TheByteAttic/TalosES/ALU card/Photos/IMG_3750.jpeg

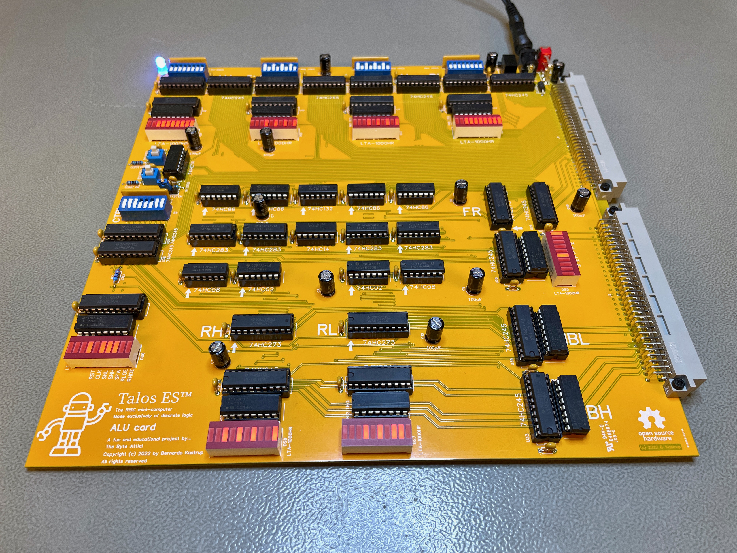
ALU card/Photos/IMG_3750.jpeg
