TheByteAttic/TalosES/AL card/Photos/IMG_1605.jpeg

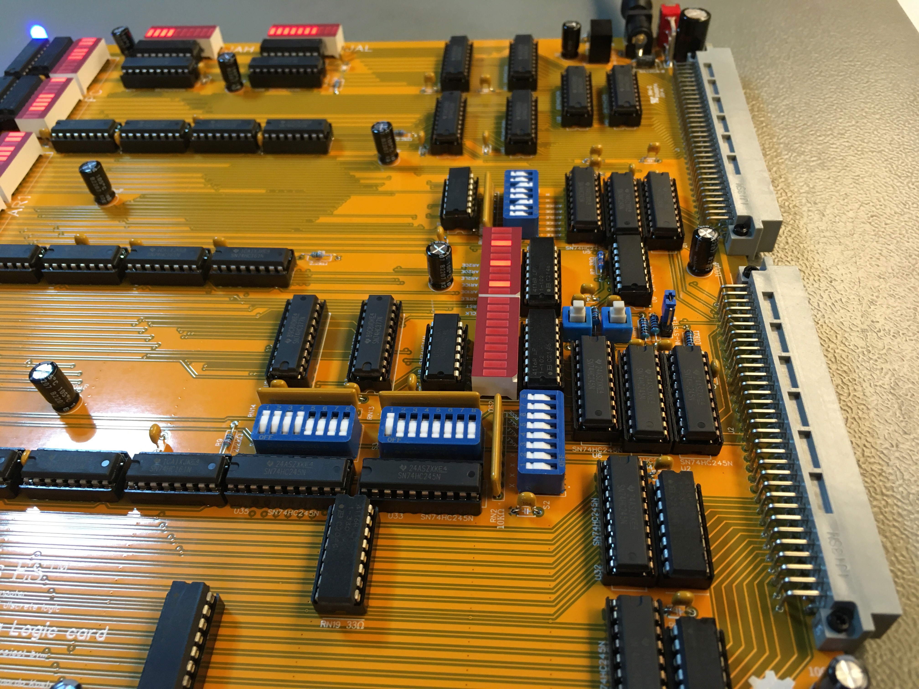
AL card/Photos/IMG_1605.jpeg
