TheByteAttic/TalosES/CTRL card/Photos/README.md

These are photos of a correctly assembled control card that could be used as reference for your assembling your own.
<p><br>
<b>ATTENTION:</b> The board illustrated in these photos differs slightly from the updated version (Gerber files) in this repository. This should be immaterial as far as using these photos as guidance during assembly is concerned, but you might note small differences.
