TheByteAttic/TalosES/CTRL card/DMs/README.md

Here you can find the binary (.bin) files for programming the four Decoding Memories (DMs) of Talos ES™'s control card. The devices I used have product number SST39SF020A.
