TheByteAttic/TalosES/Simulations/README.md

These directories contain the <a href="https://github.com/logisim-evolution/logisim-evolution">LogiSim-Evolution</a> source files of Talos ES™.
