TheByteAttic/TalosES/ISA/README.md

This directory contains the spreadsheet (in both Excel and CSV formats) documenting Talos ES™'s CPU instructions.
