TheByteAttic/TalosES/Third-party documentation/README.md

Datasheets of some of the less common parts used in Talos ES™, as well as other relevant documentation from third-parties.
