TheByteAttic/TalosES/Simulations/Motherboard/README.md

These LogiSim-Evolution files simulate only small segments of Talos ES™'s motherboard circuitry, <i>not</i> the complete motherboard.
They are mostly for illustration purposes, as they have been used <a href="https://youtu.be/EE-lTyt0x98">in a video</a> and viewers may want to study them more closely.
<p>
The LogiSim-Evolution repository <a href="https://github.com/logisim-evolution/logisim-evolution">can be found here.</a>
