TheByteAttic/TalosES/AL card/Photos/IMG_1593.jpeg

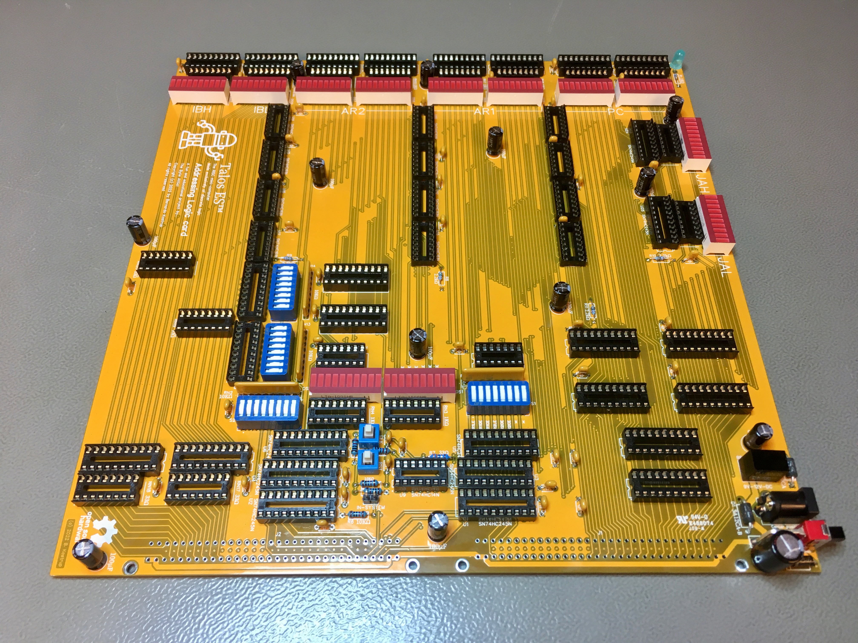
AL card/Photos/IMG_1593.jpeg
