TheByteAttic/TalosES/AL card/Photos/IMG_1594.jpeg

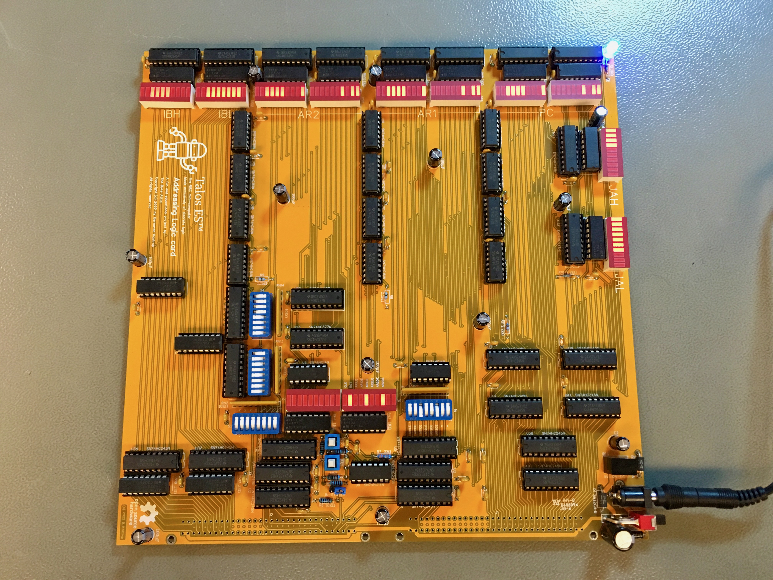
AL card/Photos/IMG_1594.jpeg
