TheByteAttic/TalosES/AL card/Photos/IMG_1595.jpeg

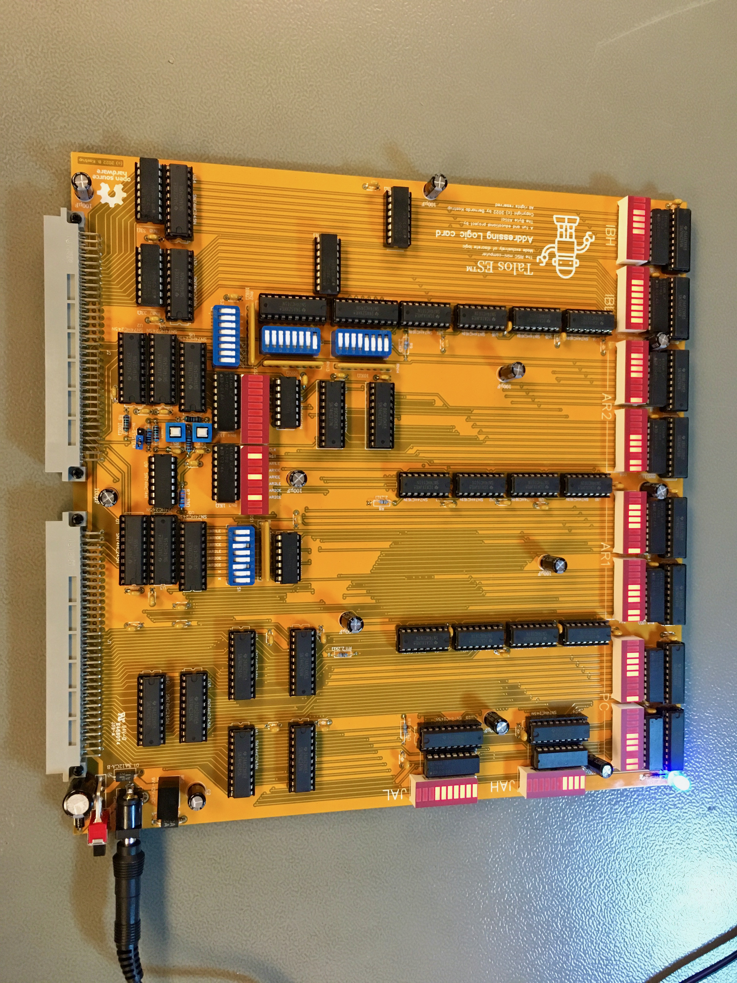
AL card/Photos/IMG_1595.jpeg
