TheByteAttic/TalosES/AL card/Photos/IMG_1597.jpeg

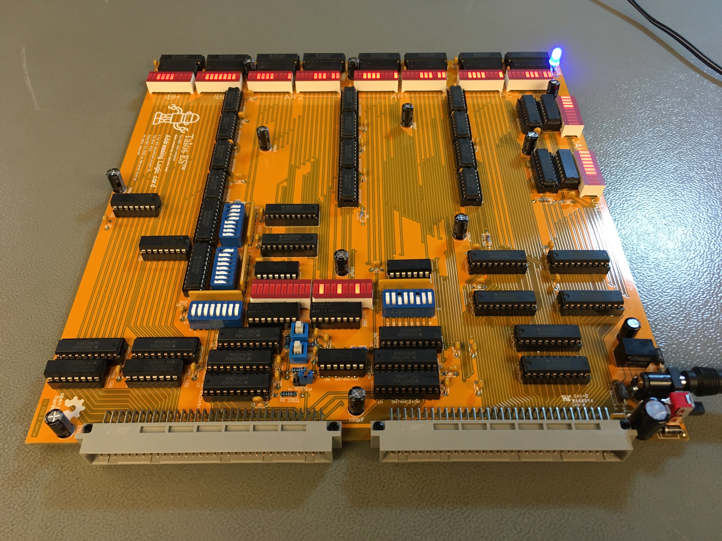
AL card/Photos/IMG_1597.jpeg
