TheByteAttic/TalosES/AL card/Photos/IMG_1598.jpeg

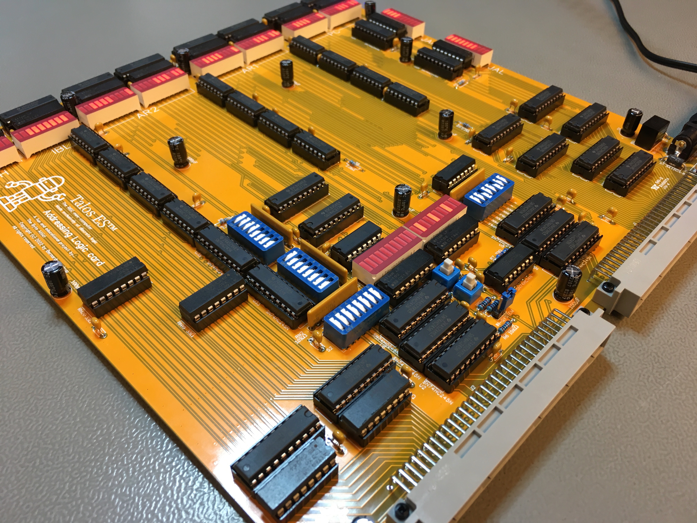
AL card/Photos/IMG_1598.jpeg
