TheByteAttic/TalosES/AL card/Photos/IMG_1599.jpeg

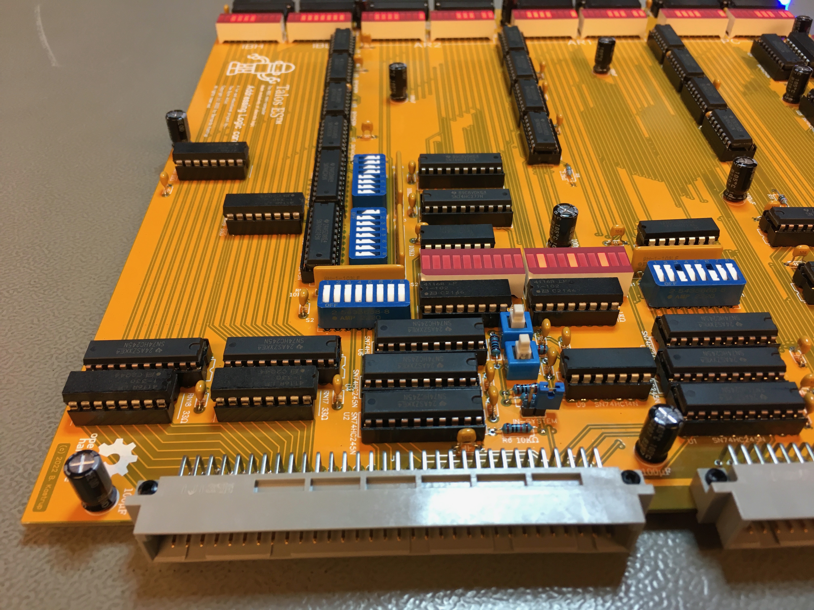
AL card/Photos/IMG_1599.jpeg
