TheByteAttic/TalosES/AL card/Photos/IMG_1600.jpeg

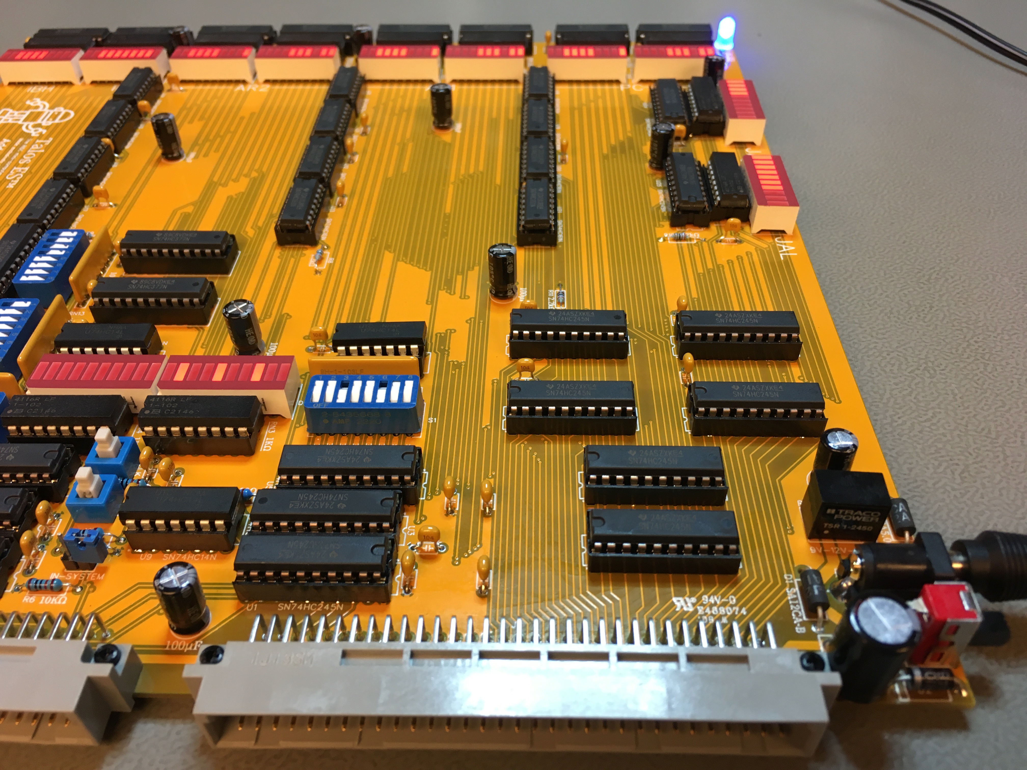
AL card/Photos/IMG_1600.jpeg
