TheByteAttic/TalosES/AL card/Photos/IMG_1601.jpeg

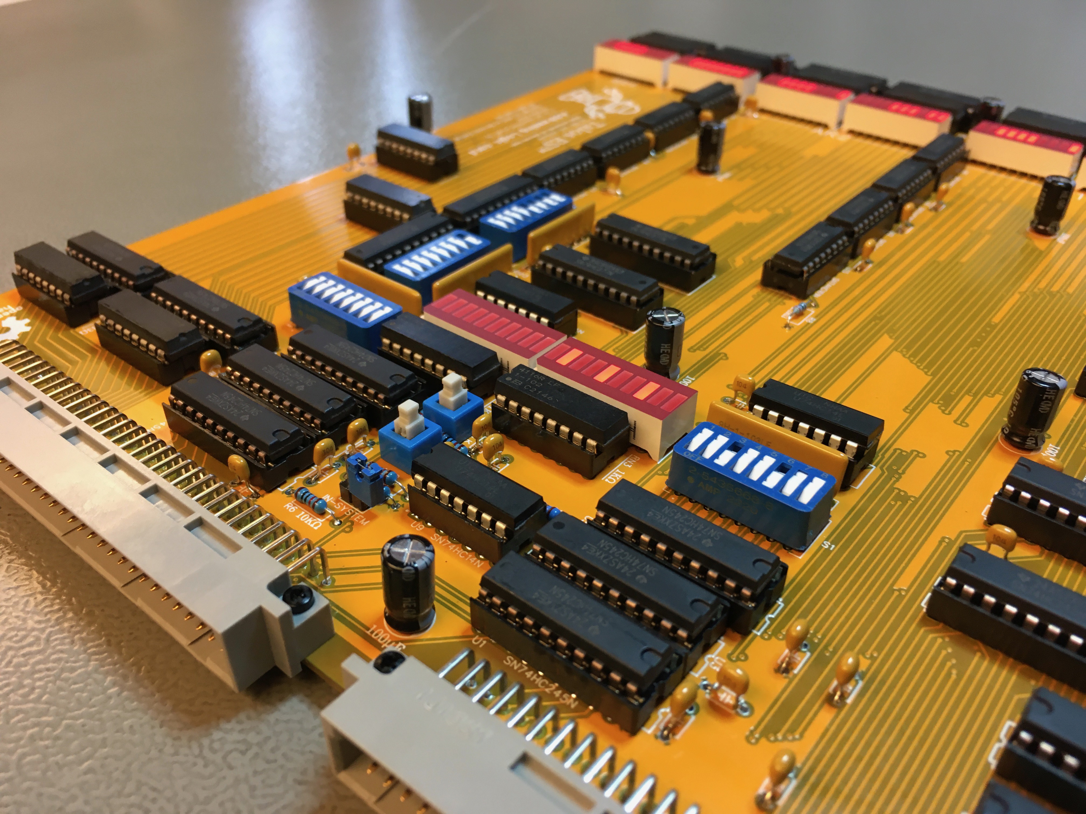
AL card/Photos/IMG_1601.jpeg
