TheByteAttic/TalosES/AL card/Photos/IMG_1602.jpeg

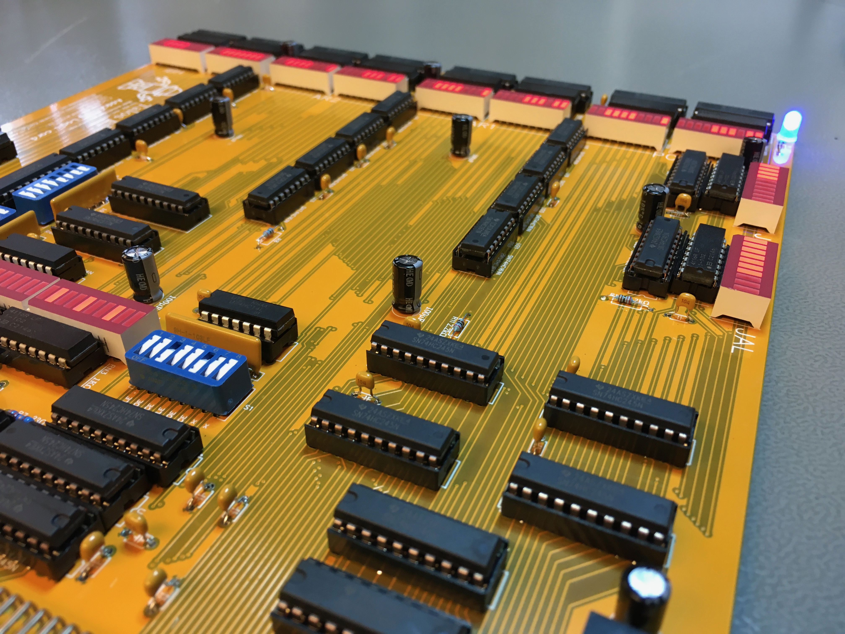
AL card/Photos/IMG_1602.jpeg
