TheByteAttic/TalosES/AL card/Photos/IMG_1603.jpeg

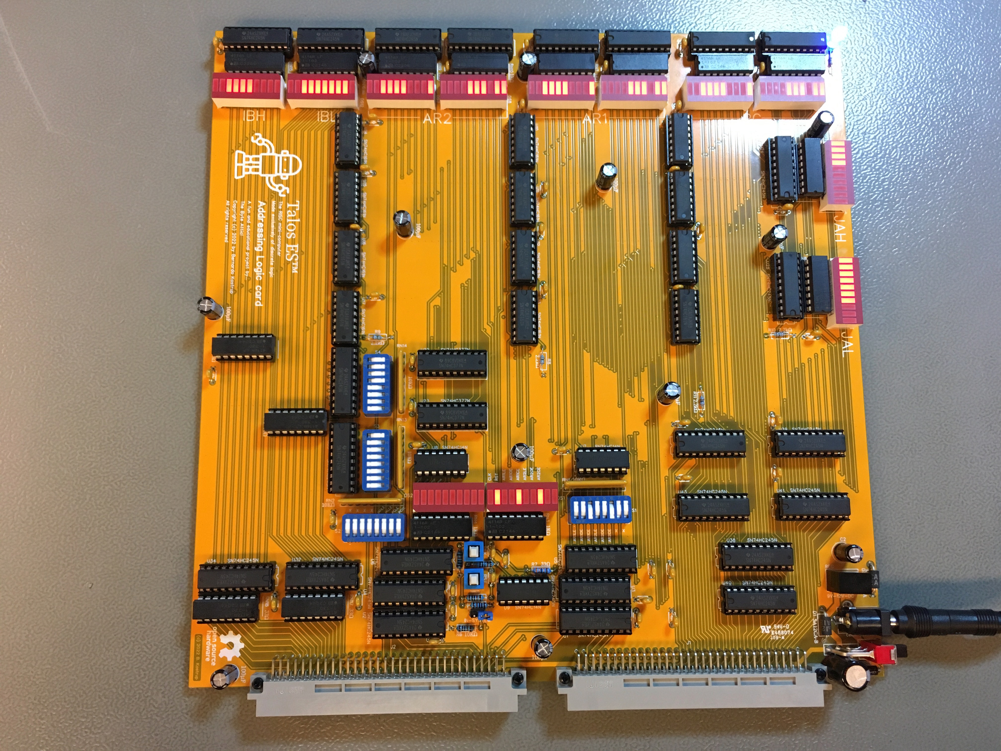
AL card/Photos/IMG_1603.jpeg
