TheByteAttic/TalosES/AL card/Photos/IMG_1604.jpeg

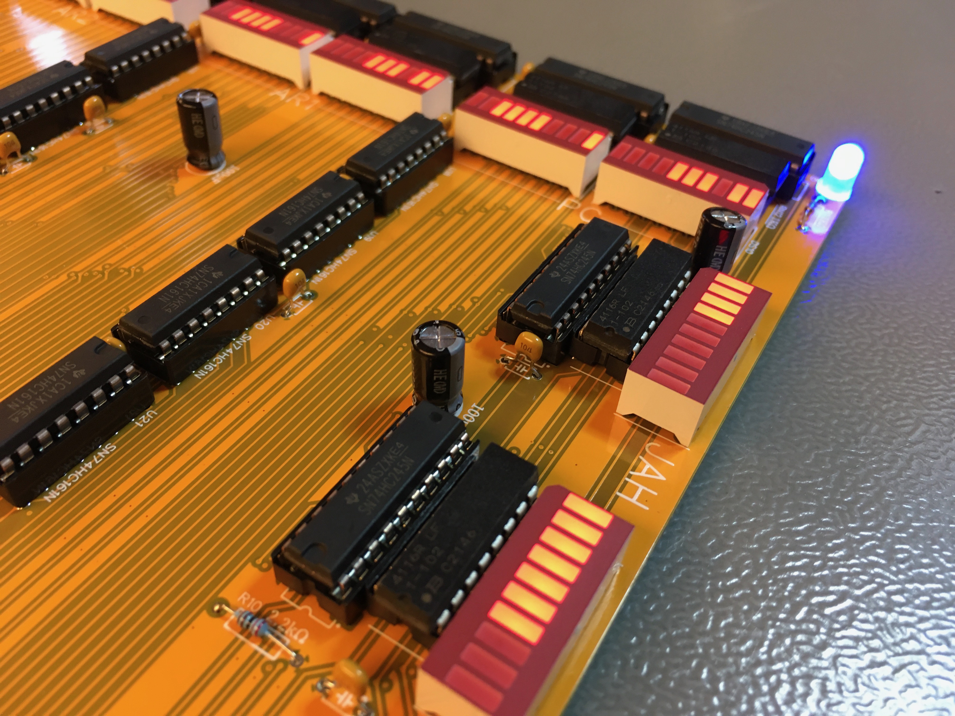
AL card/Photos/IMG_1604.jpeg
