TheByteAttic/TalosES/AL card/Photos/IMG_1606.jpeg

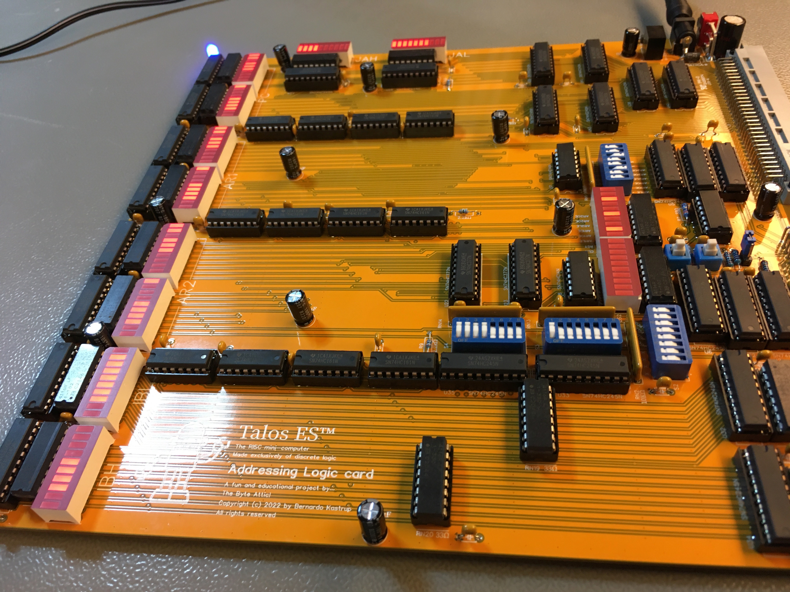
AL card/Photos/IMG_1606.jpeg
