TheByteAttic/TalosES/AL card/Photos/IMG_1607.jpeg

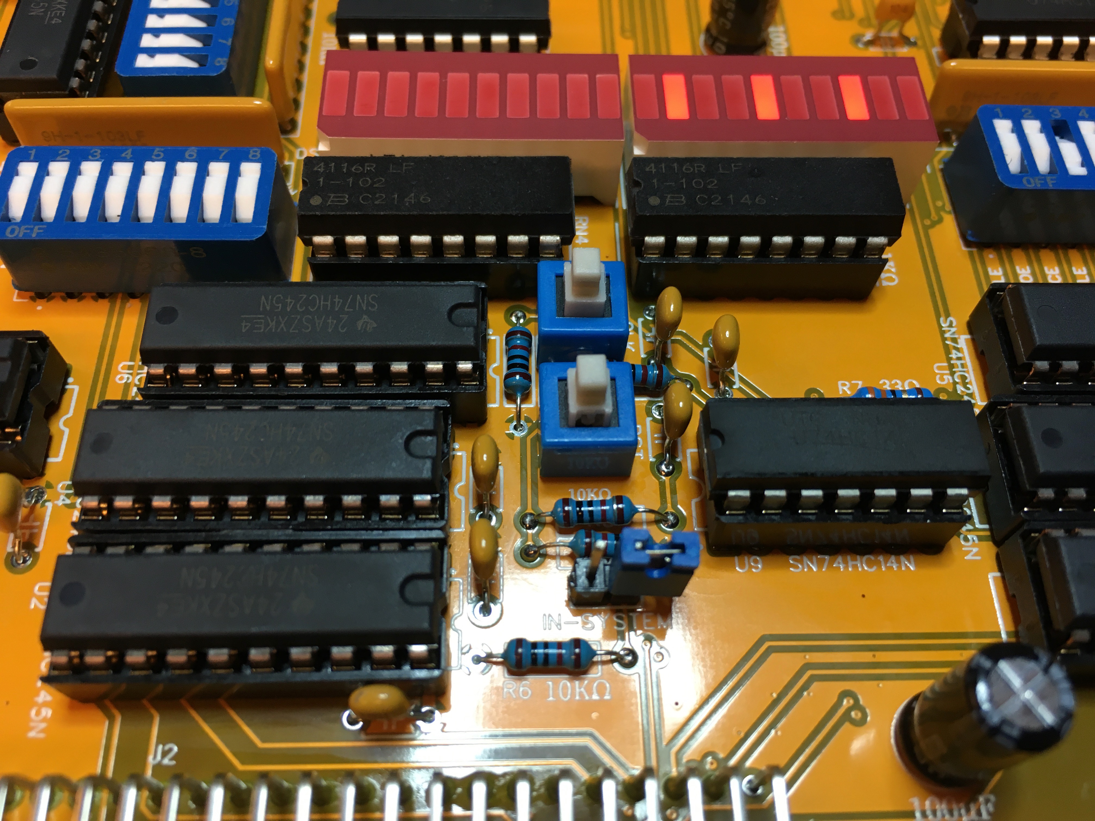
AL card/Photos/IMG_1607.jpeg
