TheByteAttic/TalosES/AL card/Photos/IMG_1608.jpeg

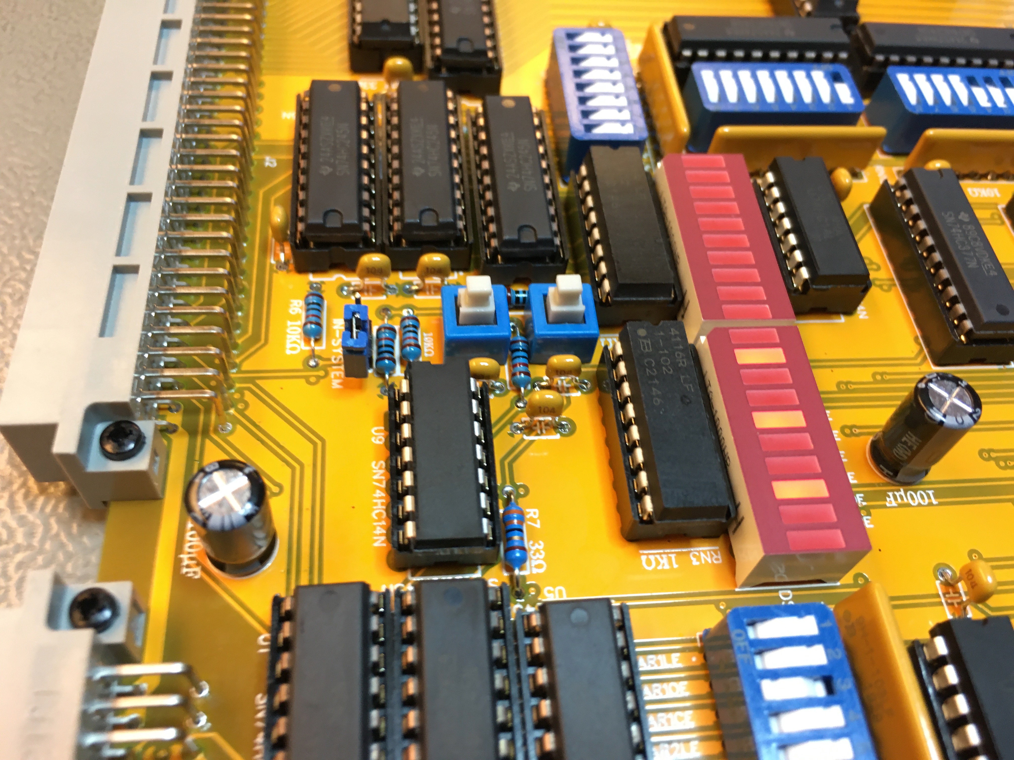
AL card/Photos/IMG_1608.jpeg
