TheByteAttic/TalosES/AL card/Photos/IMG_1609.jpeg

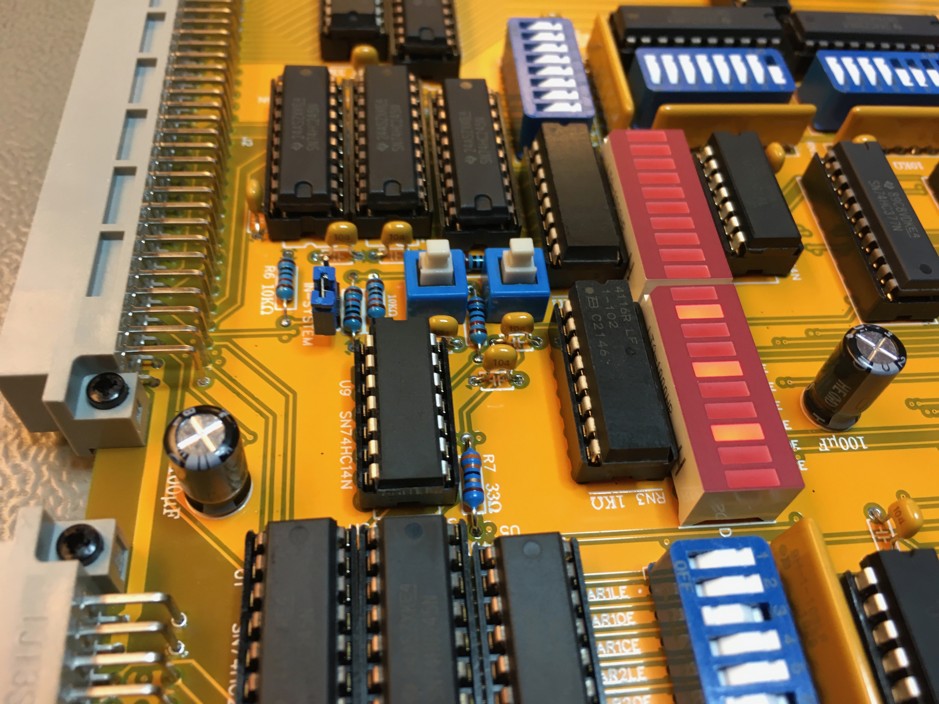
AL card/Photos/IMG_1609.jpeg
