TheByteAttic/TalosES/AL card/Photos/IMG_1610.jpeg

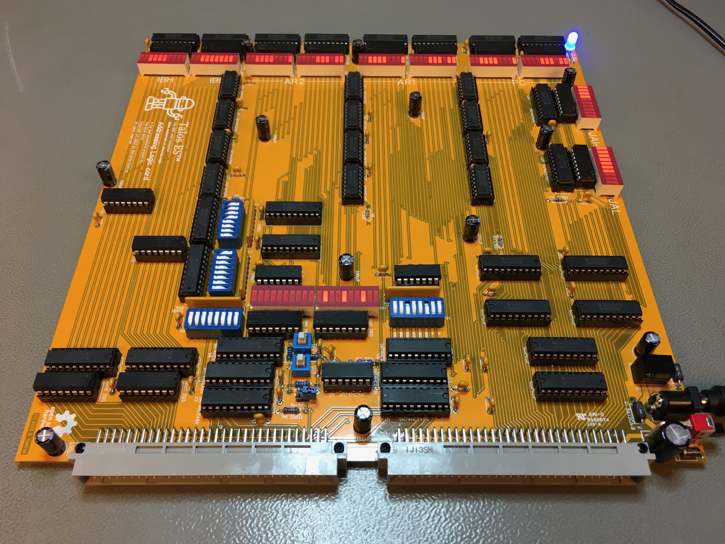
AL card/Photos/IMG_1610.jpeg
