TheByteAttic/TalosES/AL card/Photos/IMG_1611.jpeg

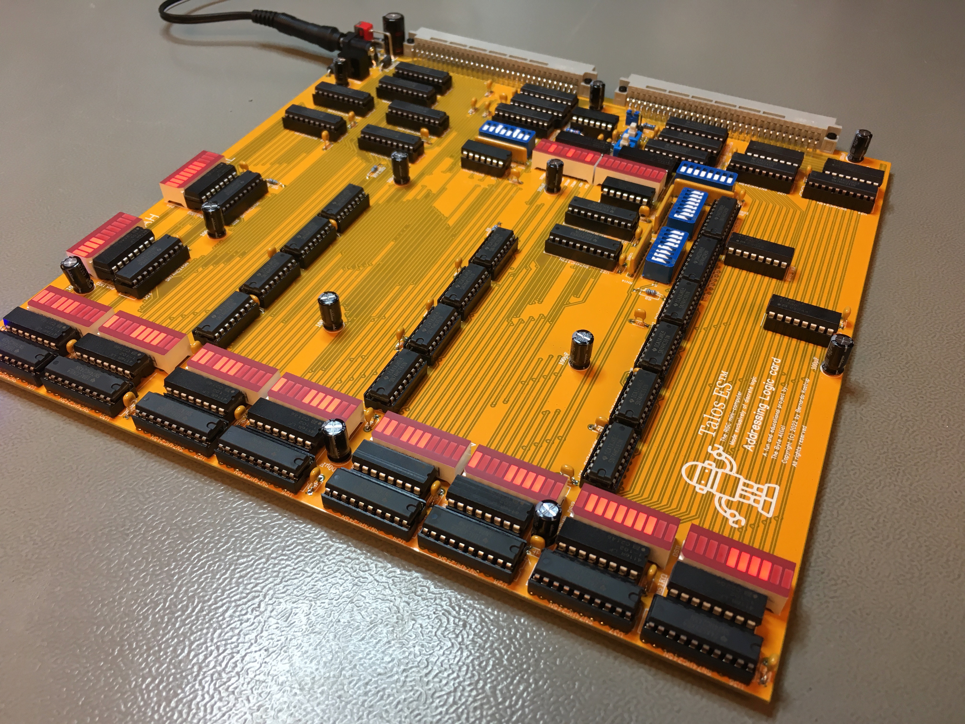
AL card/Photos/IMG_1611.jpeg
