TheByteAttic/TalosES/AL card/Photos/IMG_1612.jpeg

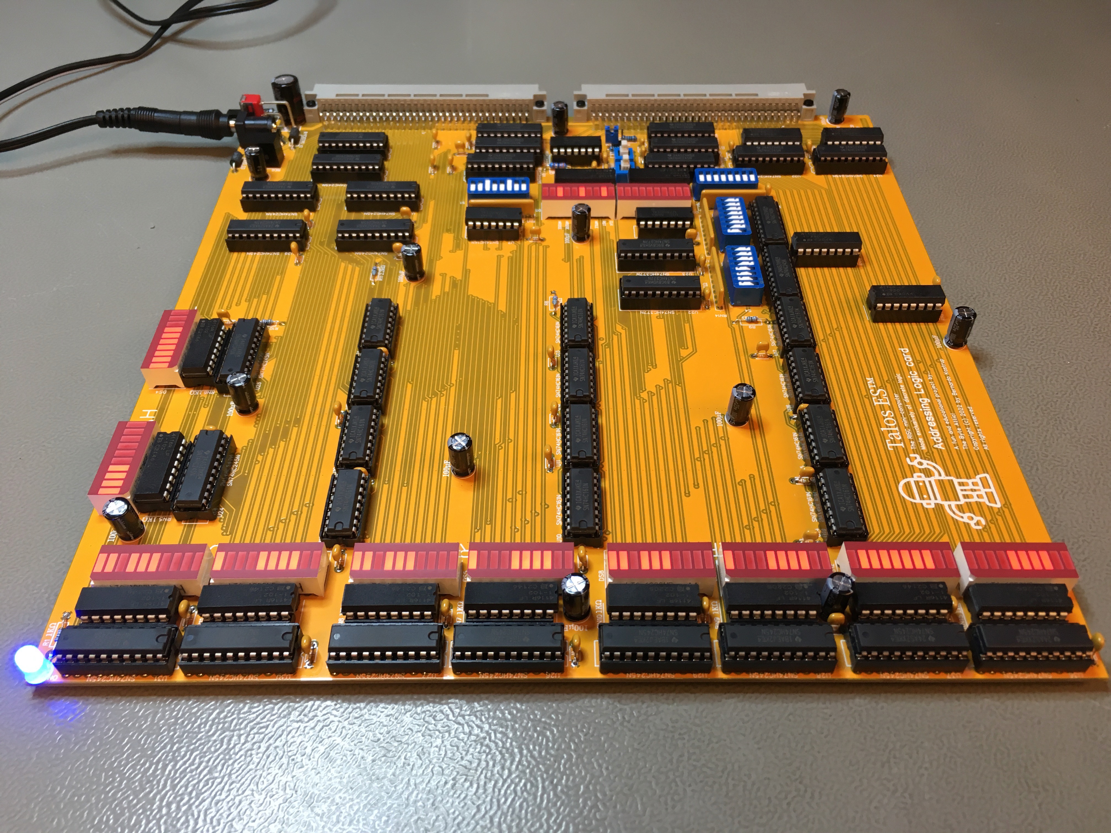
AL card/Photos/IMG_1612.jpeg
