TheByteAttic/TalosES/AL card/Photos/IMG_1613.jpeg

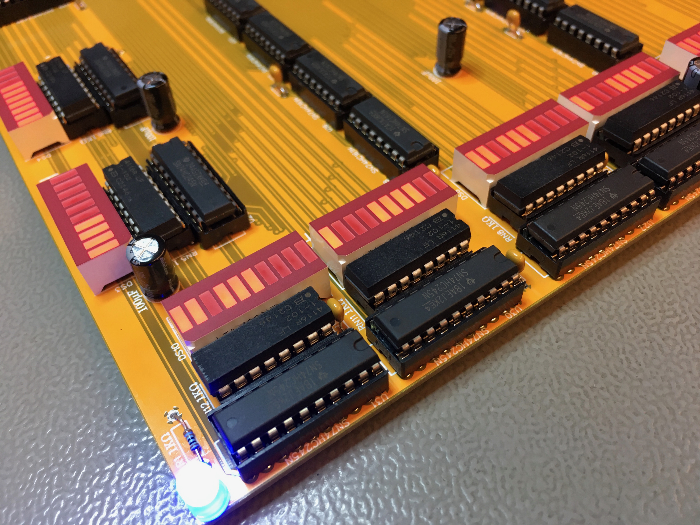
AL card/Photos/IMG_1613.jpeg
