TheByteAttic/TalosES/AL card/Photos/IMG_1614.jpeg

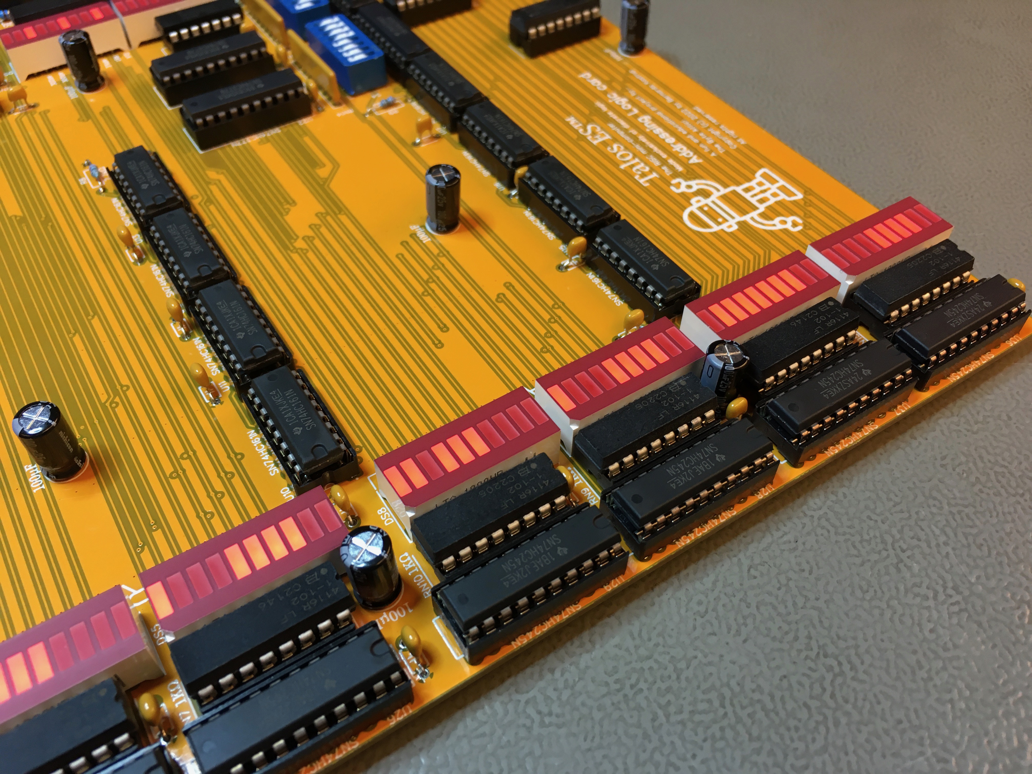
AL card/Photos/IMG_1614.jpeg
