TheByteAttic/TalosES/AL card/Photos/IMG_1615.jpeg

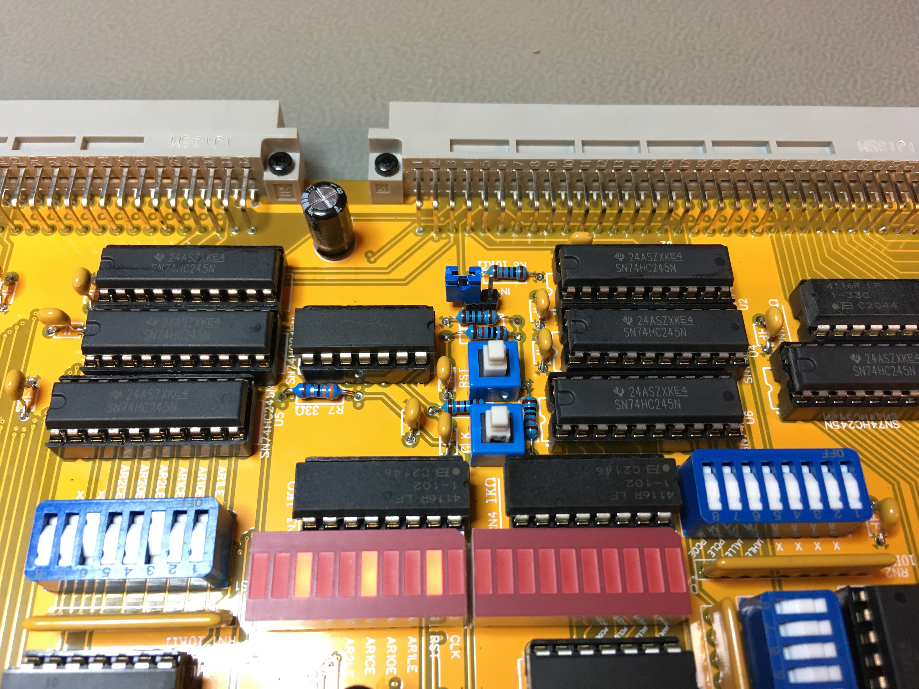
AL card/Photos/IMG_1615.jpeg
