TheByteAttic/TalosES/AL card/Photos/IMG_1616.jpeg

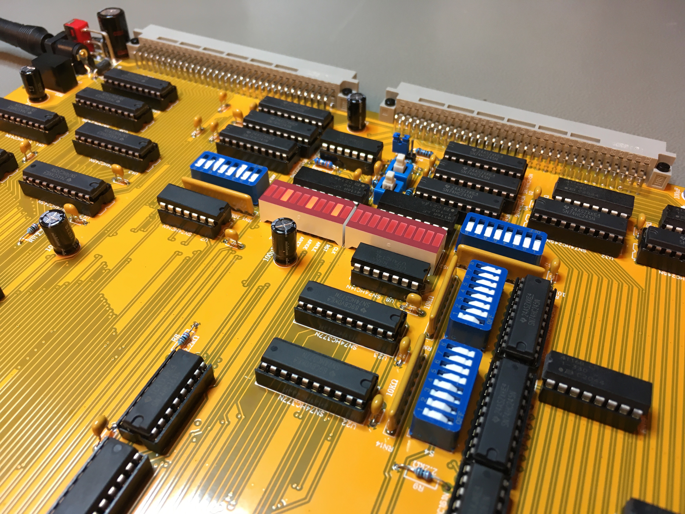
AL card/Photos/IMG_1616.jpeg
