TheByteAttic/TalosES/AL card/Photos/IMG_1617.jpeg

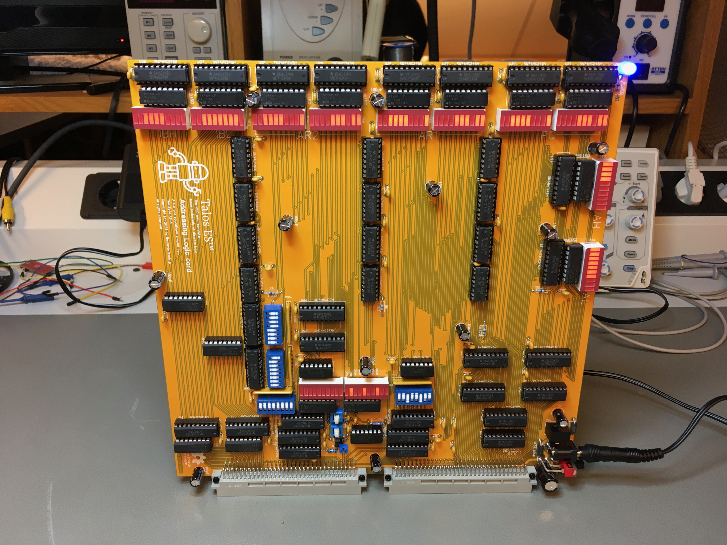
AL card/Photos/IMG_1617.jpeg
