TheByteAttic/TalosES/AL card/Photos/IMG_1618.jpeg

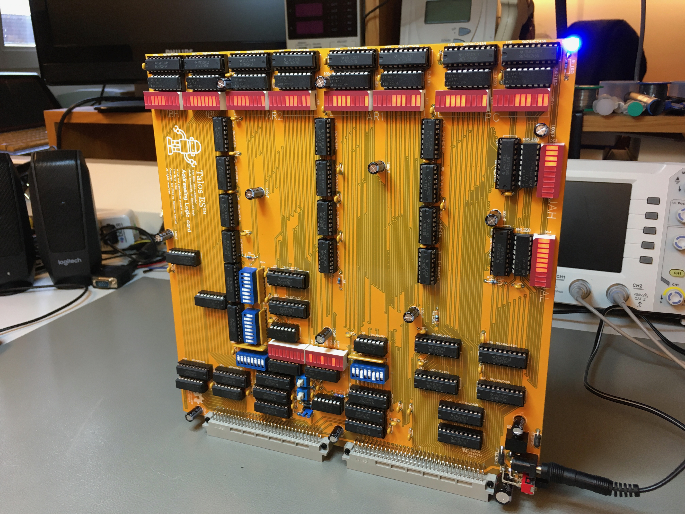
AL card/Photos/IMG_1618.jpeg
