TheByteAttic/TalosES/AL card/Photos/IMG_1619.jpeg

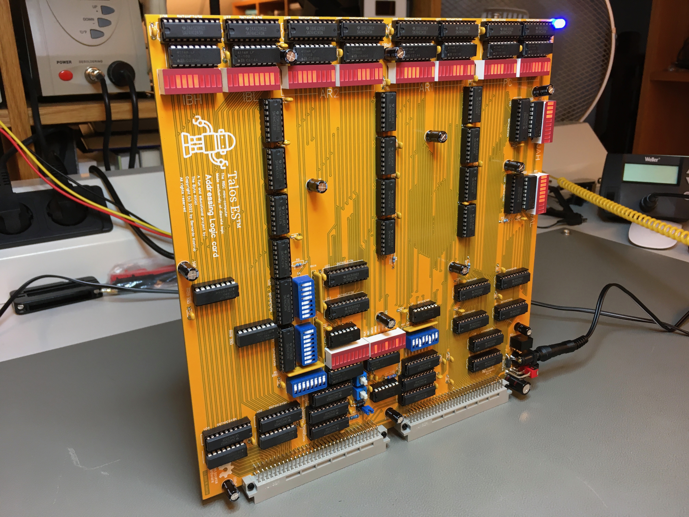
AL card/Photos/IMG_1619.jpeg
