TheByteAttic/TalosES/AL card/Photos/IMG_1620.jpeg

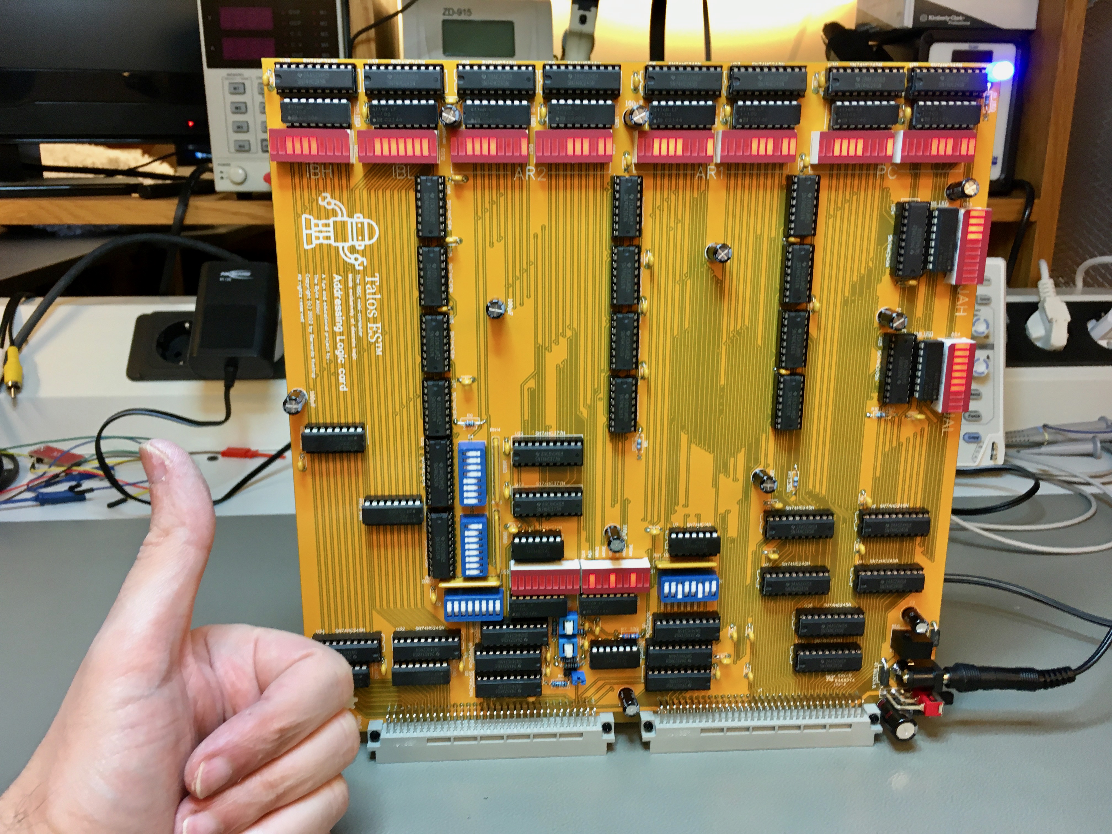
AL card/Photos/IMG_1620.jpeg
