TheByteAttic/TalosES/ALU card/Photos/IMG_3749.jpeg

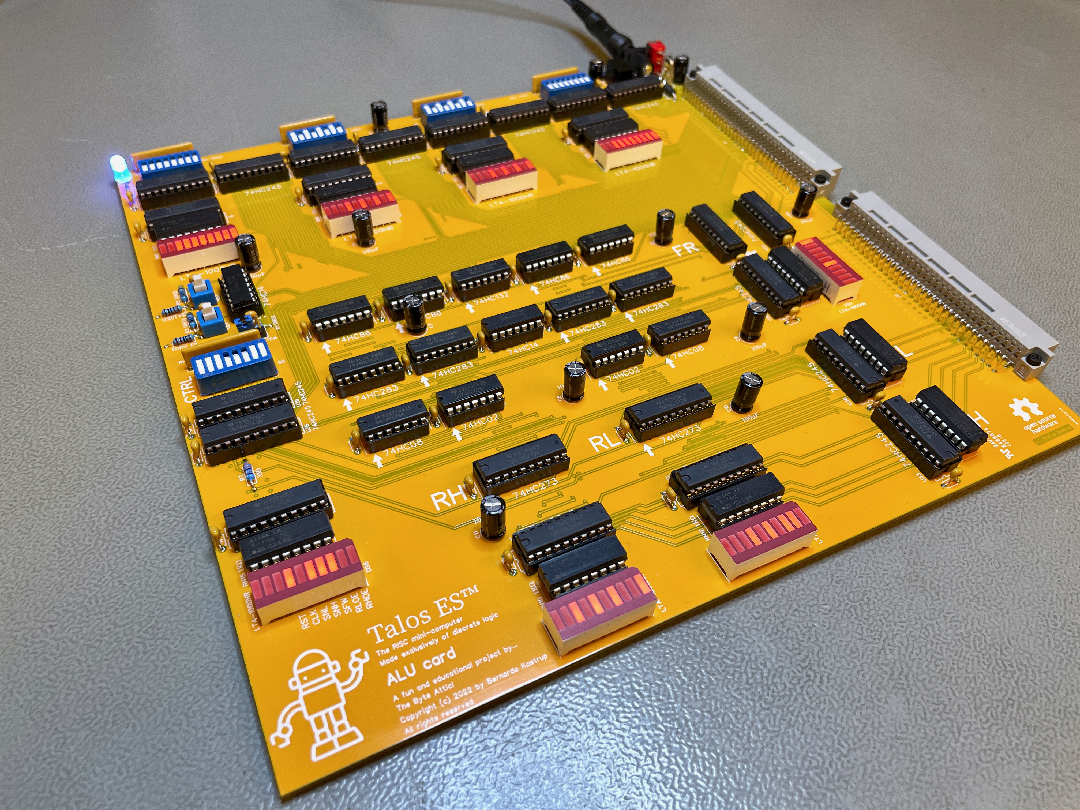
ALU card/Photos/IMG_3749.jpeg
