TheByteAttic/TalosES/ALU card/Photos/IMG_3751.jpeg

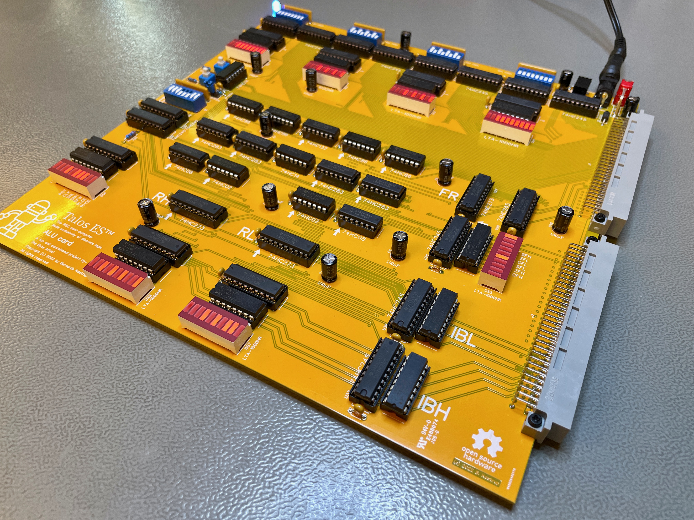
ALU card/Photos/IMG_3751.jpeg
