TheByteAttic/TalosES/ALU card/Photos/IMG_3752.jpeg

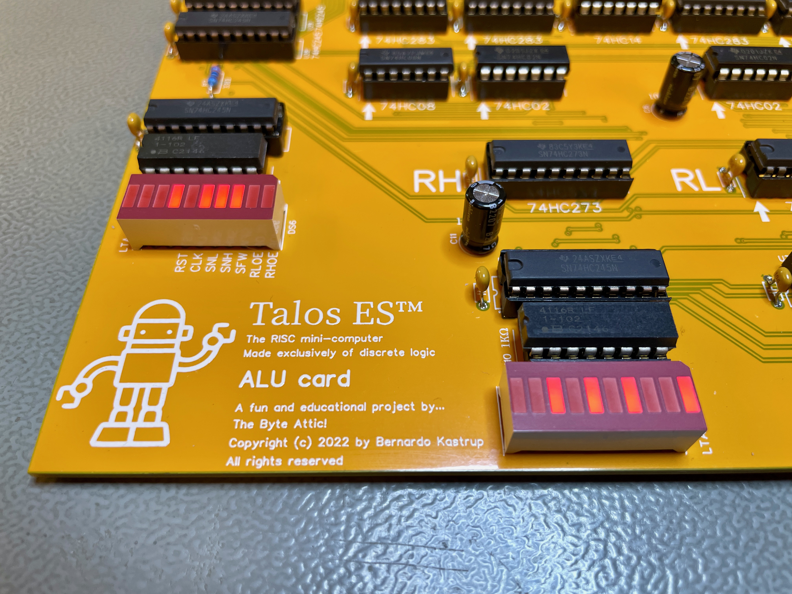
ALU card/Photos/IMG_3752.jpeg
