TheByteAttic/TalosES/ALU card/Photos/IMG_3753.jpeg

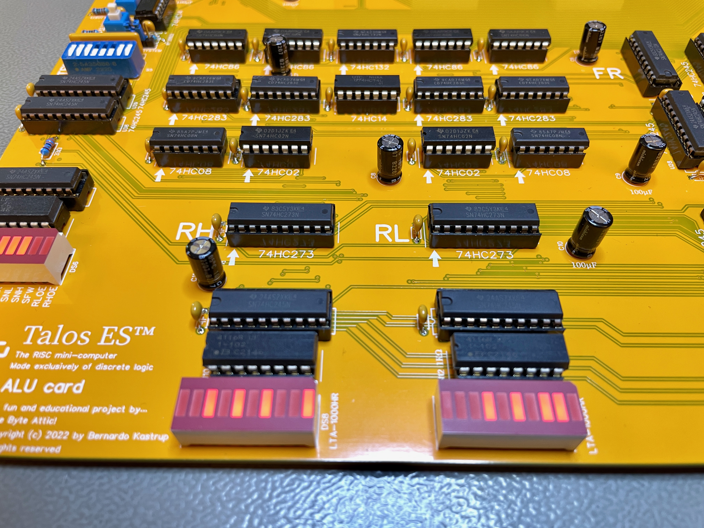
ALU card/Photos/IMG_3753.jpeg
