TheByteAttic/TalosES/ALU card/Photos/IMG_3754.jpeg

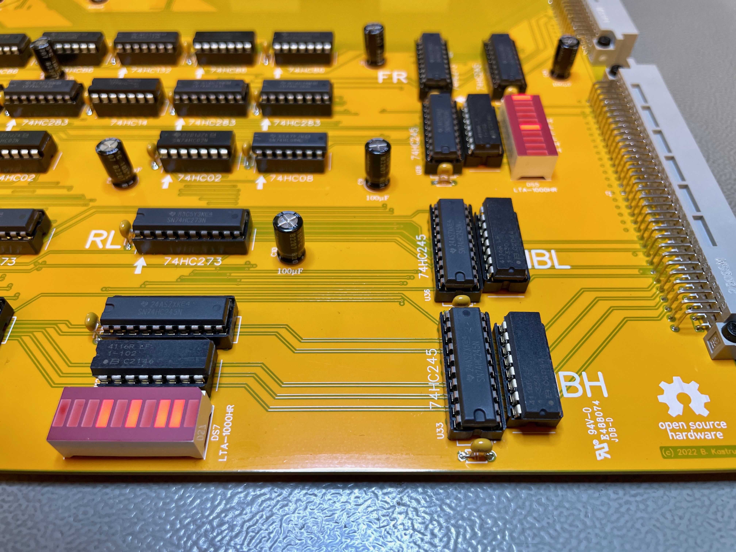
ALU card/Photos/IMG_3754.jpeg
