TheByteAttic/TalosES/ALU card/Photos/IMG_3755.jpeg

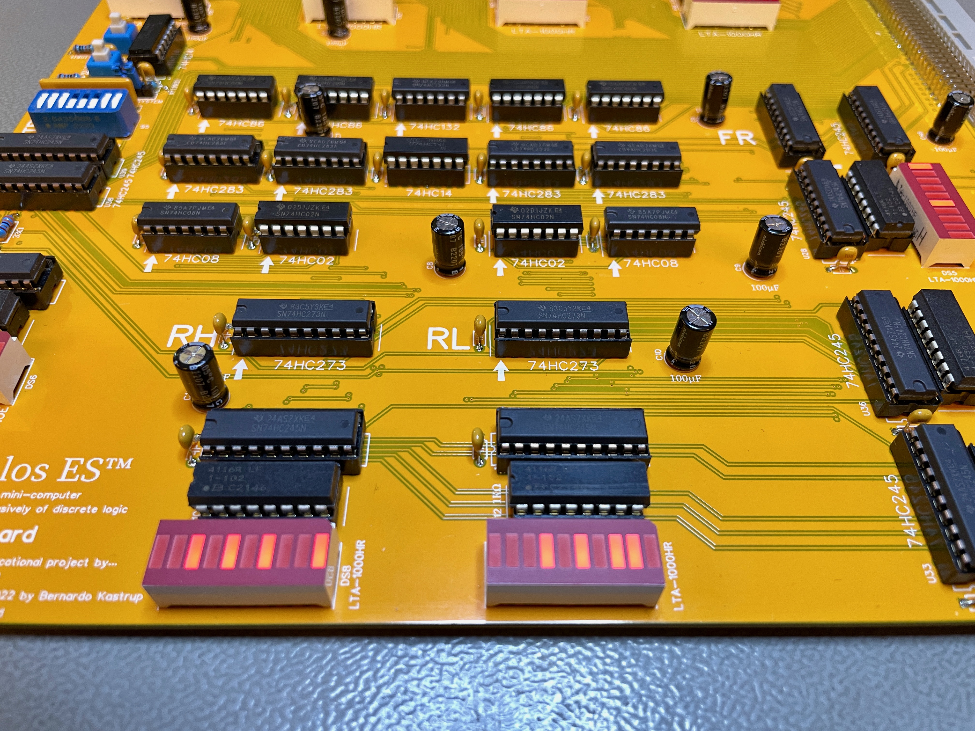
ALU card/Photos/IMG_3755.jpeg
