TheByteAttic/TalosES/ALU card/Photos/IMG_3756.jpeg

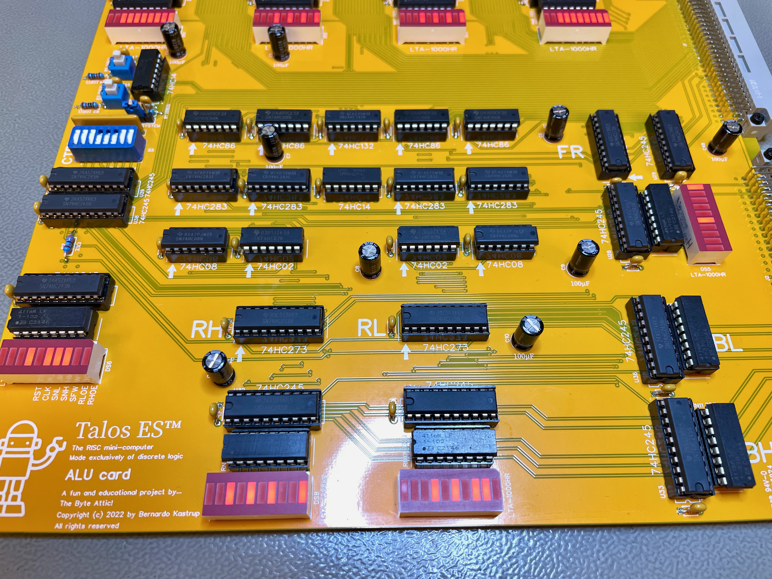
ALU card/Photos/IMG_3756.jpeg
