TheByteAttic/TalosES/ALU card/Photos/IMG_3757.jpeg

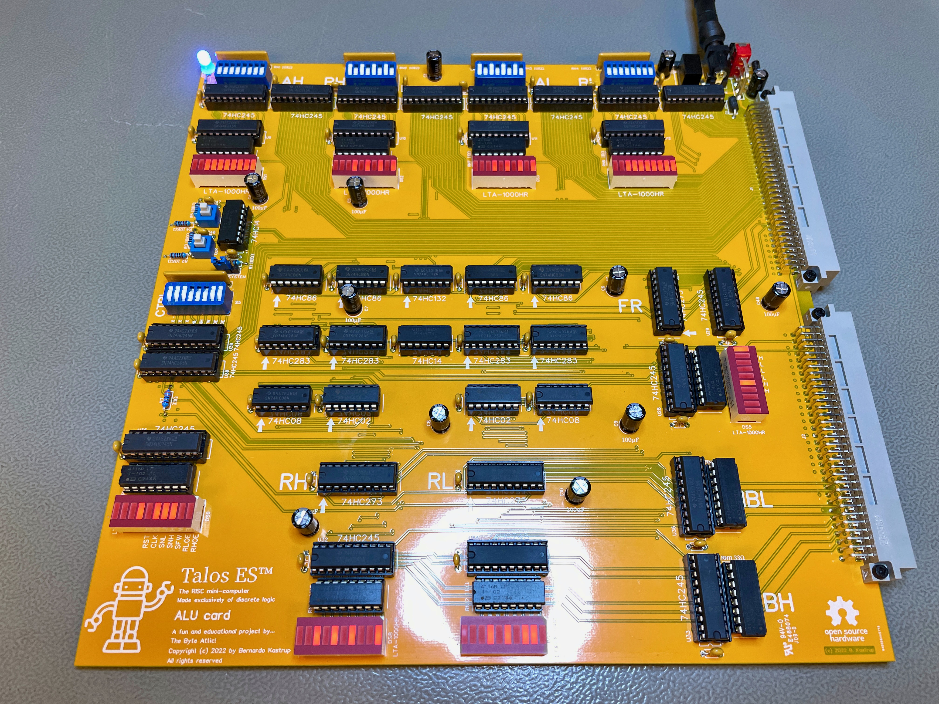
ALU card/Photos/IMG_3757.jpeg
