TheByteAttic/TalosES/ALU card/Photos/IMG_3758.jpeg

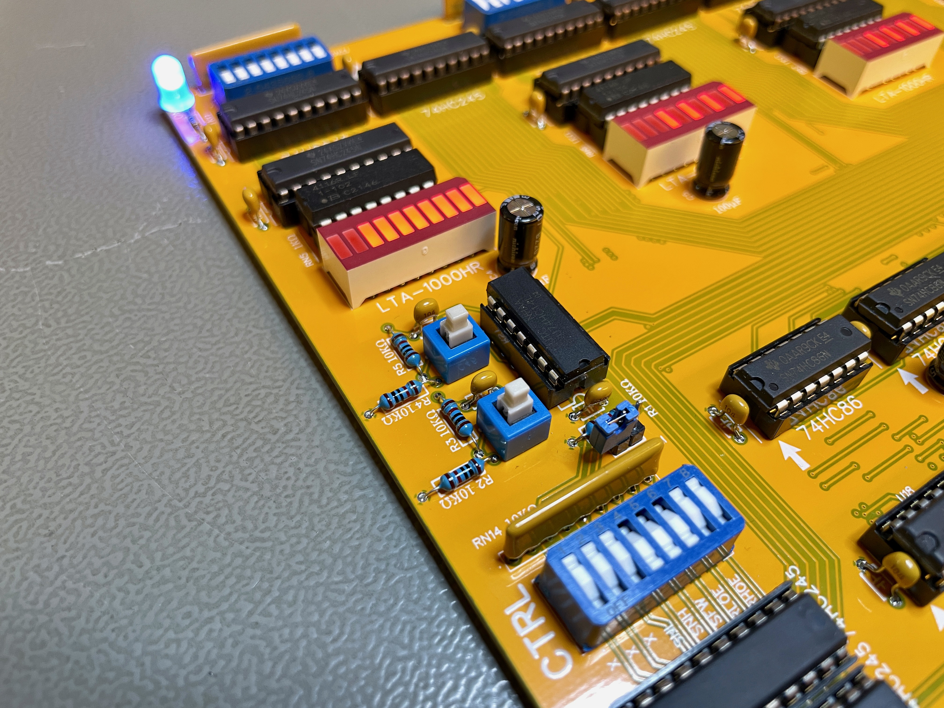
ALU card/Photos/IMG_3758.jpeg
