TheByteAttic/TalosES/ALU card/Photos/IMG_3759.jpeg

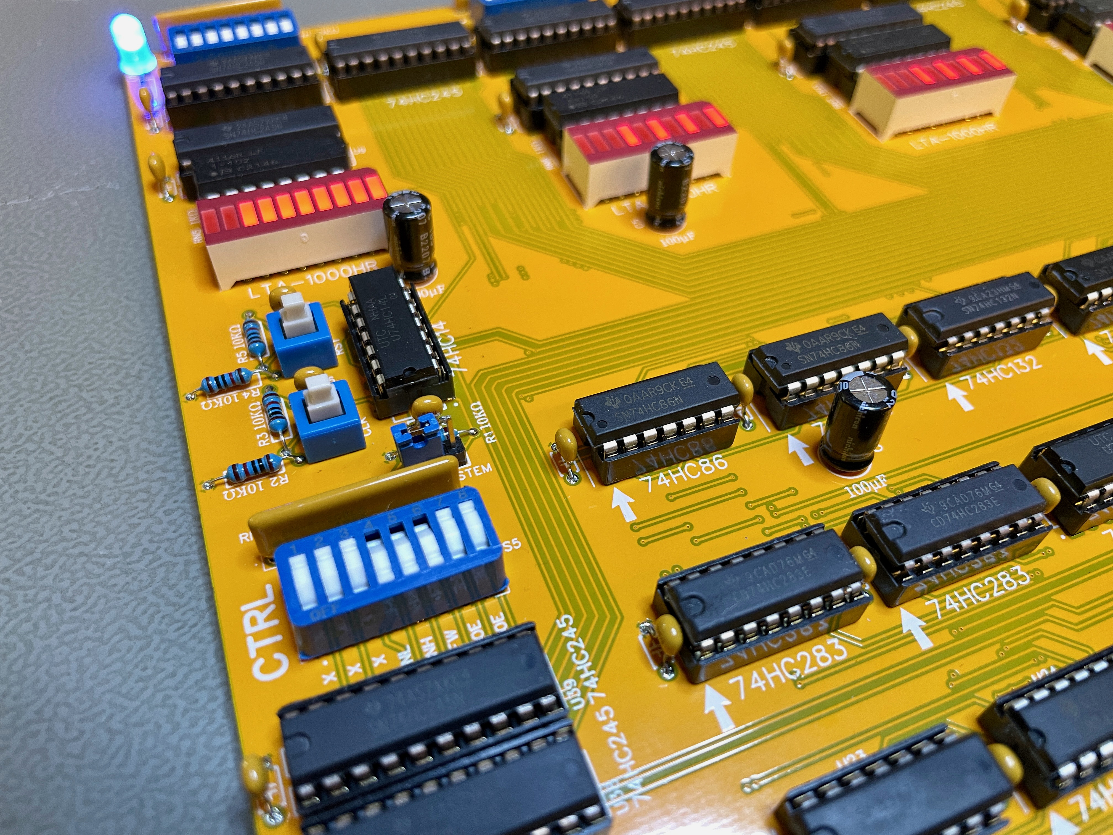
ALU card/Photos/IMG_3759.jpeg
