TheByteAttic/TalosES/ALU card/Photos/IMG_3760.jpeg

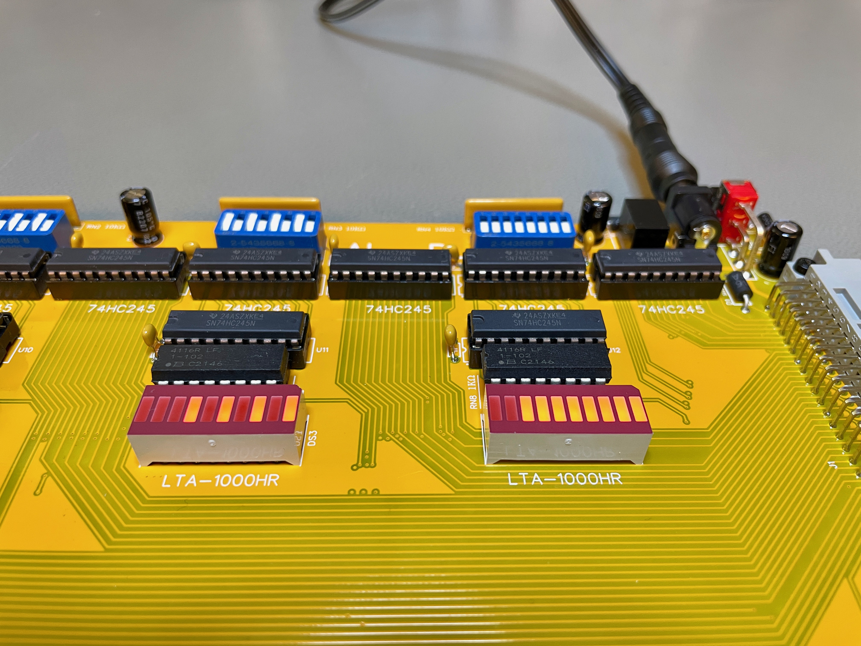
ALU card/Photos/IMG_3760.jpeg
