TheByteAttic/TalosES/ALU card/Photos/IMG_3761.jpeg

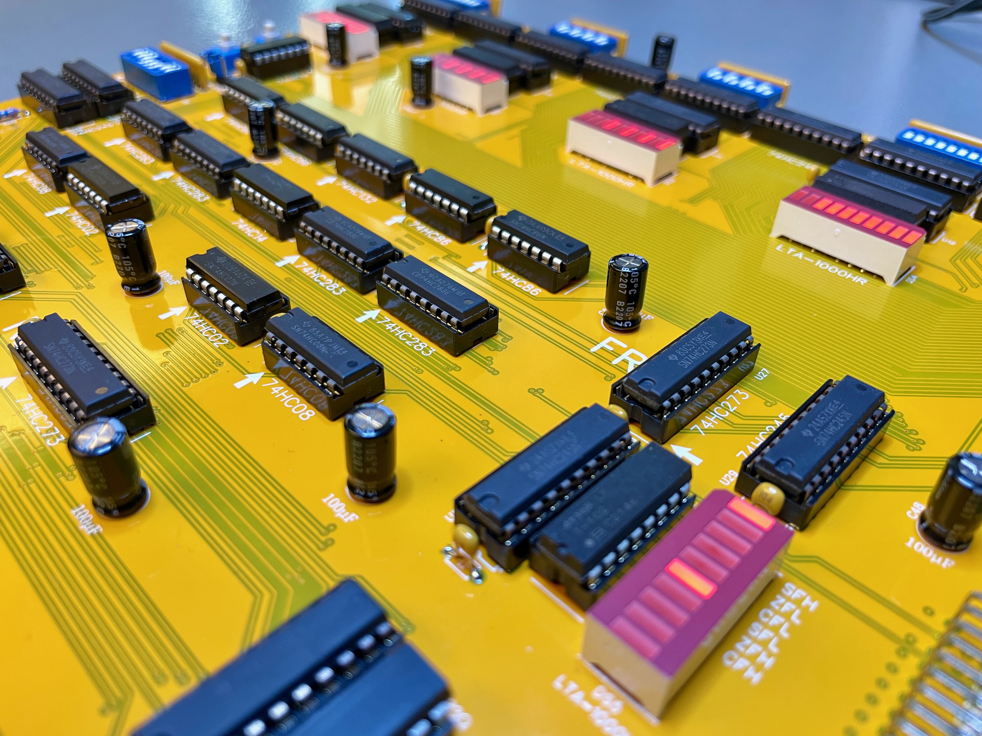
ALU card/Photos/IMG_3761.jpeg
