TheByteAttic/TalosES/ALU card/Photos/IMG_3762.jpeg

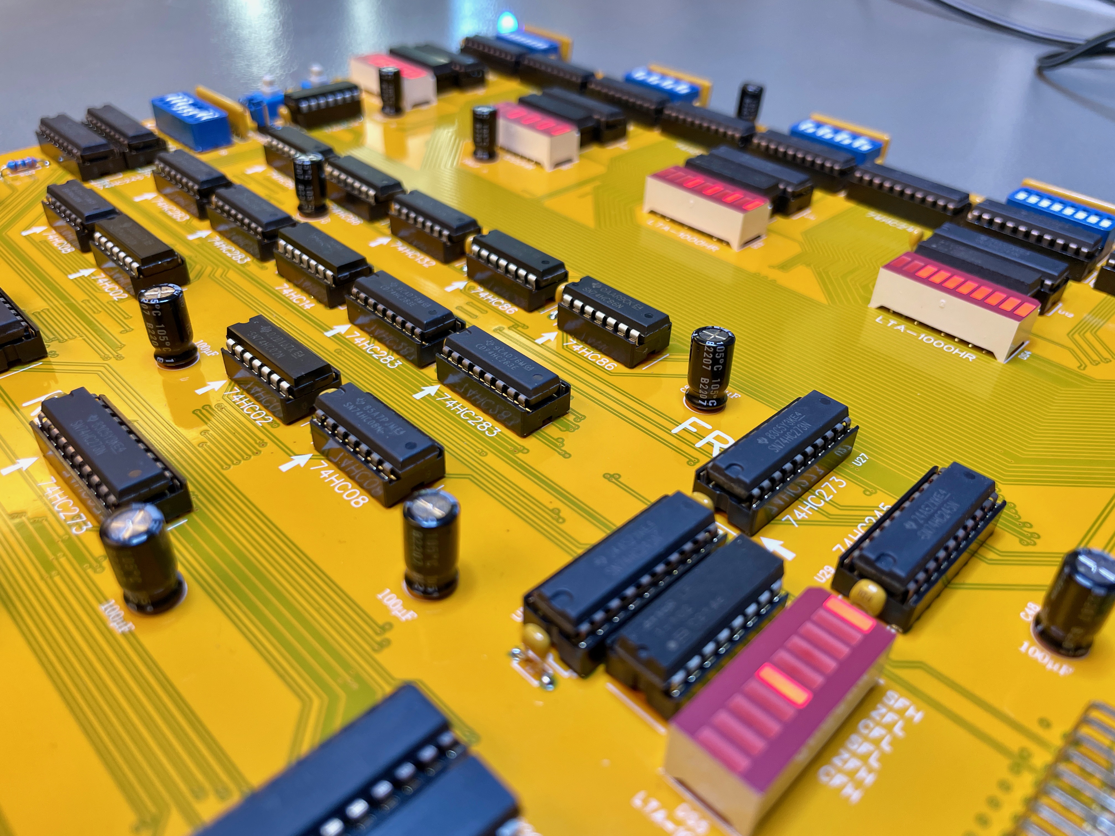
ALU card/Photos/IMG_3762.jpeg
