TheByteAttic/TalosES/ALU card/Photos/IMG_3763.jpeg

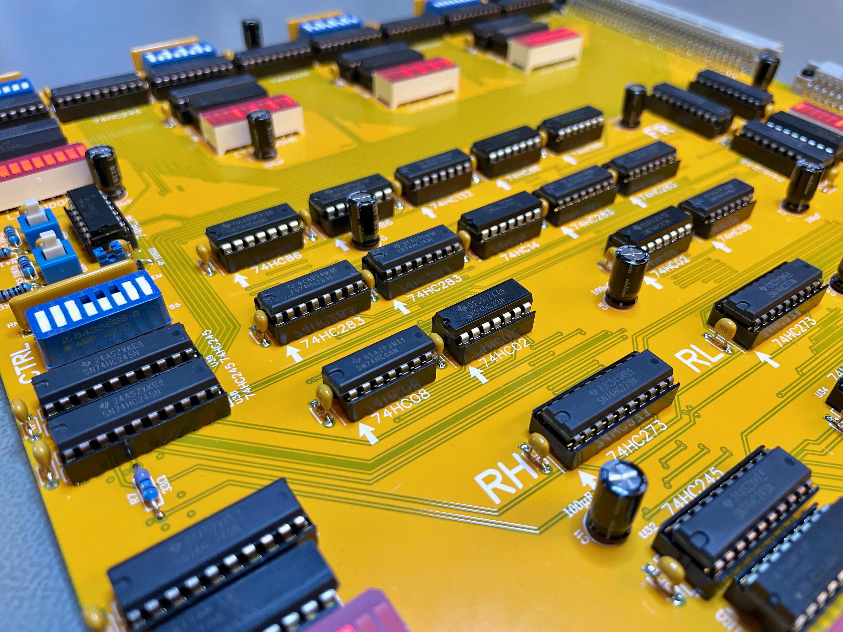
ALU card/Photos/IMG_3763.jpeg
