TheByteAttic/TalosES/ALU card/Photos/IMG_3764.jpeg

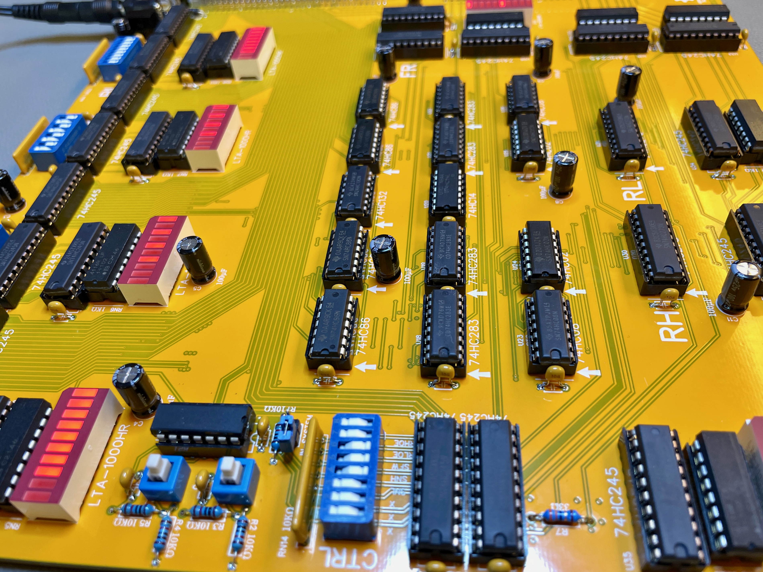
ALU card/Photos/IMG_3764.jpeg
