TheByteAttic/TalosES/ALU card/Photos/IMG_3765.jpeg

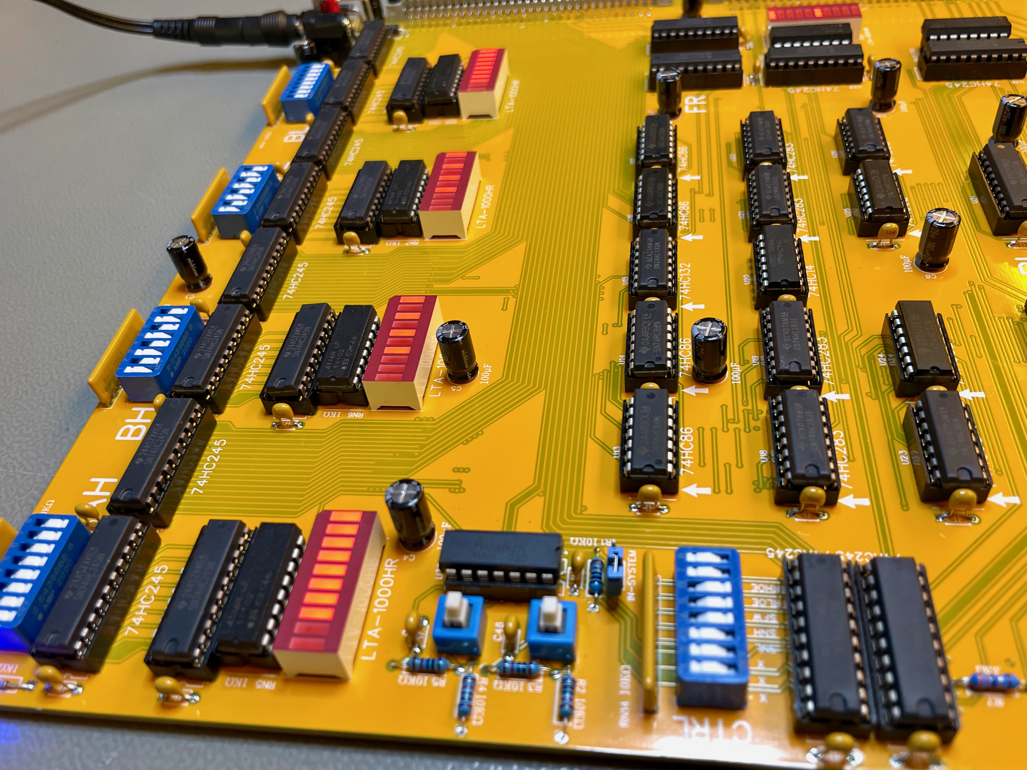
ALU card/Photos/IMG_3765.jpeg
