TheByteAttic/TalosES/ALU card/Photos/IMG_3766.jpeg

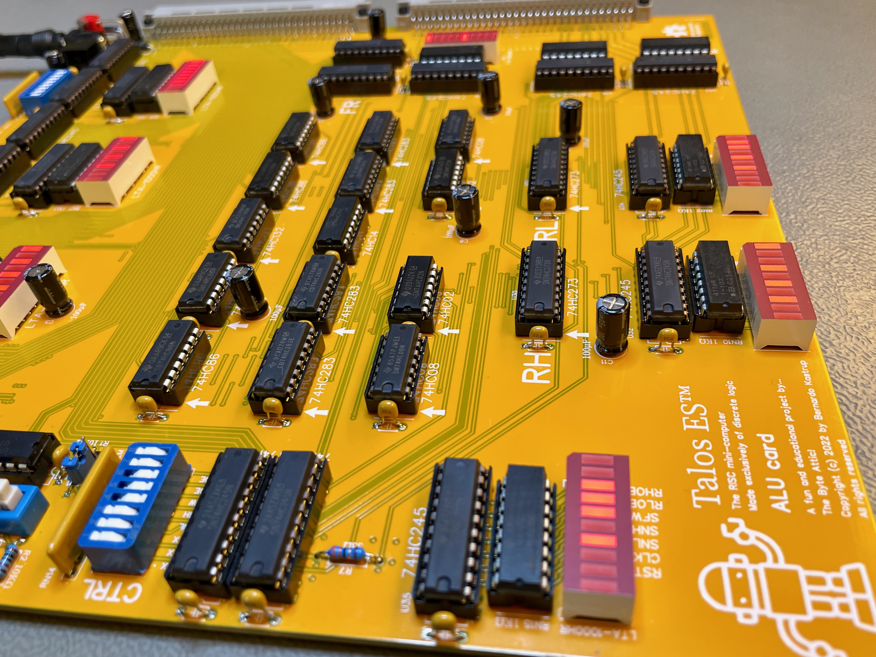
ALU card/Photos/IMG_3766.jpeg
