TheByteAttic/TalosES/CTRL card/Photos/IMG_5762.jpeg

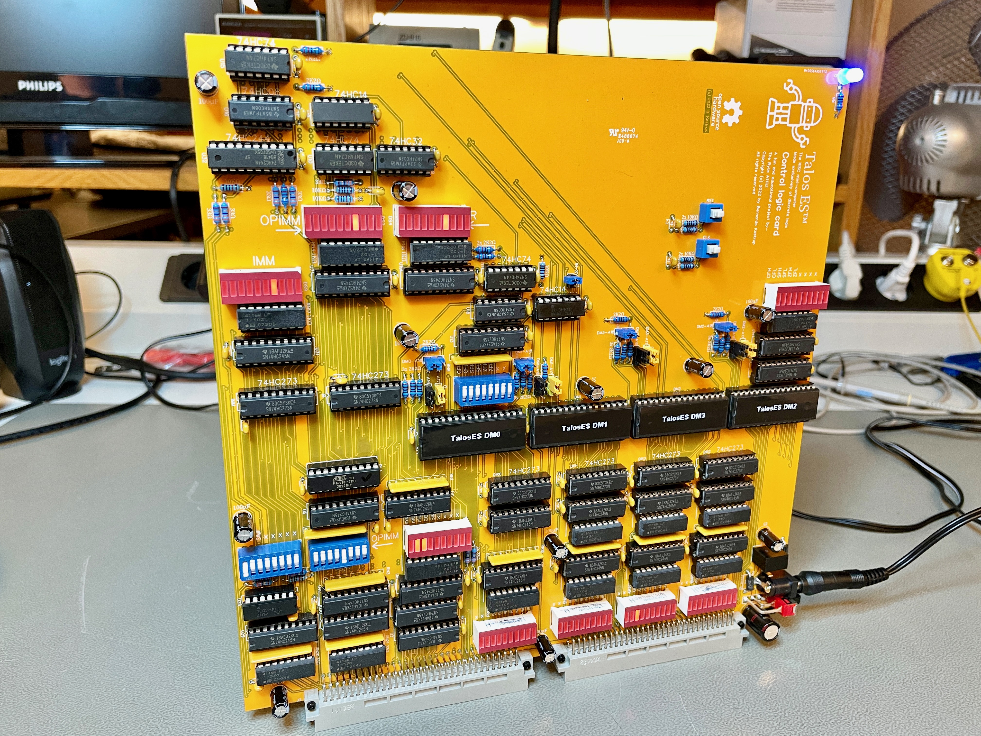
CTRL card/Photos/IMG_5762.jpeg
