TheByteAttic/TalosES/CTRL card/Photos/IMG_5769.jpeg

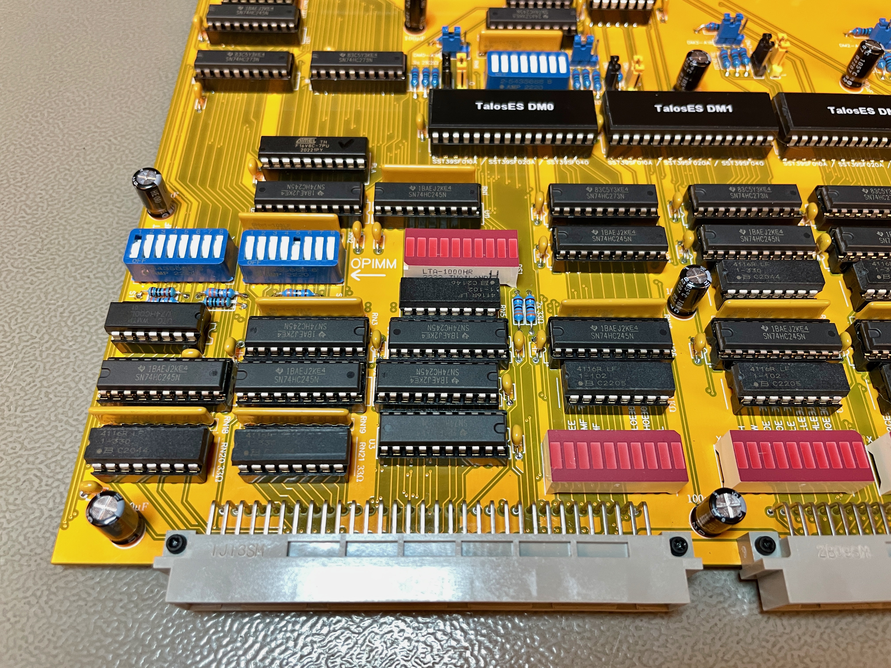
CTRL card/Photos/IMG_5769.jpeg
