TheByteAttic/TalosES/CTRL card/Photos/IMG_5770.jpeg

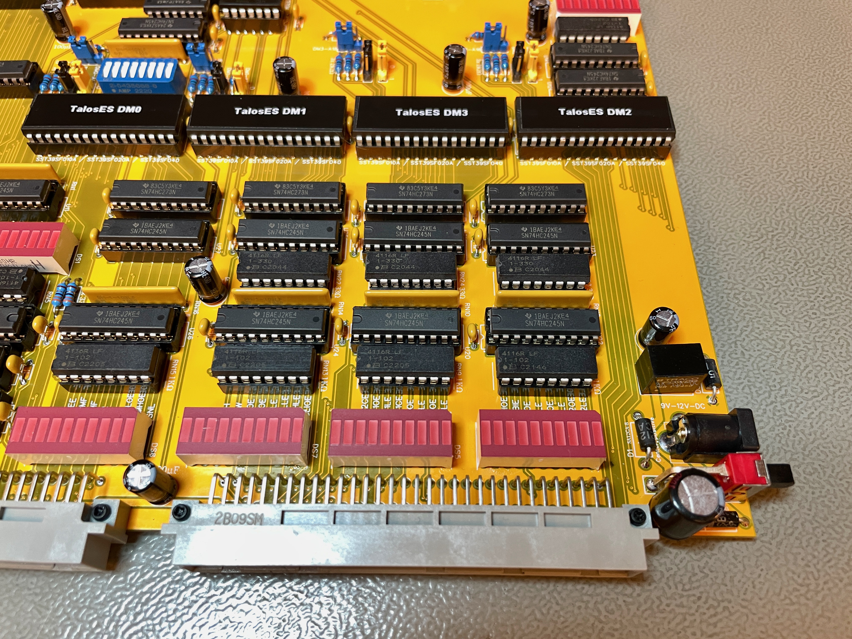
CTRL card/Photos/IMG_5770.jpeg
