TheByteAttic/TalosES/CTRL card/Photos/IMG_5771.jpeg

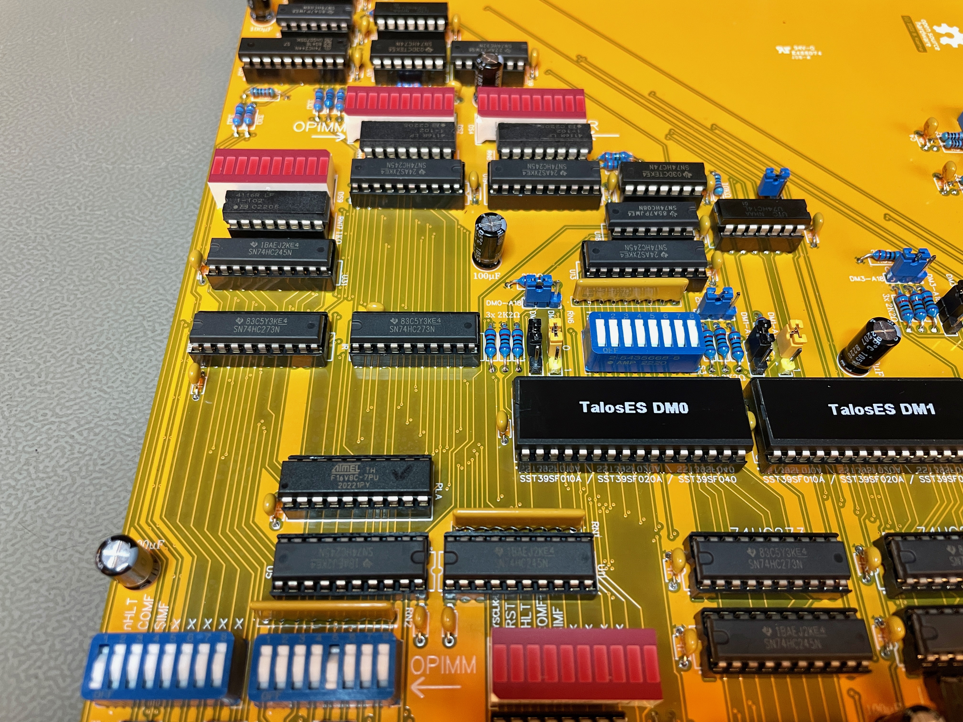
CTRL card/Photos/IMG_5771.jpeg
