TheByteAttic/TalosES/CTRL card/Photos/IMG_5772.jpeg

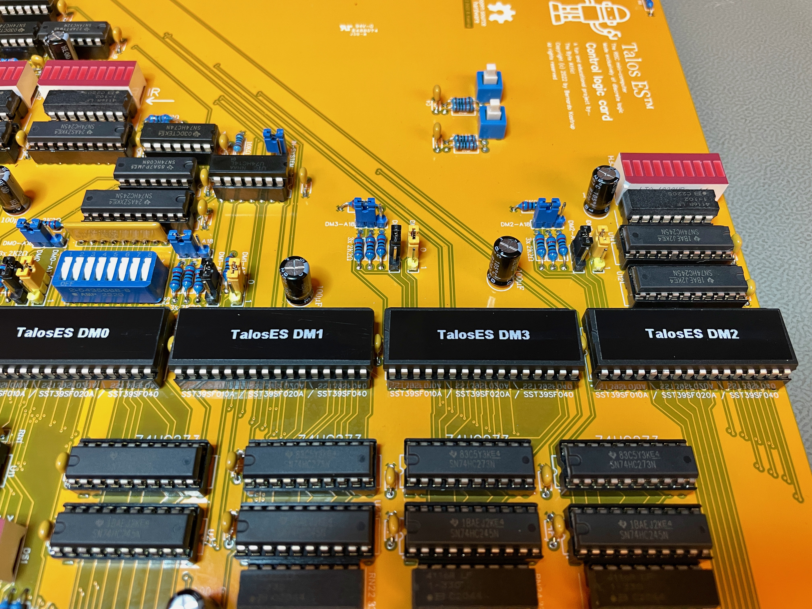
CTRL card/Photos/IMG_5772.jpeg
