TheByteAttic/TalosES/CTRL card/Photos/IMG_5773.jpeg

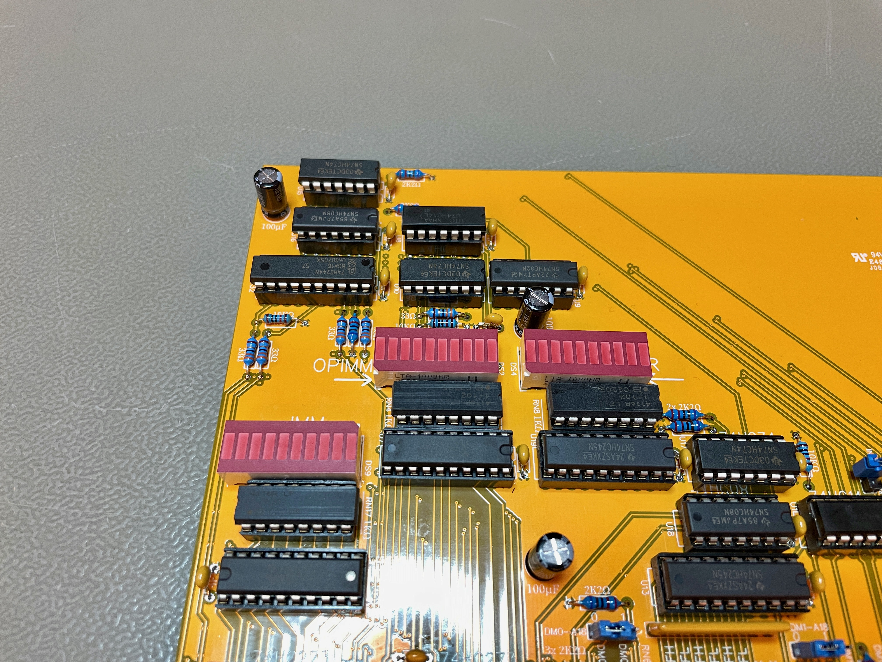
CTRL card/Photos/IMG_5773.jpeg
