TheByteAttic/TalosES/CTRL card/Photos/IMG_5775.jpeg

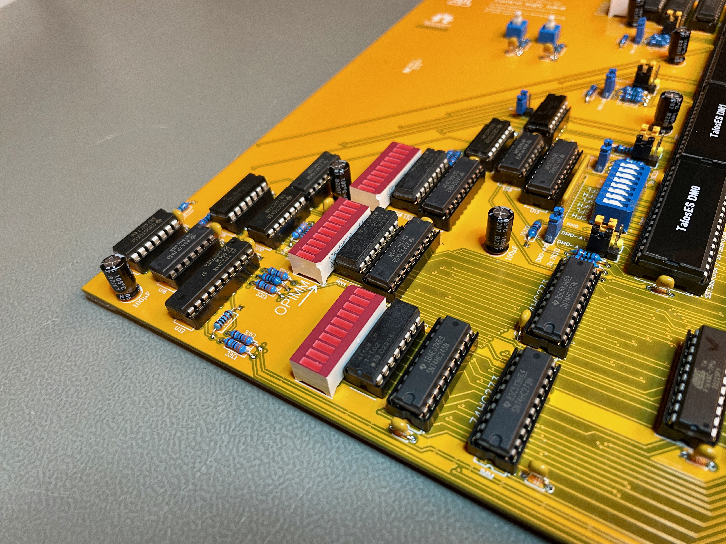
CTRL card/Photos/IMG_5775.jpeg
