TheByteAttic/TalosES/CTRL card/Photos/IMG_5777.jpeg

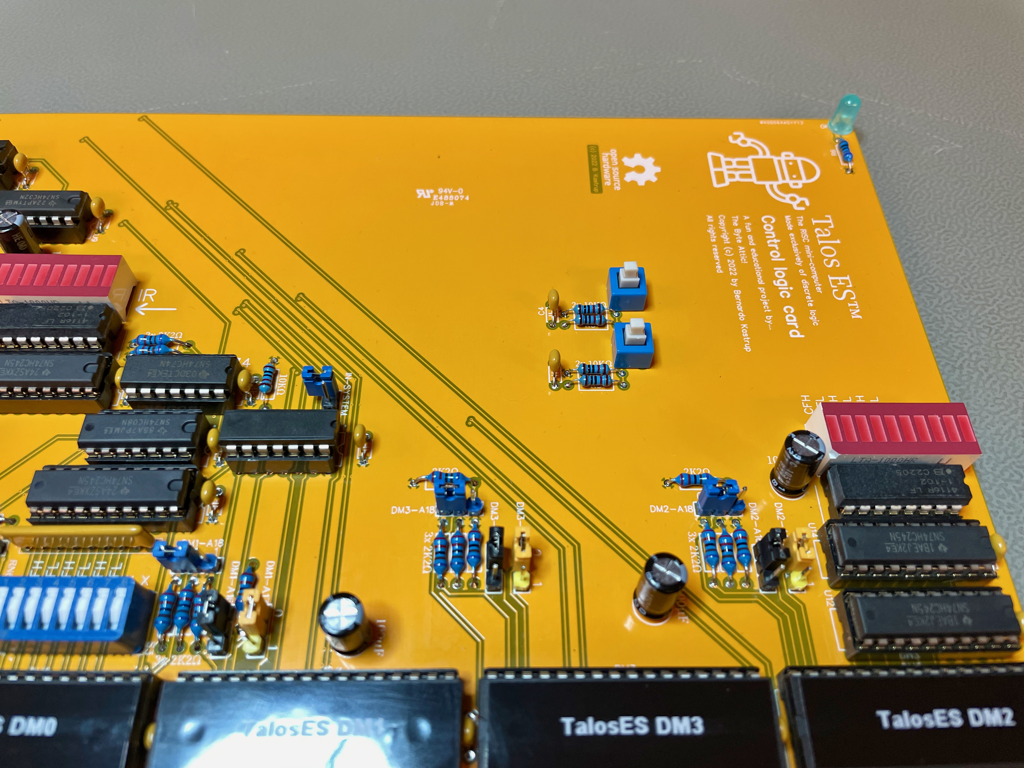
CTRL card/Photos/IMG_5777.jpeg
