TheByteAttic/TalosES/CTRL card/Photos/IMG_5778.jpeg

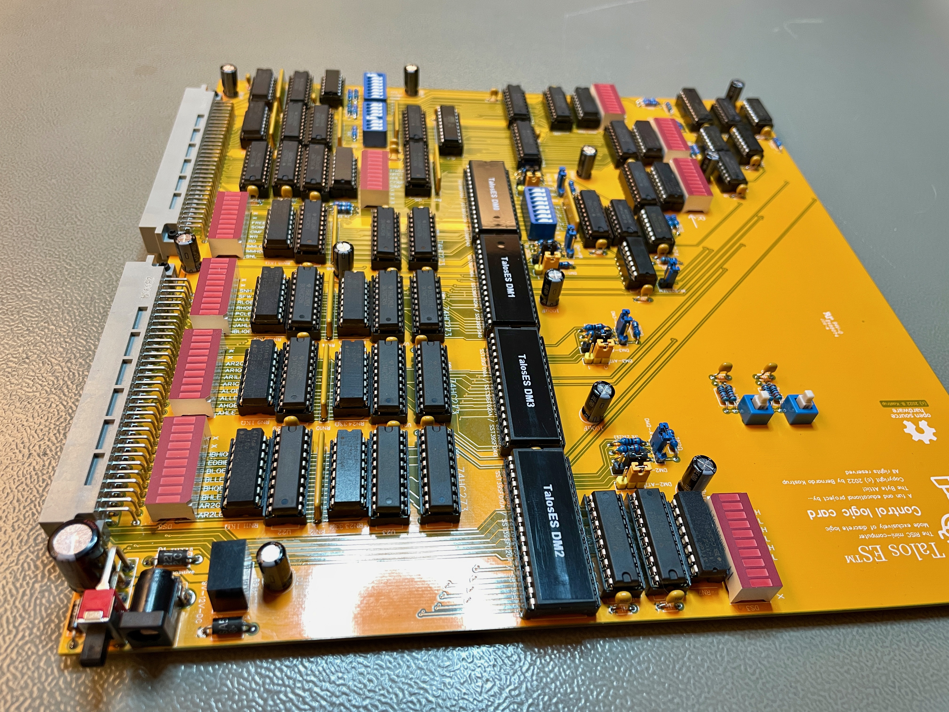
CTRL card/Photos/IMG_5778.jpeg
