TheByteAttic/TalosES/CTRL card/Photos/IMG_5779.jpeg

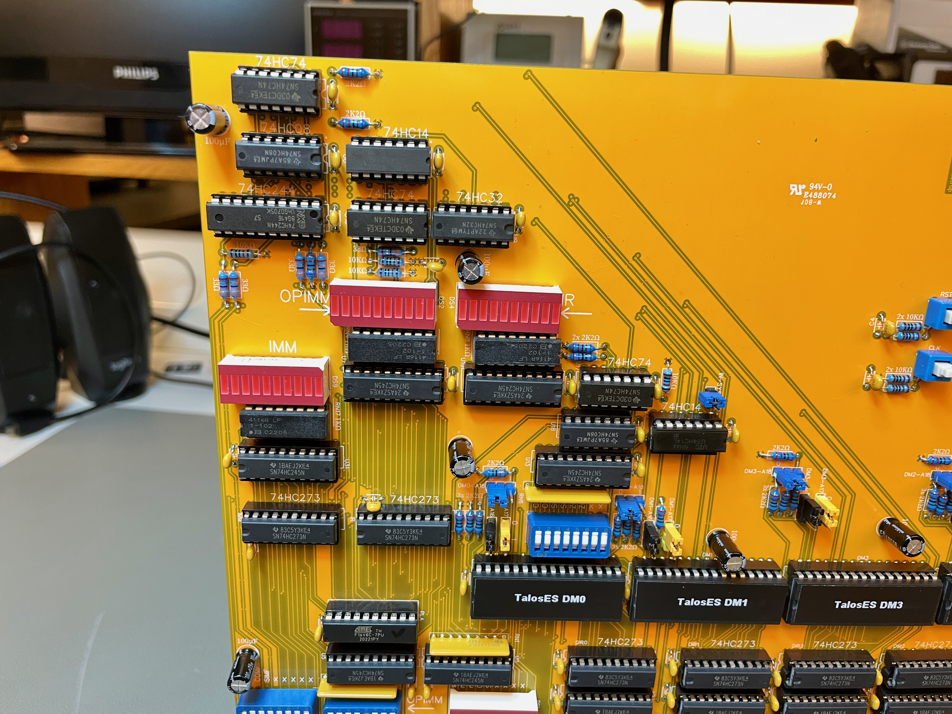
CTRL card/Photos/IMG_5779.jpeg
