TheByteAttic/TalosES/CTRL card/Photos/IMG_5782.jpeg

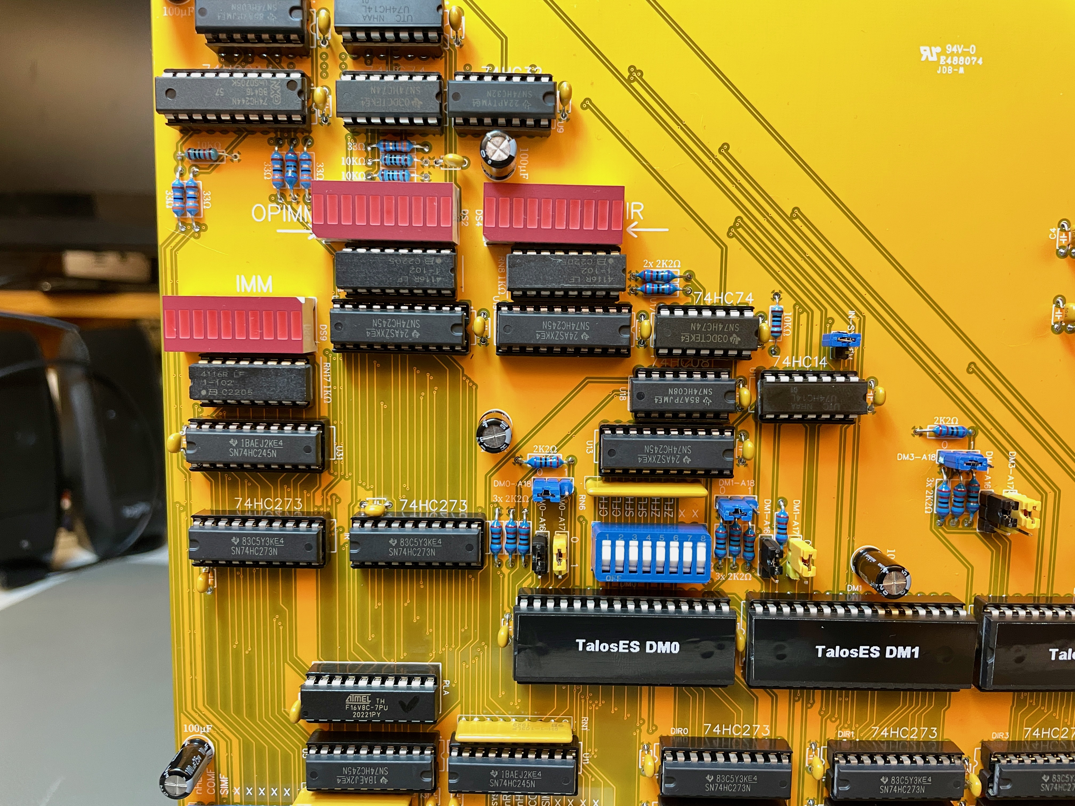
CTRL card/Photos/IMG_5782.jpeg
