TheByteAttic/TalosES/CTRL card/Photos/IMG_5783.jpeg

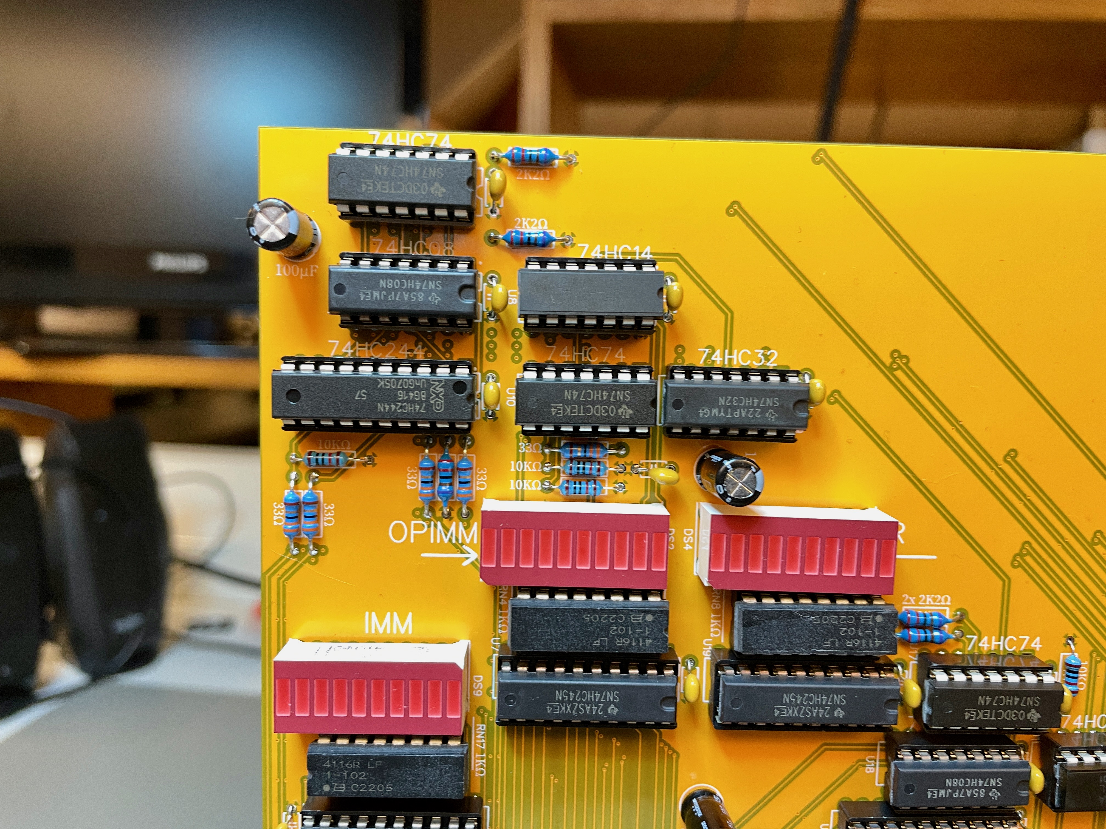
CTRL card/Photos/IMG_5783.jpeg
