TheByteAttic/TalosES/CTRL card/Photos/IMG_5784.jpeg

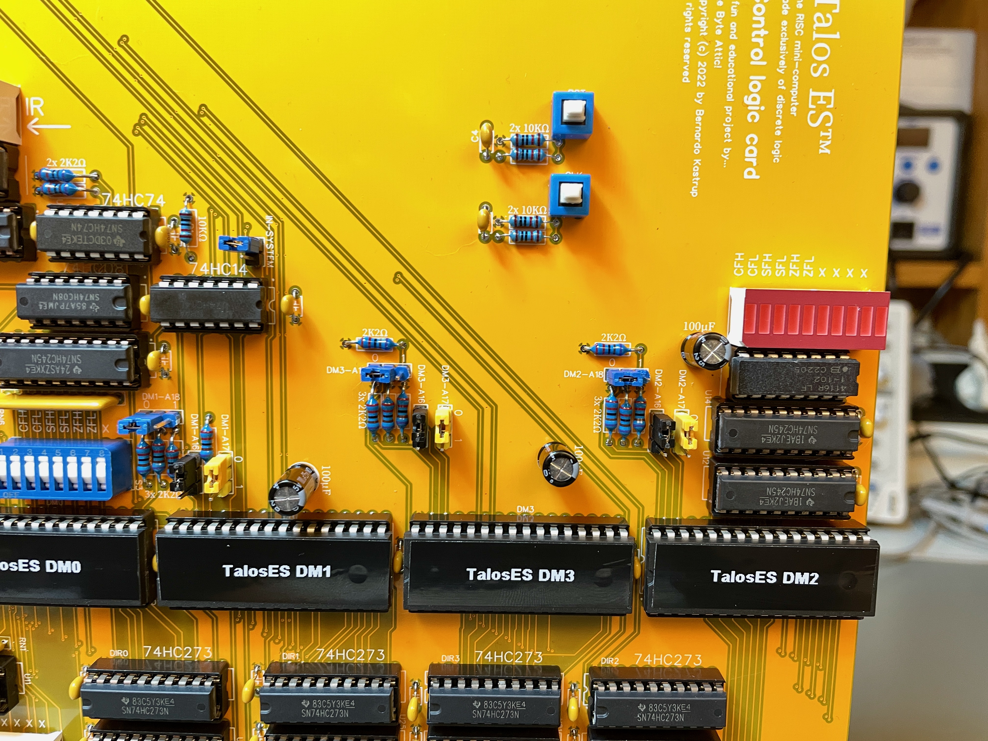
CTRL card/Photos/IMG_5784.jpeg
