TheByteAttic/TalosES/CTRL card/Photos/IMG_5785.jpeg

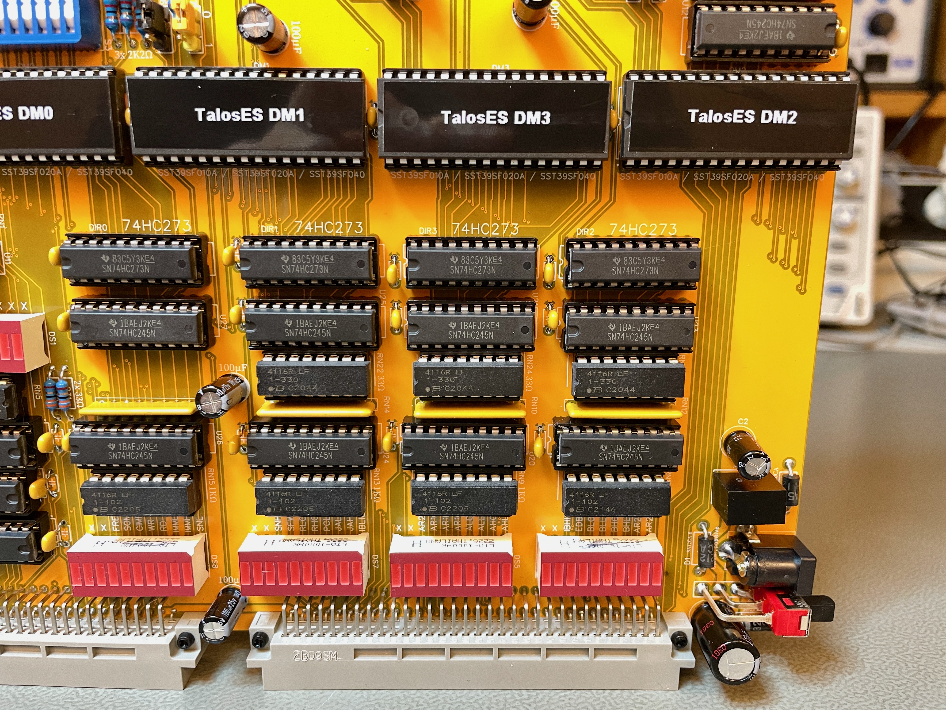
CTRL card/Photos/IMG_5785.jpeg
