TheByteAttic/TalosES/CTRL card/Photos/IMG_5786.jpeg

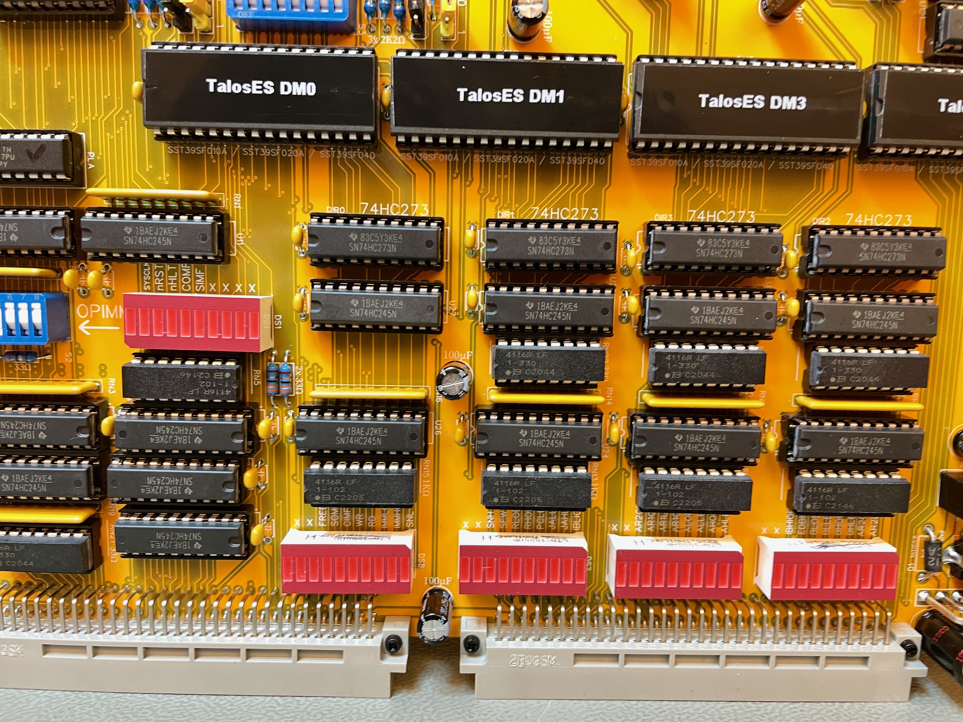
CTRL card/Photos/IMG_5786.jpeg
