TheByteAttic/TalosES/CTRL card/Photos/IMG_5787.jpeg

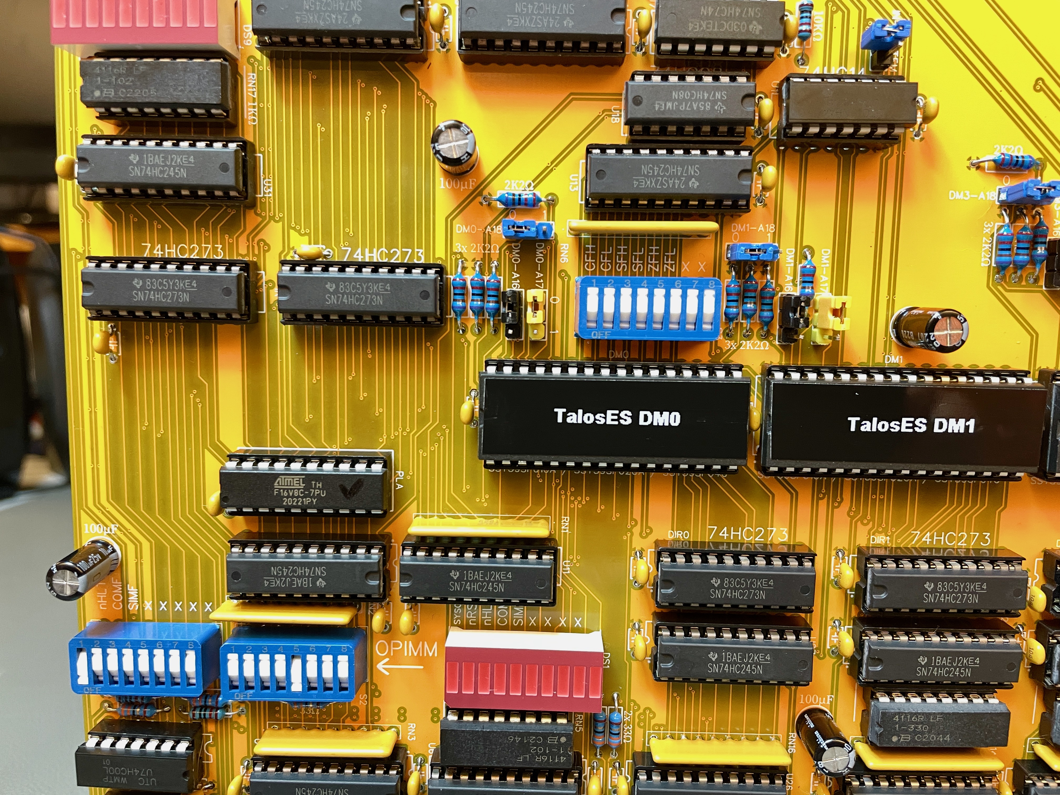
CTRL card/Photos/IMG_5787.jpeg
