TheByteAttic/TalosES/Firmware/Bootloader circuit photos/IMG_1668.jpeg

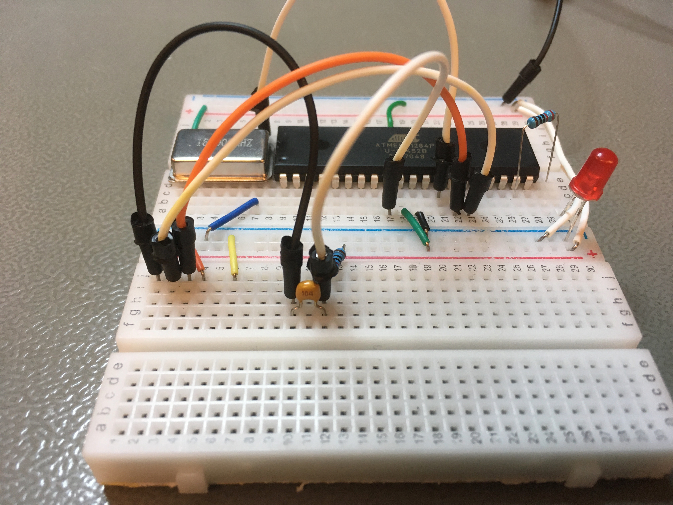
Firmware/Bootloader circuit photos/IMG_1668.jpeg
