TheByteAttic/TalosES/Firmware/Bootloader circuit photos/IMG_1669.jpeg

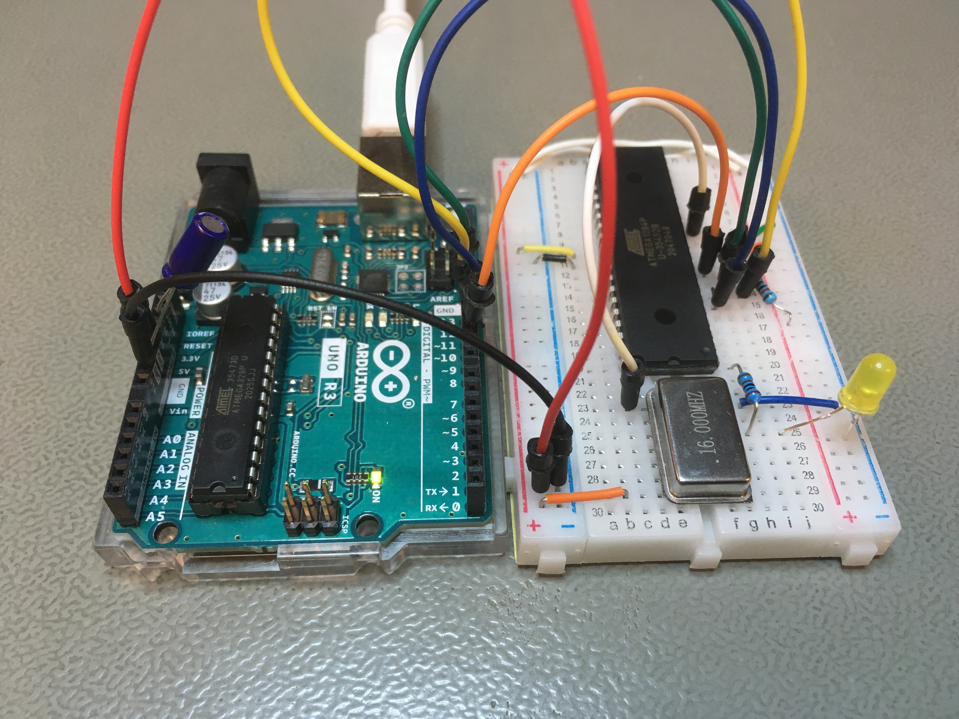
Firmware/Bootloader circuit photos/IMG_1669.jpeg
