TheByteAttic/TalosES/Firmware/Bootloader circuit photos/IMG_1670.jpeg

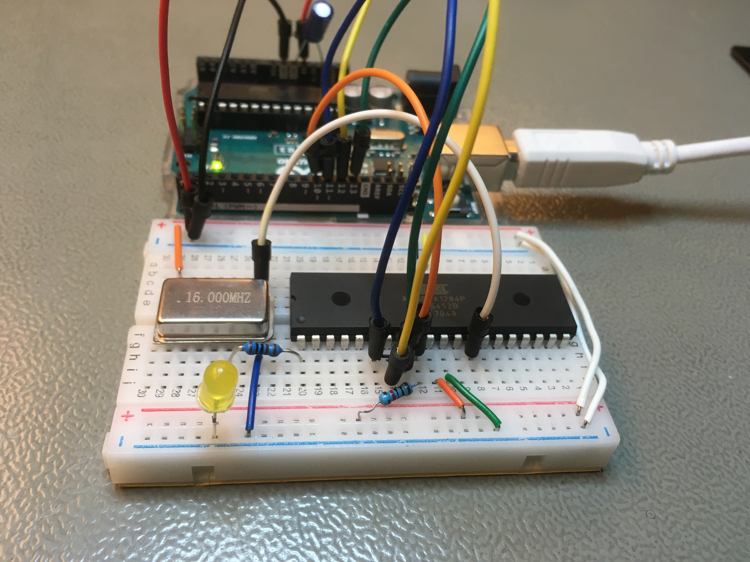
Firmware/Bootloader circuit photos/IMG_1670.jpeg
