TheByteAttic/TalosES/Firmware/Bootloader circuit photos/IMG_1671.jpeg

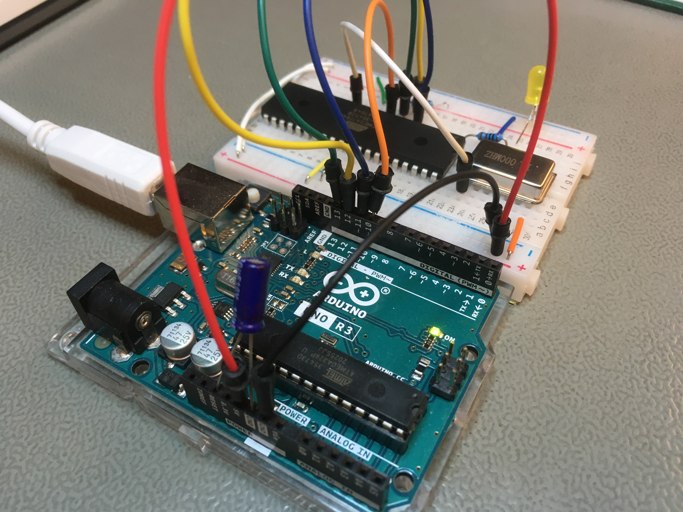
Firmware/Bootloader circuit photos/IMG_1671.jpeg
