TheByteAttic/TalosES/Firmware/Bootloader circuit photos/IMG_1672.jpeg

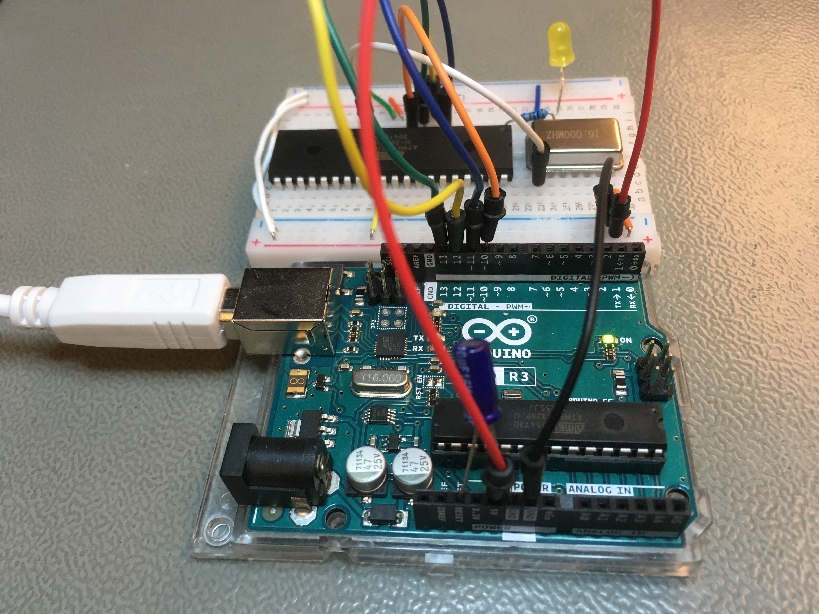
Firmware/Bootloader circuit photos/IMG_1672.jpeg
