TheByteAttic/TalosES/Firmware/Bootloader circuit photos/IMG_1674.jpeg

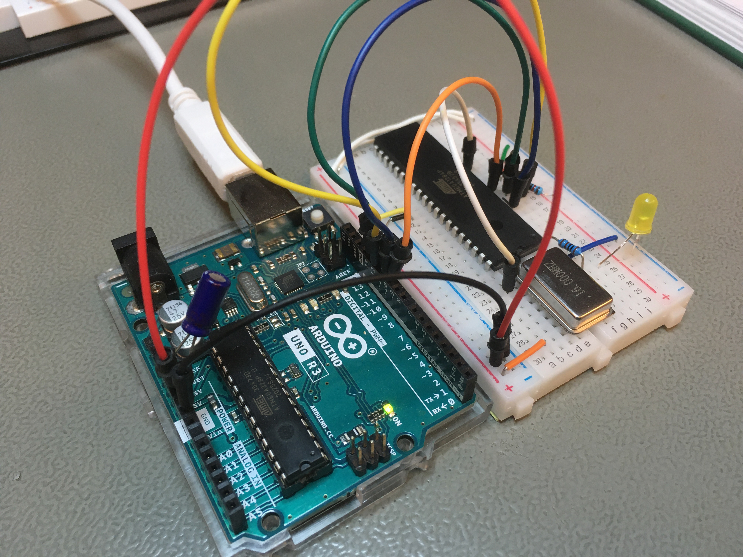
Firmware/Bootloader circuit photos/IMG_1674.jpeg
