TheByteAttic/TalosES/Firmware/Bootloader circuit photos/IMG_1675.jpeg

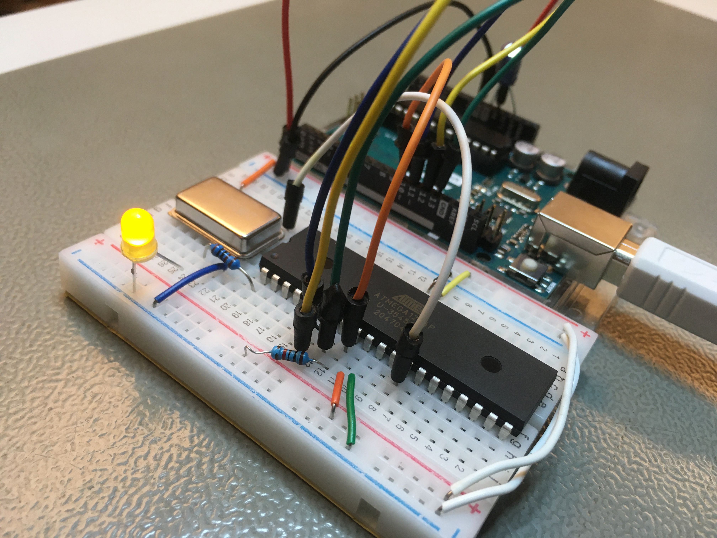
Firmware/Bootloader circuit photos/IMG_1675.jpeg
