TheByteAttic/TalosES/Firmware/Bootloader circuit photos/IMG_5845.jpeg

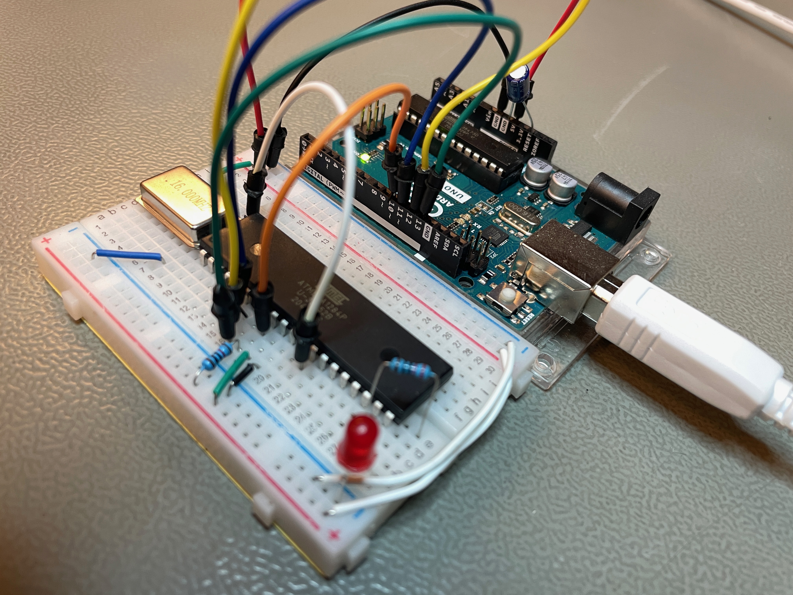
Firmware/Bootloader circuit photos/IMG_5845.jpeg
