TheByteAttic/TalosES/Firmware/Bootloader circuit photos/IMG_5846.jpeg

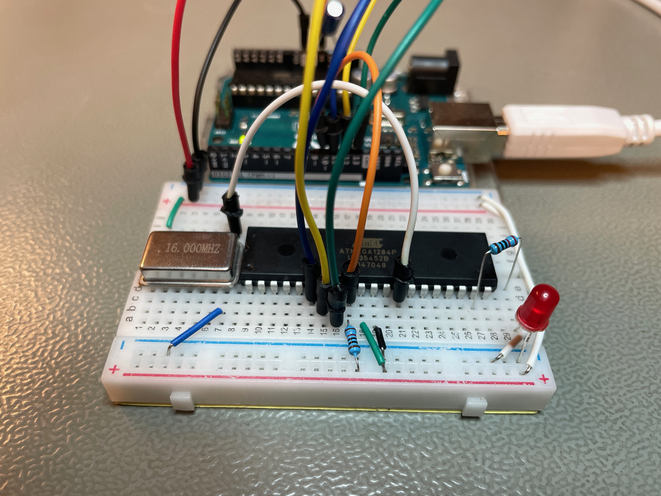
Firmware/Bootloader circuit photos/IMG_5846.jpeg
