TheByteAttic/TalosES/Firmware/Bootloader circuit photos/IMG_5847.jpeg

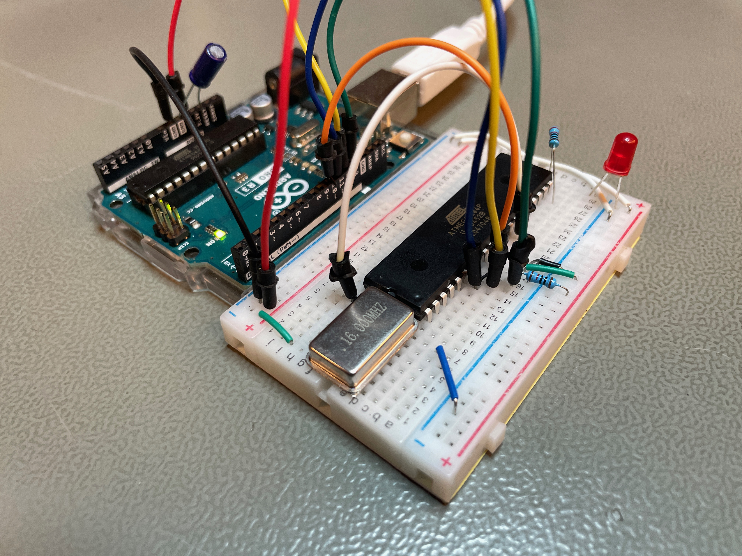
Firmware/Bootloader circuit photos/IMG_5847.jpeg
