TheByteAttic/TalosES/Firmware/Bootloader circuit photos/IMG_5848.jpeg

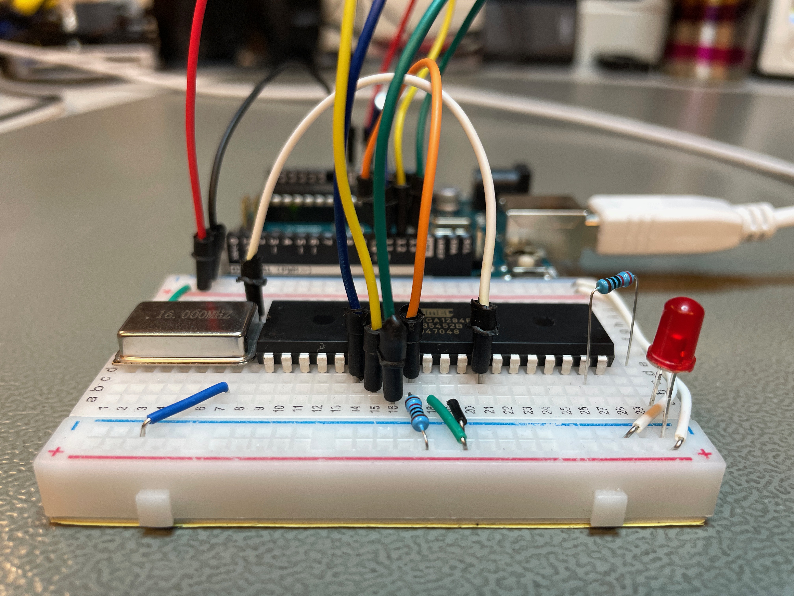
Firmware/Bootloader circuit photos/IMG_5848.jpeg
