TheByteAttic/TalosES/Firmware/Bootloader circuit photos/IMG_5849.jpeg

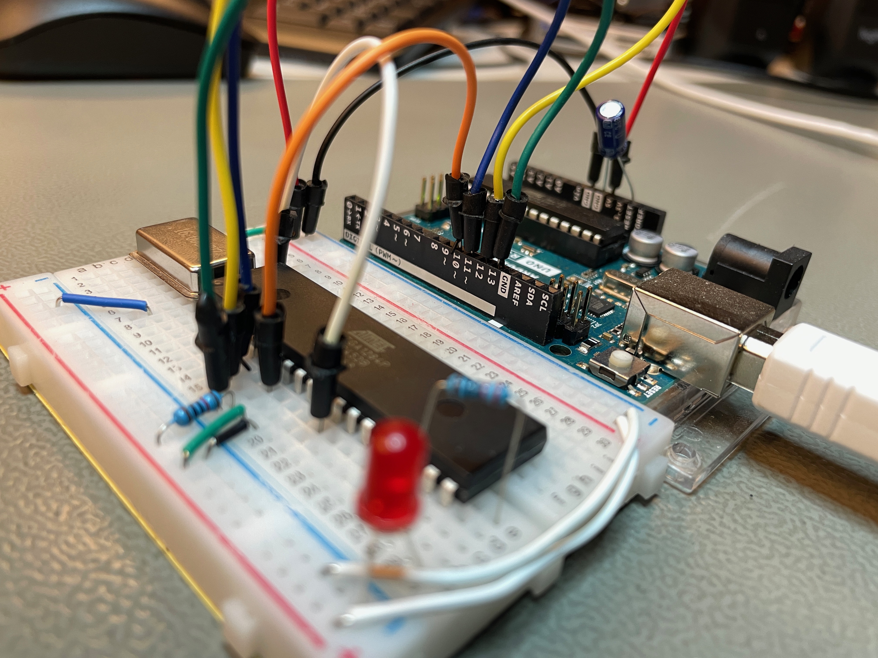
Firmware/Bootloader circuit photos/IMG_5849.jpeg
