TheByteAttic/TalosES/Firmware/Bootloader circuit photos/IMG_5850.jpeg

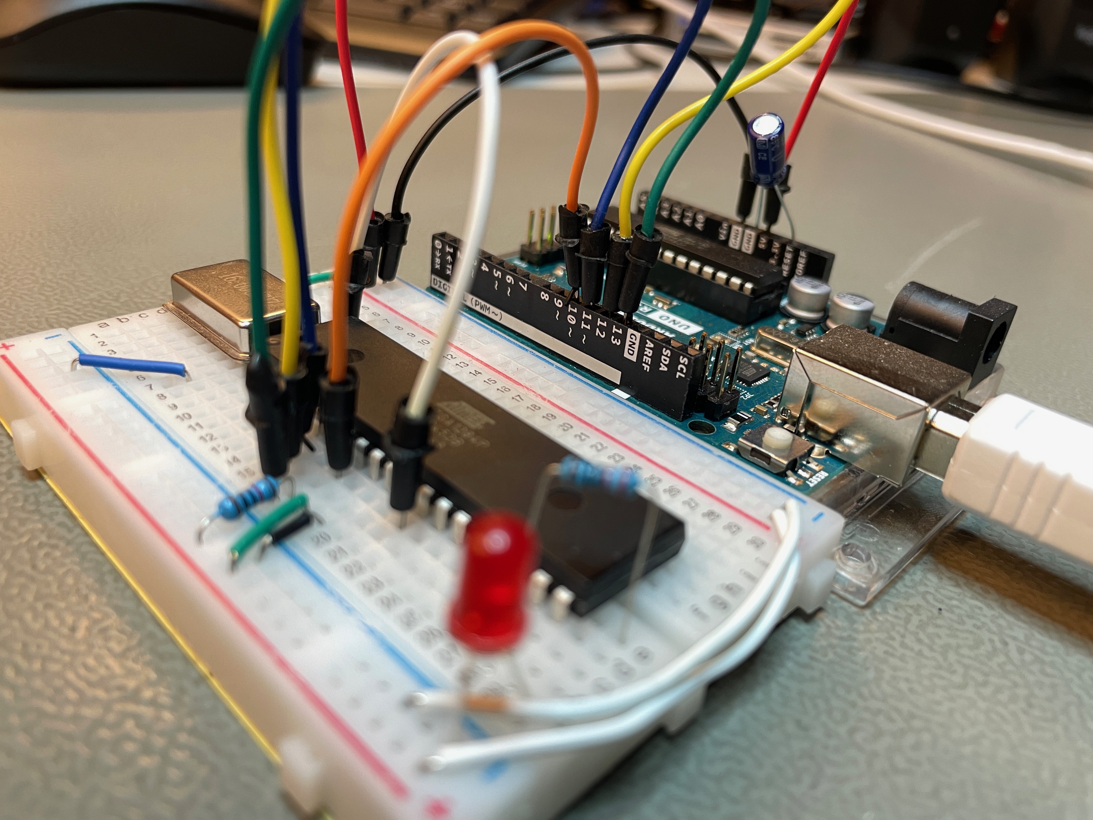
Firmware/Bootloader circuit photos/IMG_5850.jpeg
