TheByteAttic/TalosES/Firmware/Bootloader circuit photos/IMG_5851.jpeg

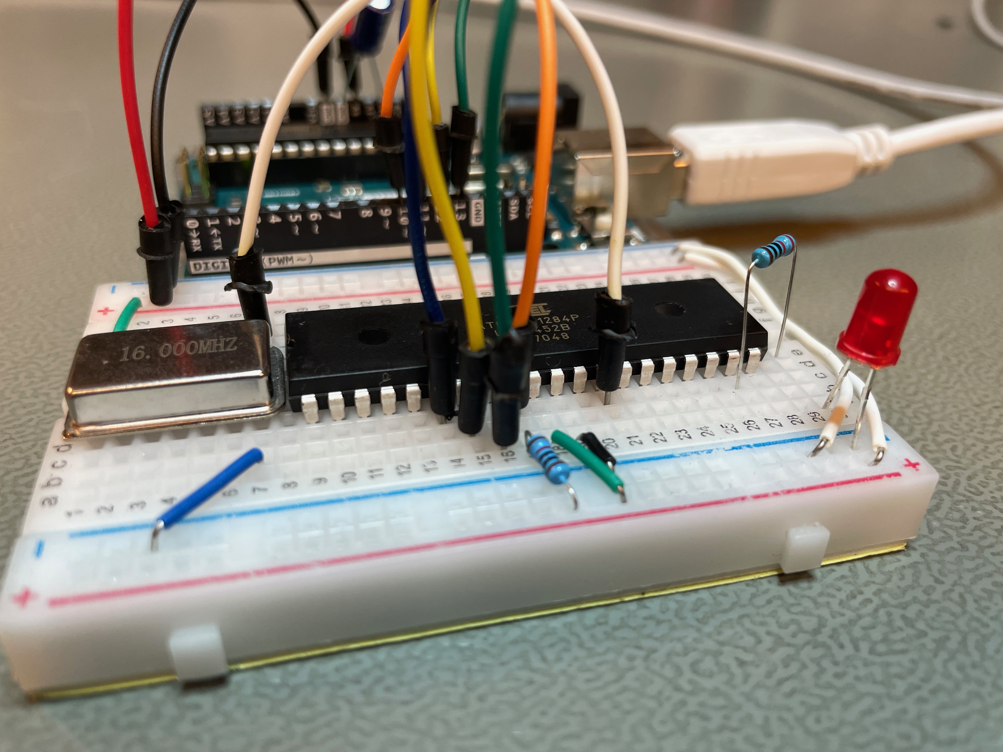
Firmware/Bootloader circuit photos/IMG_5851.jpeg
