TheByteAttic/TalosES/Photos/IMG_3659.jpeg

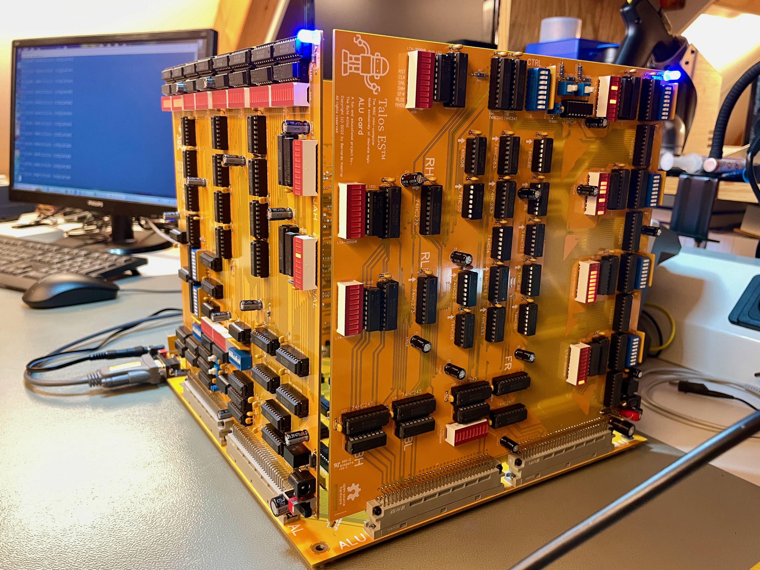
Photos/IMG_3659.jpeg
