TheByteAttic/TalosES/Photos/IMG_3661.jpeg

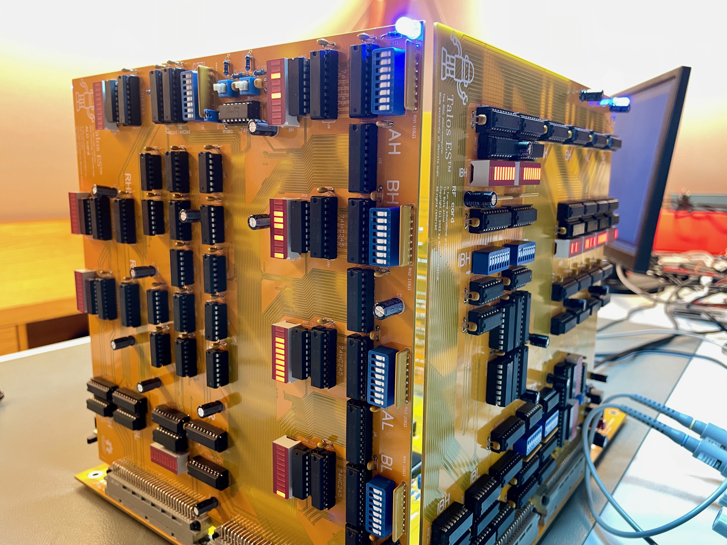
Photos/IMG_3661.jpeg
