TheByteAttic/TalosES/Photos/IMG_3665.jpeg

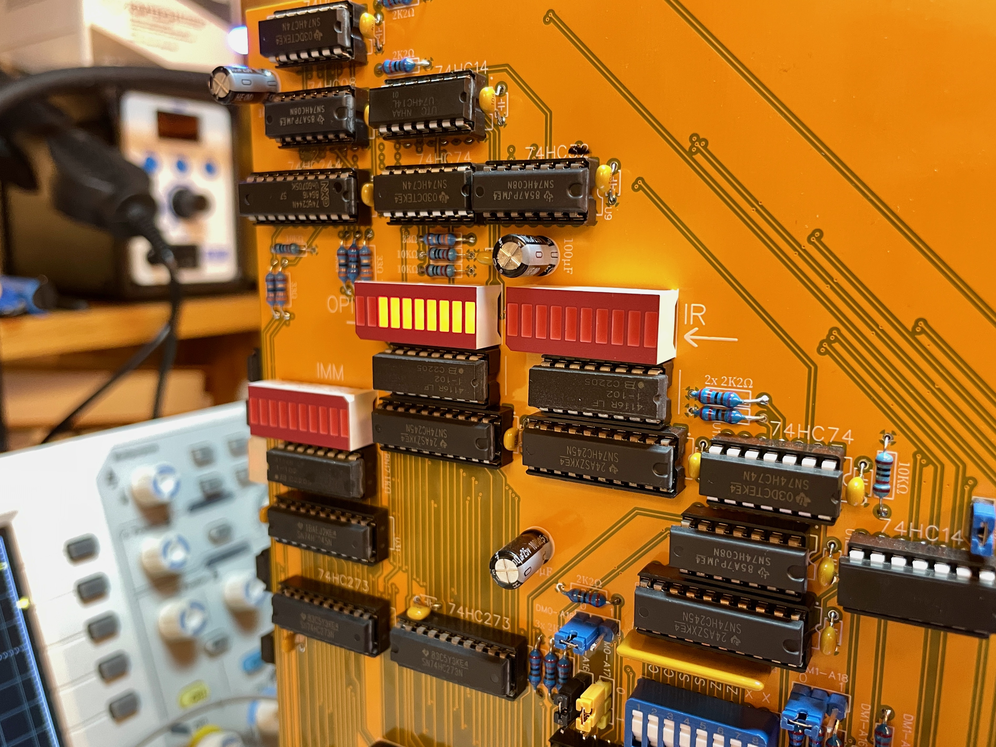
Photos/IMG_3665.jpeg
