TheByteAttic/TalosES/Photos/IMG_3666.jpeg

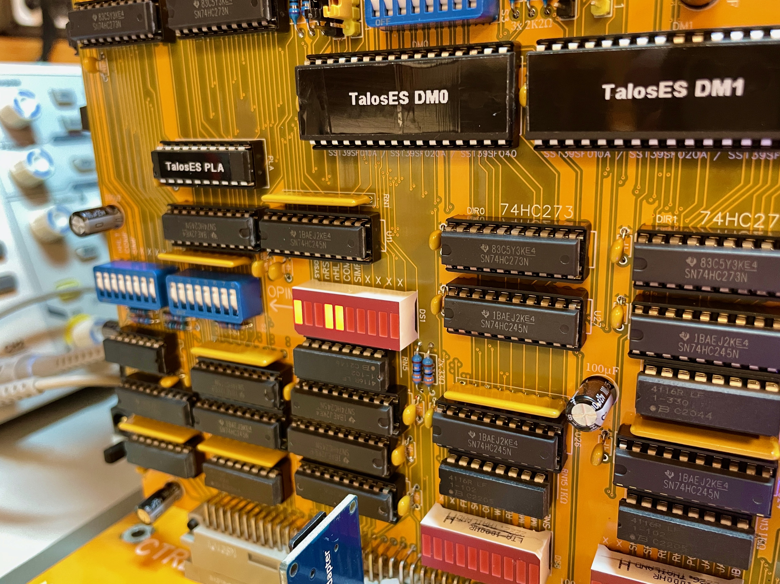
Photos/IMG_3666.jpeg
