TheByteAttic/TalosES/Photos/IMG_3667.jpeg

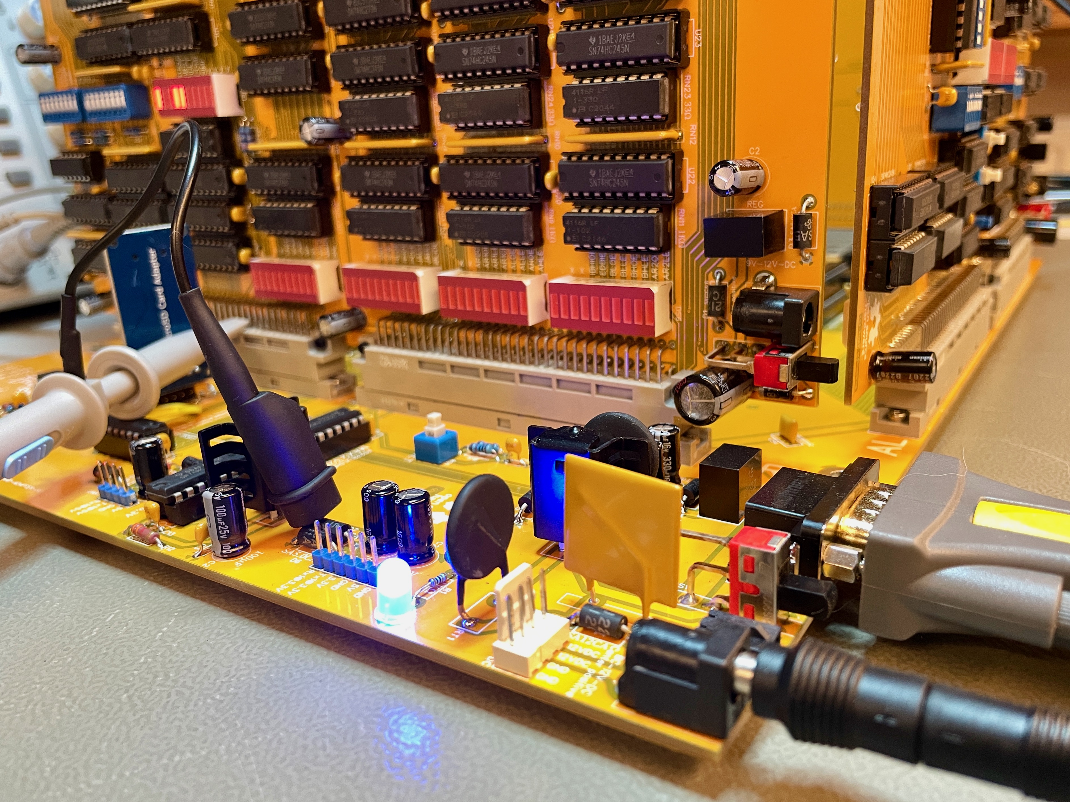
Photos/IMG_3667.jpeg
