TheByteAttic/TalosES/Photos/IMG_3668.jpeg

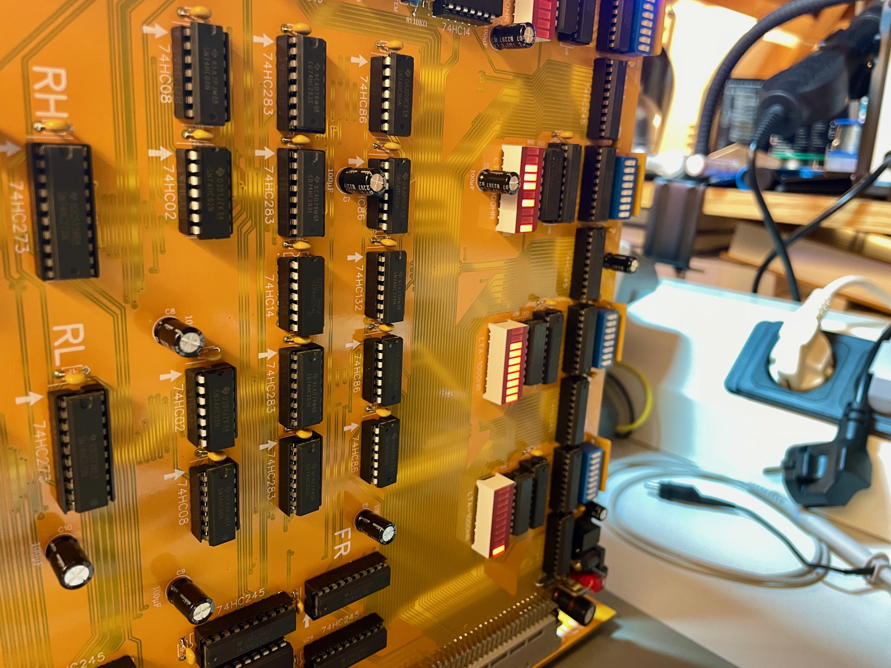
Photos/IMG_3668.jpeg
