TheByteAttic/TalosES/Photos/IMG_3669.jpeg

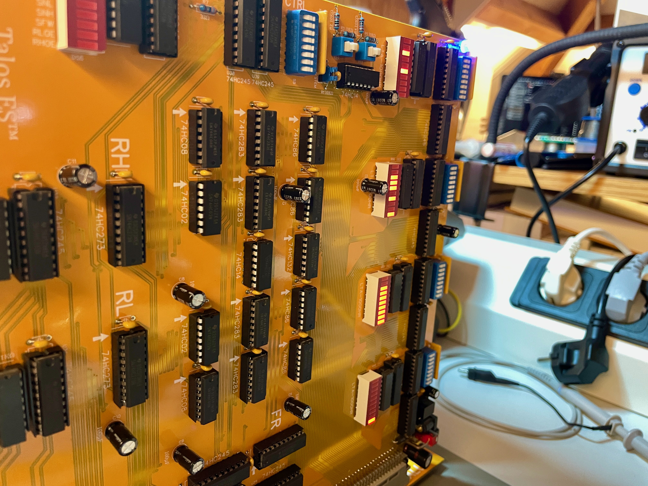
Photos/IMG_3669.jpeg
