TheByteAttic/TalosES/Photos/IMG_3670.jpeg

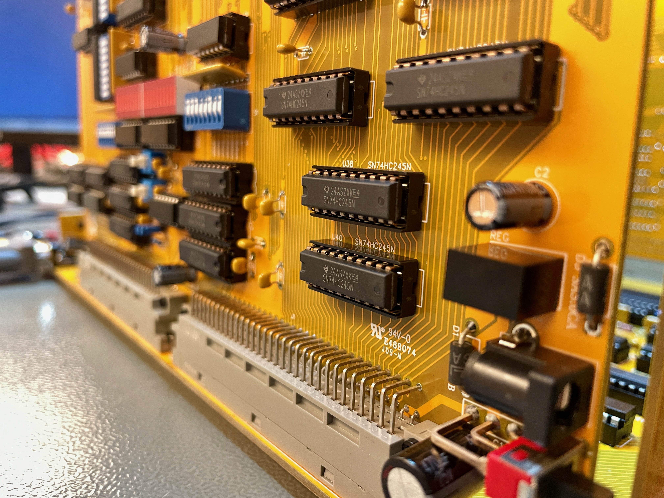
Photos/IMG_3670.jpeg
