TheByteAttic/TalosES/Photos/IMG_3671.jpeg

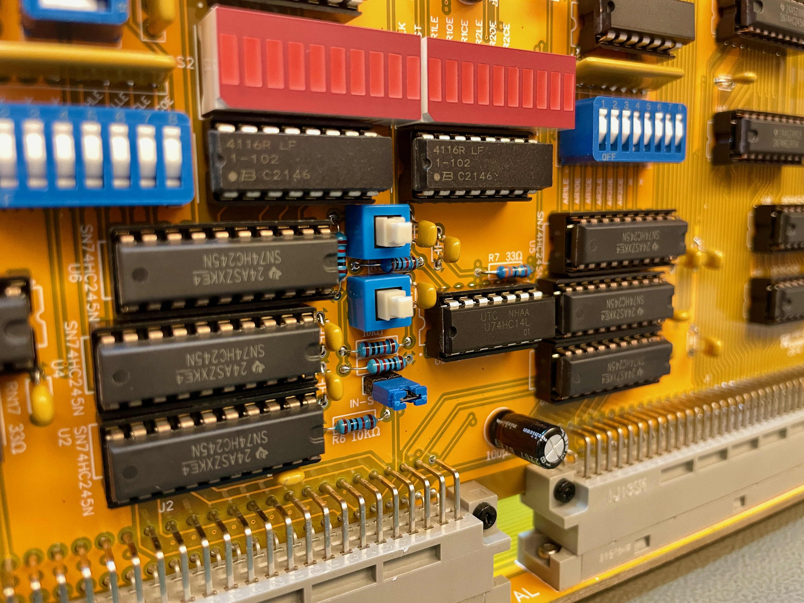
Photos/IMG_3671.jpeg
