TheByteAttic/TalosES/Photos/IMG_3672.jpeg

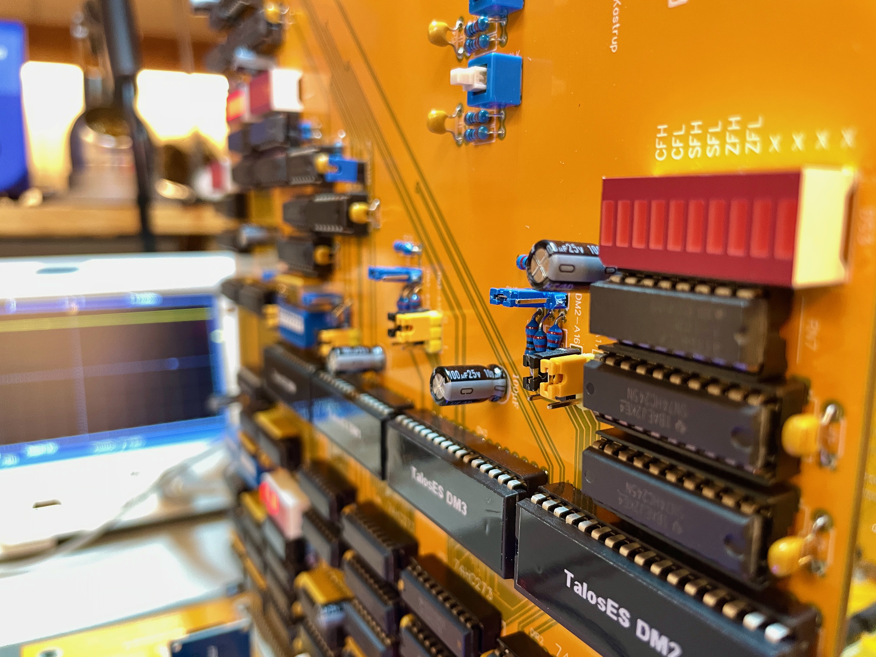
Photos/IMG_3672.jpeg
