TheByteAttic/TalosES/Photos/IMG_3673.jpeg

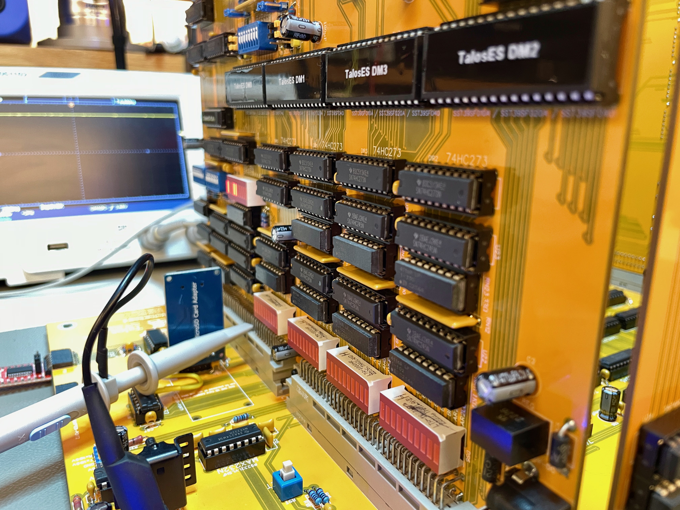
Photos/IMG_3673.jpeg
