TheByteAttic/TalosES/Photos/IMG_3674.jpeg

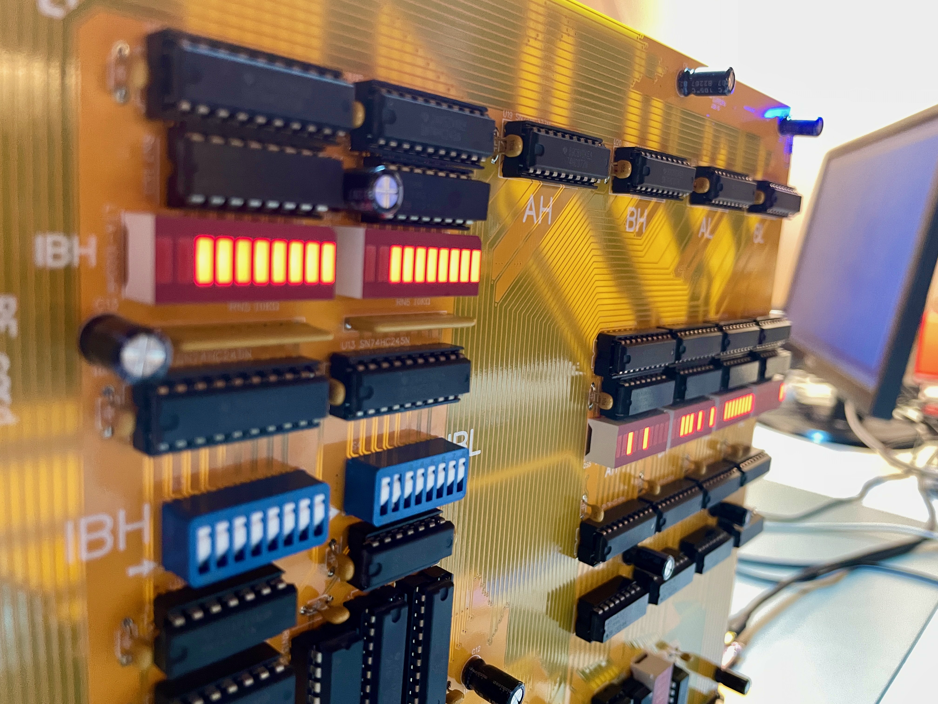
Photos/IMG_3674.jpeg
