TheByteAttic/TalosES/RF card/Photos/IMG_4039.jpeg

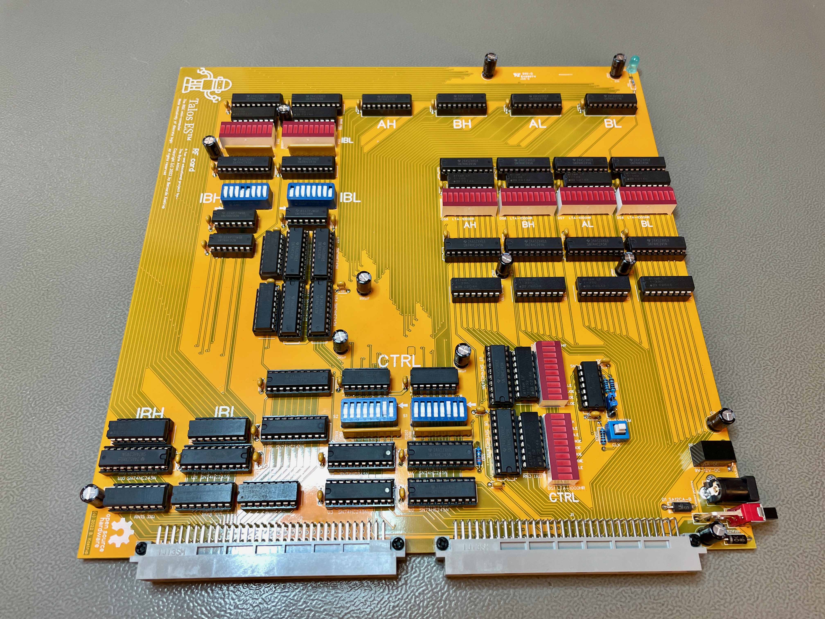
RF card/Photos/IMG_4039.jpeg
