TheByteAttic/TalosES/RF card/Photos/IMG_4040.jpeg

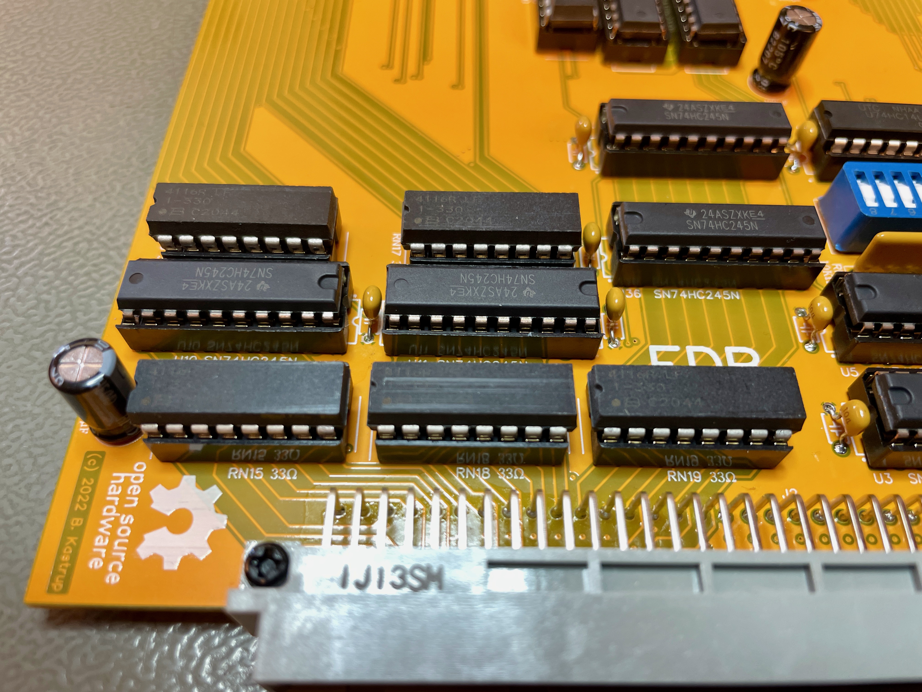
RF card/Photos/IMG_4040.jpeg
