TheByteAttic/TalosES/RF card/Photos/IMG_4041.jpeg

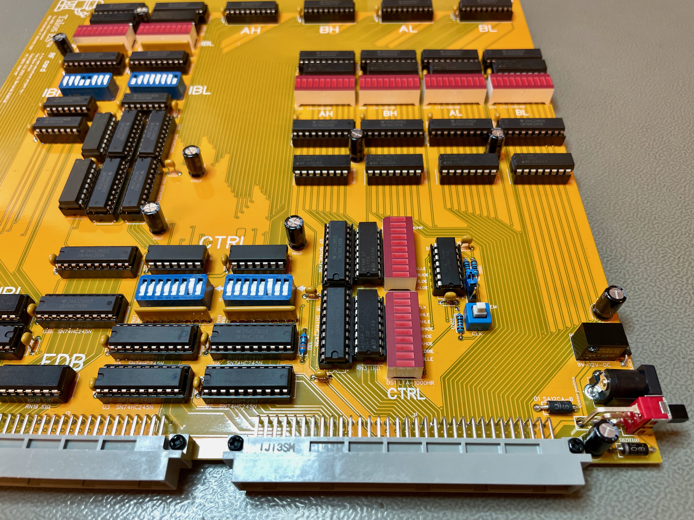
RF card/Photos/IMG_4041.jpeg
