TheByteAttic/TalosES/RF card/Photos/IMG_4042.jpeg

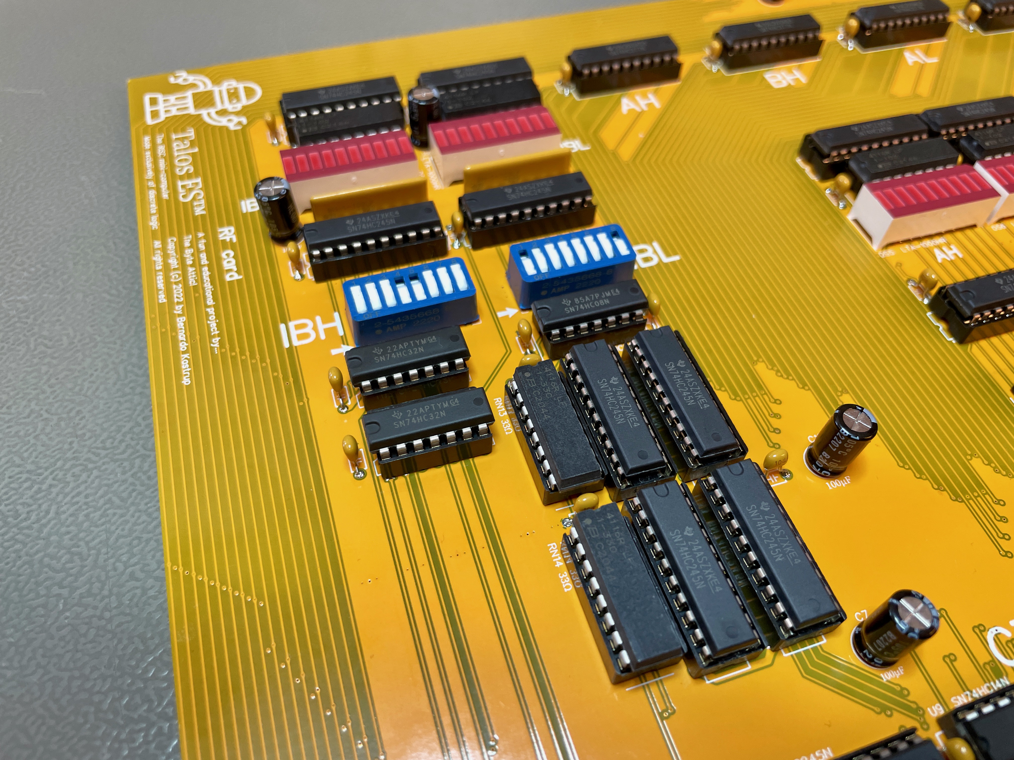
RF card/Photos/IMG_4042.jpeg
