TheByteAttic/TalosES/RF card/Photos/IMG_4043.jpeg

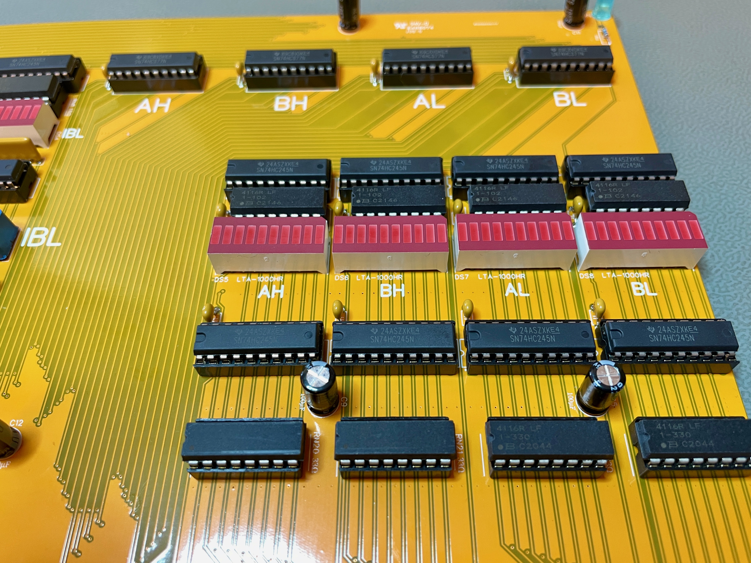
RF card/Photos/IMG_4043.jpeg
