TheByteAttic/TalosES/RF card/Photos/IMG_4044.jpeg

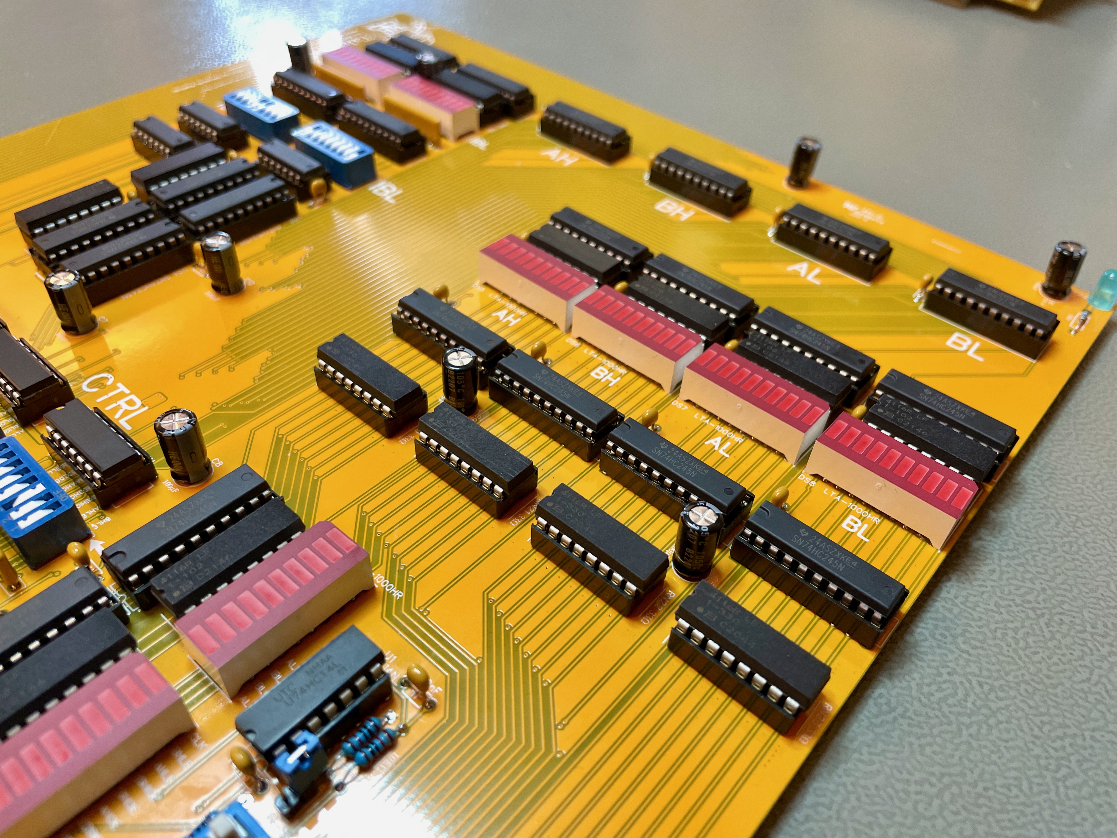
RF card/Photos/IMG_4044.jpeg
