TheByteAttic/TalosES/RF card/Photos/IMG_4045.jpeg

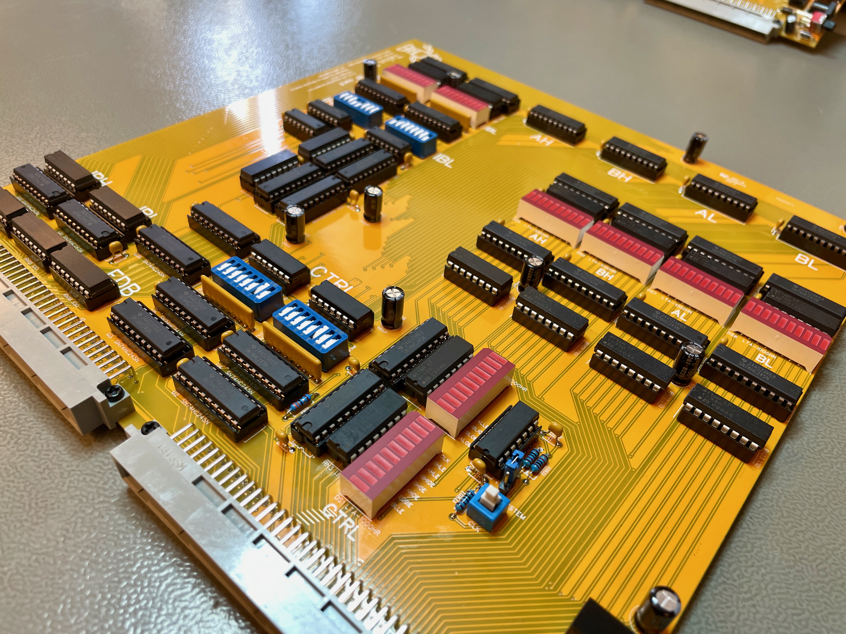
RF card/Photos/IMG_4045.jpeg
