TheByteAttic/TalosES/RF card/Photos/IMG_4046.jpeg

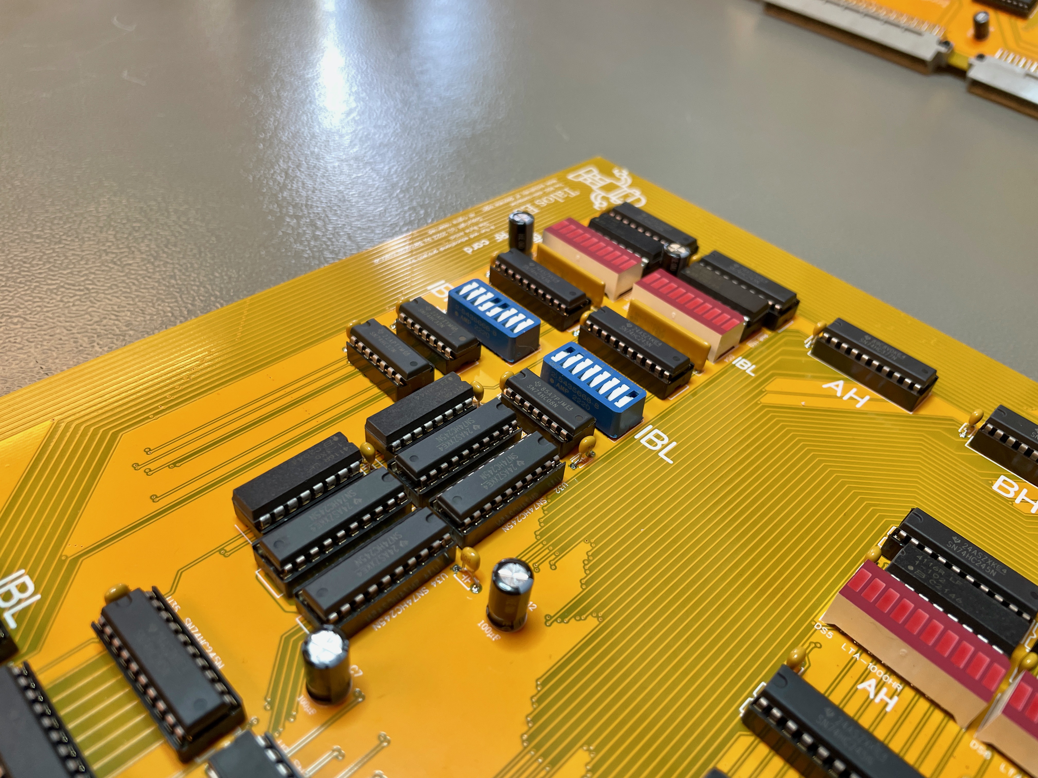
RF card/Photos/IMG_4046.jpeg
