TheByteAttic/TalosES/RF card/Photos/IMG_4047.jpeg

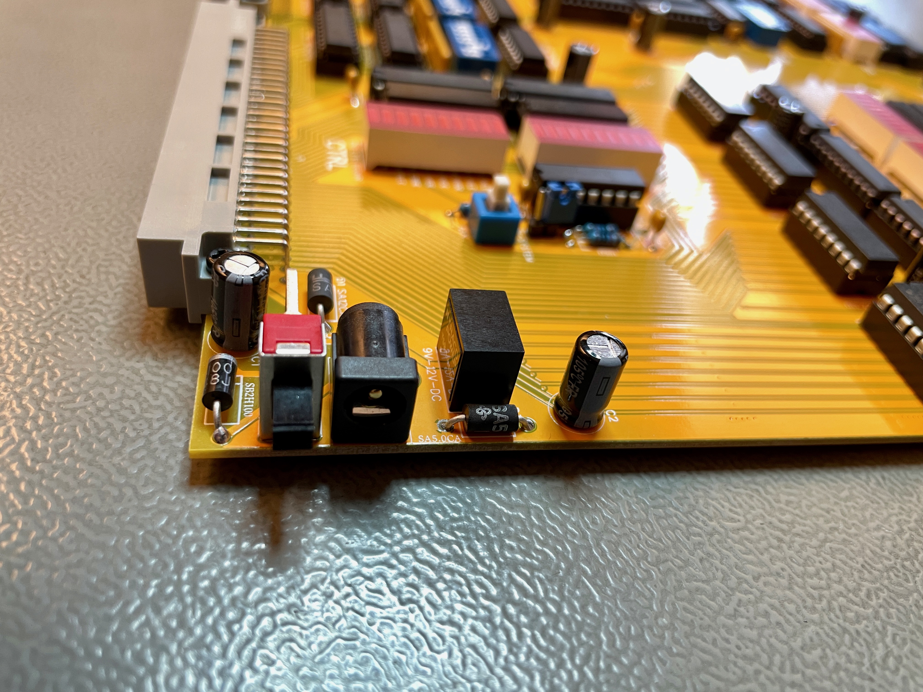
RF card/Photos/IMG_4047.jpeg
