TheByteAttic/TalosES/RF card/Photos/IMG_4048.jpeg

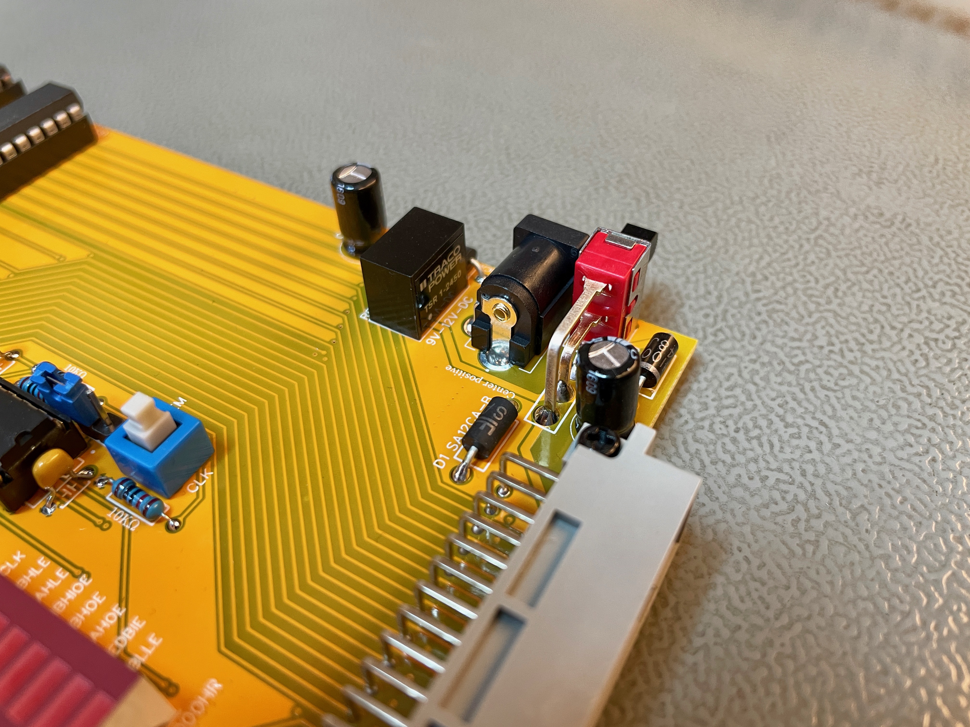
RF card/Photos/IMG_4048.jpeg
