TheByteAttic/TalosES/RF card/Photos/IMG_4049.jpeg

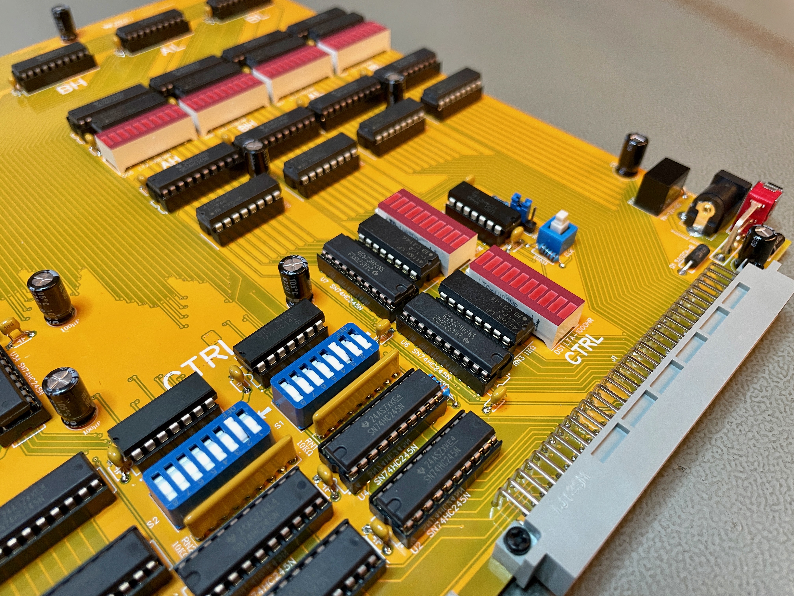
RF card/Photos/IMG_4049.jpeg
