TheByteAttic/TalosES/RF card/Photos/IMG_4050.jpeg

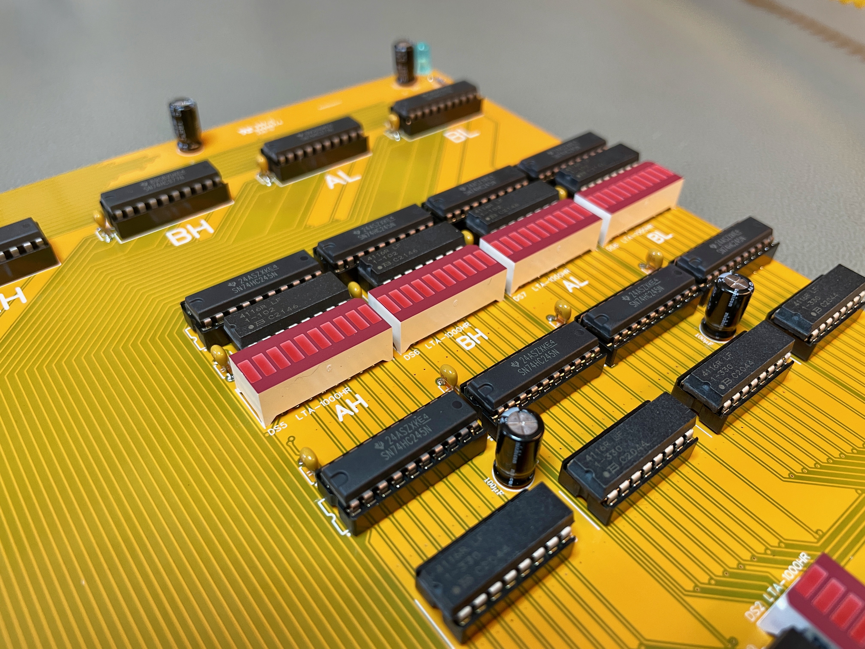
RF card/Photos/IMG_4050.jpeg
