TheByteAttic/TalosES/RF card/Photos/IMG_4051.jpeg

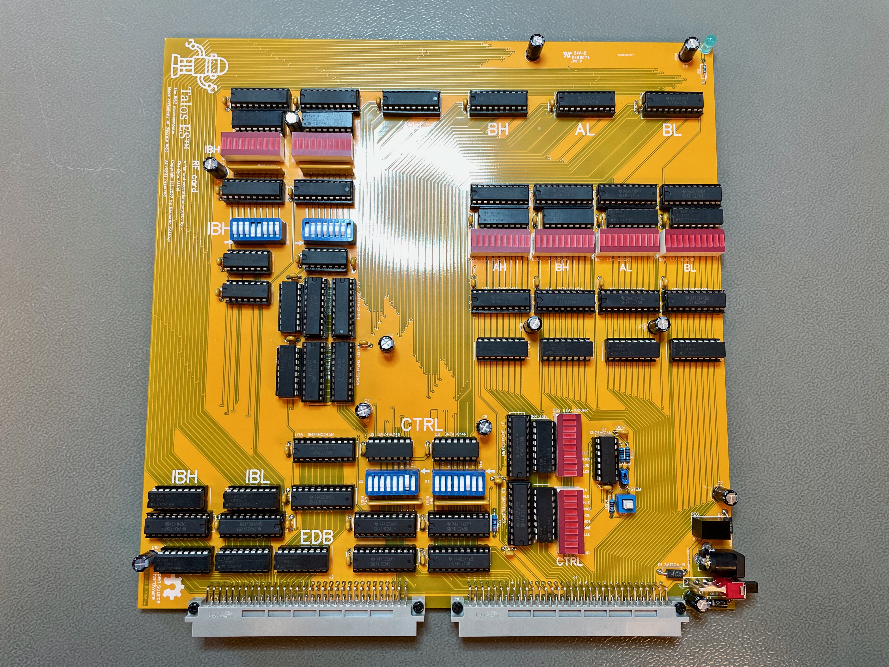
RF card/Photos/IMG_4051.jpeg
