TheByteAttic/TalosES/RF card/Photos/IMG_4052.jpeg

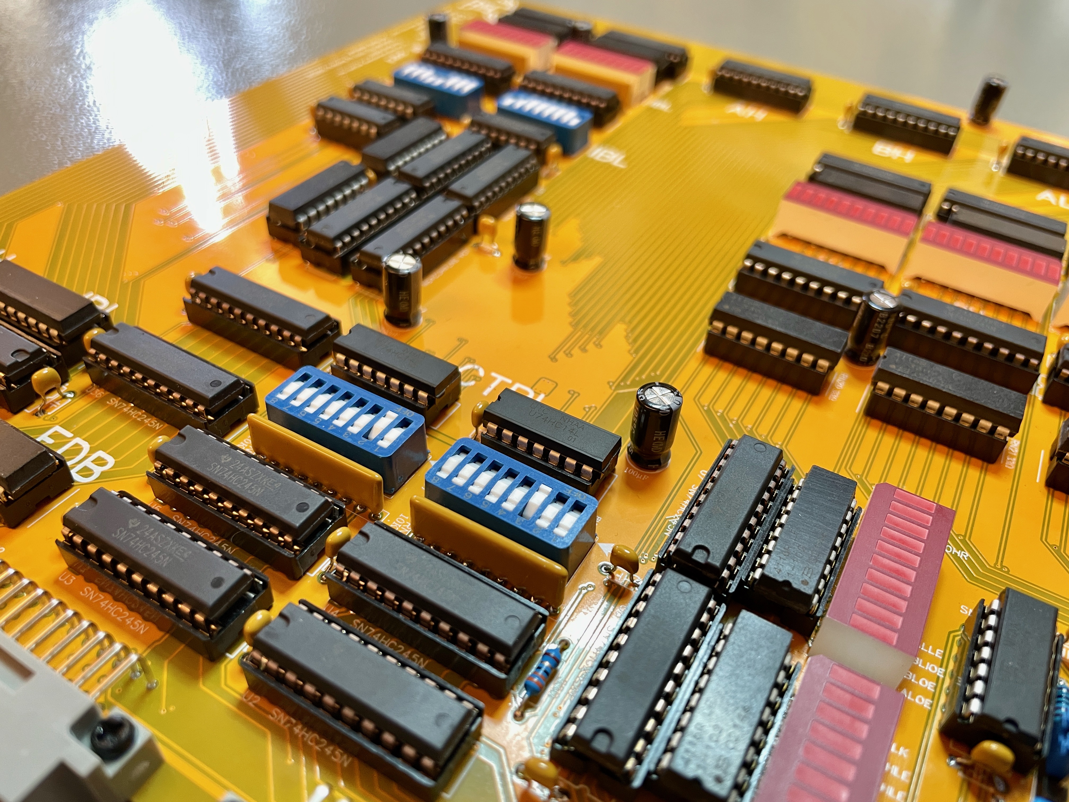
RF card/Photos/IMG_4052.jpeg
