TheByteAttic/TalosES/RF card/Photos/IMG_4053.jpeg

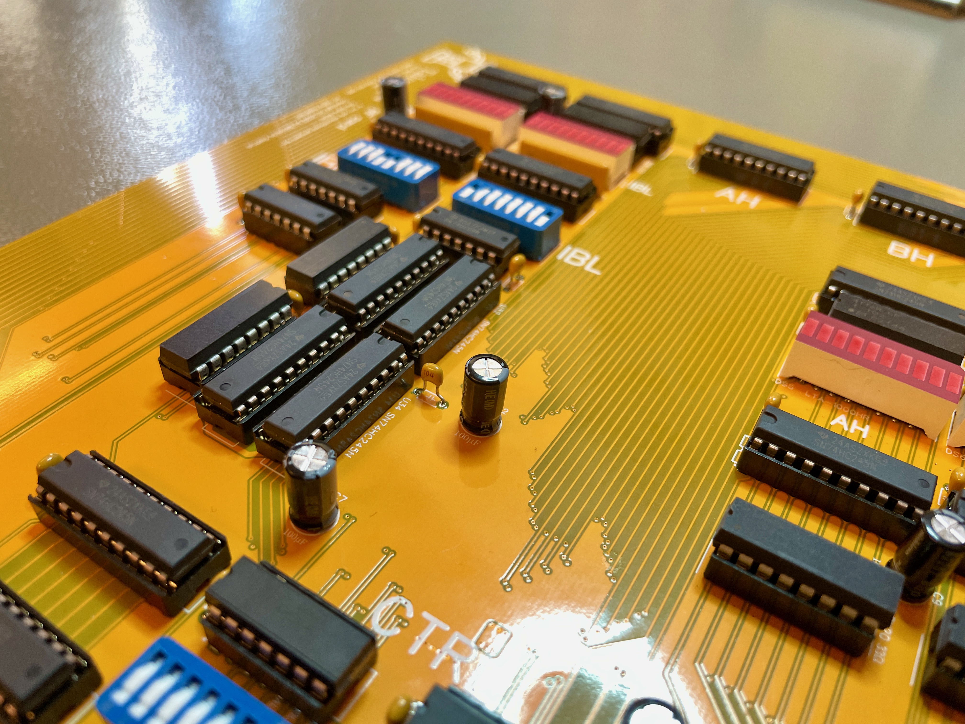
RF card/Photos/IMG_4053.jpeg
