TheByteAttic/TalosES/RF card/BOM Talos ES™ RF.csv

ID | Name | Designator | Footprint | Quantity | Manufacturer Part | Manufacturer | Supplier | Supplier Part | Price
1 | SN74HC32N | U16,U17 | DIP-14_L19.0-W7.0-P2.54-LS7.6-BL | 2 | SN74HC32N | TI | LCSC | C2894 | 0.415
2 | SN74HC08N | U18 | DIP794W53P254L1930H508Q14N | 1
3 | 10KΩ | R4,R2,R3 | RES-TH_BD2.3-L6.5-P10.50-D0.5 | 3 | MF1/4W-10K±1%-ST52 | Huaxing Mechanical-Elec. | LCSC | C2903232 | 0.01
4 | 4116R-1-330LF | RN20,RN21,RN22,RN23,RN13,RN14,RN15,RN16,RN17,RN18,RN19 | DIP787W49P254L2197H469Q16N | 11
5 | SA12CA-B | D1 | DO-15_BD3.1-L6.7-P10.70-D0.8-BI | 1 | SA12CA-B | Littelfuse(美国力特) | LCSC | C1666306 | 0.162
6 | SA5.0CA-E3/54 | D3 | DO-15_BD3.4-L6.4-P10.35-D0.8-BI | 1 | SA5.0CA-E3/54 | VISHAY(威世) | LCSC | C1973200 | 0.226
7 | Wurth-Elektronik-694106301002 | 9V-12V-DC | KLDX0202APLT | 1
8 | UVY1C331MED1TD | C1 |  | 1 | UVY1C331MED1TD | Nichicon | Mouser | 647-UVY1C331MED1TD
9 | EEUFR0J471B | C2 | CAPPRD250W55D630H1270 | 1 | EEU-FR0J471B | Panasonic | Mouser | 667-EEU-FR0J471B
10 | 100nF | C3,C14,C15,C16,C17,C18,C19,C20,C21,C22,C23,C24,C25,C26,C27,C28,C29,C30,C31,C32,C33,C34,C35,C36,C37,C38,C39,C40,C41,C42,C43,C44,C45,C46,C47,C48,C49 | CAP-TH_L3.6-W2.3-P5.00-D0.5 | 37 | K104M15X7RF5TH5 | Vishay Intertech | LCSC | C499573 | 0.131
11 | 100µF | C4,C5,C6,C7,C8,C9,C10,C11,C12,C13 | CAP-TH_BD6.3-P2.50-D1.0-FD | 10 | UHE1E101MED1TD | Nichicon | LCSC | C116227 | 0.078
12 | BTSA-N-P-0 | CLK | SW-TH_BTSA-X-P-0 | 1 | BTSA-N-P-0 | ROCPU(台普) | LCSC | C2693689 | 0.174
13 | SB2H100-E3/54 | D2 | DO-15_BD3.1-L6.7-P10.70-D0.9-RD | 1 | 1N5818G | ON Semicon | LCSC | C232462 | 0.285
14 | LTA-1000HR | DS1,DS2,DS3,DS4,DS5,DS6,DS7,DS8 | DIPS762W50P254L2527H825Q20N | 8
15 | 22-28-4020 | IN-SYSTEM | HDR-TH_2P-P2.54-V-M-1 | 1 | 22-28-4020 | MOLEX | LCSC | C234182 | 0.078
16 | PCN10-64ACP-2.54DS_72_ | J1,J2 | PCN1064ACP254DS72 | 2
17 | 500SSP1S2M7QEA | PWSW | SW-TH_500SSP1S2M7QEA | 1 | 500SSP1S2M7QEA | E-Switch | LCSC | C273380 | 4.702
18 | 1KΩ | R1 | RES-TH_BD2.3-L6.3-P10.30-D0.6 | 1 | YR1B1K0CC | TE Connectivity(美国泰科) | LCSC | C1364308 | 0.364
19 | 33Ω | R7 | RES-TH_BD2.3-L6.5-P10.50-D0.5 | 1 |  |  | LCSC
20 | TSR_1-2450 | REG | TSR-1-24120 | 1
21 | 4609H-101-103LF | RN1,RN2,RN5,RN6 | 4609H101103LF | 4
22 | 4116R-1-102LF | RN3,RN4,RN7,RN8,RN9,RN10,RN11,RN12 | DIP787W49P254L2197H469Q16N | 8
23 | 2-5435668-8 | S1,S2,S3,S4 | 254356688 | 4
24 | SN74HC14N | U1,U8,U9 | DIP-14_L19.2-W6.6-P2.54-LS10.9-BL | 3 | SN74HC14N | TI | LCSC | C2907 | 1.341
25 | SN74HC245N | U2,U3,U4,U5,U6,U7,U10,U11,U12,U13,U14,U15,U23,U24,U25,U26,U27,U28,U29,U30,U31,U32,U33,U34,U35,U36 | DIP-20_L26.8-W6.4-P2.54-LS7.6-BL | 26 | SN74HC245N | TI | LCSC | C2899 | 0.5
26 | SN74HC377N | U19,U20,U21,U22 | DIP-20_L25.5-W10.0-P2.54-LS7.6-BL | 4 | SN74HC377N | TI | LCSC | C5335 | 0.498
27 | Wurth-Elektronik-151051BS04000 | ON | LED-TH_BD3.0-P2.54-FD | 1 | TJ-L3FYWGHRMFCSFLC2R-A5 | TOGIALED | LCSC | C331041 | 0.035
