TheByteAttic/TalosES/Motherboard/BoM TalosES™ Motherboard.csv

ID | Name | Designator | Footprint | Quantity | Manufacturer Part | Manufacturer | Supplier | Supplier Part | Price
1 | SA15CA-E3/54 | D4,D5 | DO-204AC_BD3.4-L6.4-RD | 2 | SA15CA-E3/54 | VISHAY(威世) | LCSC | C1973210 | 0.393
2 | 100µF | C2,C48,C49,C50,C51,C52 | CAP-TH_BD6.3-P2.50-D1.0-FD | 6 | UHE1E101MED1TD | Nichicon | LCSC | C116227 | 0.084
3 | 33Ω | R2,R3,R4,R6,R7,R19,R20,R25,R27,R28,R29,R30 | RES-TH_BD2.3-L6.5-P10.50-D0.5 | 12 |  |  | LCSC
4 | 10KΩ | R8,R13,R14,R21,R22,R23,R26 | RES-TH_BD2.3-L6.5-P10.50-D0.5 | 7 | MF1/4W-10K±1%-ST52 | Huaxing Mechanical-Elec. | LCSC | C2903232 | 0.011
5 | 100nF | C57,C47,C3,C5,C6,C7,C8,C9,C10,C11,C13,C18,C23,C24,C25,C26,C27,C28,C29,C30,C31,C32,C33,C34,C35,C36,C37,C38,C39,C40,C41,C42,C43,C44,C45,C46 | CAP-TH_L3.6-W2.3-P5.00-D0.5 | 36 | K104M15X7RF5TH5 | Vishay Intertech | LCSC | C499573 | 0.056
6 | SN74HC32N | U18 | DIP-14_L19.0-W7.0-P2.54-LS7.6-BL | 1 | SN74HC32N | TI(德州仪器) | LCSC | C2894 | 0.492
7 | 6E17C009SAJ220 | RS232 | DB933PAM09G30TN | 1
8 | 1uF | C53,C54,C55,C56,C12,C14,C15,C16,C19 | CAP-TH_L7.6-W3.8-P5.08-D1.0 | 9 | SR305C105KARTR1 | Kyocera AVX | LCSC | C444742 | 0.559
9 | B57238S0709M000 | RT1,RT2 | B57238S0 | 2
10 | 1KΩ | R1 | RES-TH_BD2.3-L6.3-P10.30-D0.6 | 1 | YR1B1K0CC | TE Connectivity(美国泰科) | LCSC | C1364308 | 0.354
11 | 3.3kΩ | R5,R9,R10,R11,R12,R15,R17,R24 | RES-TH_BD2.3-L6.5-P10.50-D0.5 | 8 | MF1/4W-3.3KΩ±1% T | CCO(千志电子) | LCSC | C119335 | 0.009
12 | 4609H-101-103LF | RN3,RN4,RN5,RN6,RN9,RN10,RN1,RN2 | 4609H101103LF | 8
13 | 4116R-1-330LF | RN7,RN8 | DIP787W49P254L2197H469Q16N | 2
14 | PCN10-64ACS-2.54DSA_72_ | AL1,AL2,ALU1,ALU2,CTRL1,CTRL2,RF1,RF2 | PCN1064ACS254DSA72 | 8
15 | Wurth-Elektronik-694106301002 | BC-12V-DC | KLDX0202APLT | 1
16 | UVY1C331MED1TD | C1 | CAPPRD250W55D630H1270 | 1 | UVY1C331MED1TD | Nichicon | Mouser | 647-UVY1C331MED1TD
17 | EEUFR0J471B | C4,C20,C21,C22 | CAPPRD250W55D630H1270 | 4 | EEU-FR0J471B | Panasonic | Mouser | 667-EEU-FR0J471B
18 | SA12CA-B | D1 | DO-15_BD3.1-L6.7-P10.70-D0.8-BI | 1 | SA12CA-B | Littelfuse(美国力特) | LCSC | C1666306 | 0.157
19 | MBR10H100-E3_45 | D2 | TO508P470X1010X1989-2P | 1
20 | SA5.0CA-E3/54 | D3,D6,D7,D8,D9 | DO-15_BD3.4-L6.4-P10.35-D0.8-BI | 5 | SA5.0CA-E3/54 | VISHAY(威世) | LCSC | C1973200 | 0.415
21 | 71256SA25TPG | DM1,DM2,IM1,IM2 | PDIP-28_L35.0-W7.3-P2.54-LS7.8-BL | 4 | 71256SA25TPG | RENESAS(瑞萨)/IDT | LCSC | C1349137 | 3.088
22 | MF-R600-2 | F1 | MFR6002 | 1
23 | SN74HC161N | FRQDIV | PDIP-16_L19.3-W6.4-P2.54-LS7.9-BL | 1 | SN74HC161N | TI(德州仪器) | LCSC | C273647 | 0.447
24 | SSW-106-02-F-S-RA | FTDI,SD-CARD-ADAPTER-PORT2 | SSW-106-XX-YYY-S-RA | 2
25 | ATMEGA1284P-PU | IOCTRL | PDIP-40_L52.3-W13.8-P2.54-LS15.2-BL | 1 | ATMEGA1284P-PU | MICROCHIP(美国微芯) | LCSC | C116839 | 11.752
26 | SN74HC377N | LDMAH,LDMAL,LDMD,LIMAH,LIMAL,LIMD | DIP-20_L25.5-W10.0-P2.54-LS7.6-BL | 6 | SN74HC377N | TI | LCSC | C5335 | 0.649
27 | LM1086T-3.3 | LDO | TO-220-3_L10.0-W4.5-P2.54-L | 1 | LM1086T-3.3 | HGSEMI(华冠) | LCSC | C444381 | 0.282
28 | 215760-1002 | MOLEX-12V-DC | 215760-YY02 | 1
29 | MXO45HS-3C-18M4320 | OSC | MXO45HS3C18M4320 | 1
30 | Wurth-Elektronik-151051BS04000 | PWR | LED-TH_BD3.0-P2.54-FD | 1 | TJ-L3FYWGHRMFCSFLC2R-A5 | TOGIALED | LCSC | C331041 | 0.032
31 | 500SSP1S2M7QEA | PWSW | SW-TH_500SSP1S2M7QEA | 1 | 500SSP1S2M7QEA | E-Switch | LCSC | C273380 | 1.57
32 | TSR_1-2450 | REG | TSR-1-24120 | 1
33 | MAX232N | RS232LVLSHF | PDIP-16_L19.7-W6.6-P2.54-LS7.8-BL | 1 | MAX232N | Texas Instruments | LCSC | C353147 | 1.912
34 | 2-5435668-8 | S1 | 254356688 | 1
35 | MOLEX 90147-1106 | SD-CARD-ADAPTER-PORT1 | HDR-F-2.54_1X6 | 1
36 | Header-Male-2.54_1x6 | SPI | HDR-TH_6P-P2.54-V-M-1 | 1 | 2.54-1x6P直针 | BOOMELE(博穆精密) | LCSC | C37208 | 0.028
37 | X6511WV-03H-C30D60 | TRMSLC | HDR-TH_3P-P2.54-V-M | 1 | X6511WV-03H-C30D60 | XKB Connectivity(中国星坤) | LCSC | C706875 | 0.054
38 | PZ254-1-06-Z-8.5 | TTGO | HDR-TH_06P-P2.54-V-M | 1 | PZ254-1-06-Z-8.5 | HCTL(华灿天禄) | LCSC | C2894929 | 0.064
39 | SN74HC125N | TTGOLVLSHF | PDIP-14_L19.3-W6.4-P2.54-LS7.6-BL | 1 | SN74HC125N | TI(德州仪器) | LCSC | C2890 | 0.42
40 | SN74HC74N | U1 | PDIP-14_L19.3-W6.4-P2.54-LS7.6-BL | 1 | SN74HC74N | TI(德州仪器) | LCSC | C2895 | 0.823
41 | SN74HCT125N | U3 | PDIP-14_L19.3-W6.4-P2.54-LS7.6-BL | 1 | SN74HCT125N | Texas Instruments | LCSC | C154102 | 0.457
42 | SN74HC14N | U2,U14,U17 | DIP-14_L19.2-W6.6-P2.54-LS10.9-BL | 3 | SN74HC14N | TI | LCSC | C2907 | 0.784
43 | SN74HC138N | U4 | DIP-16_L19.7-W6.6-P2.54-LS10.9-BL | 1 | SN74HC138N | TI(德州仪器) | LCSC | C2913 | 1.009
44 | SN74HC245N | U5,U6,U7,U8,U9,U10,U11,U12,U15,U16 | DIP-20_L26.8-W6.4-P2.54-LS7.6-BL | 10 | SN74HC245N | TI | LCSC | C2899 | 0.582
45 | SN74HC08N | U13 | DIP794W53P254L1930H508Q14N | 1
46 | PZ254V-11-04P_C2691448 | UART1 | HDR-TH_4P-P2.54-V-M | 1 | PZ254V-11-04P | XFCN(兴飞) | LCSC | C2691448 | 0.023
47 | 61900411121 | WRWTB-12V-DC | SHDR4W64P0X254_1X4_1020X580X11 | 1
