TheByteAttic/TalosES/(threads)

Thread 1 (2023-09-10):

Incorrect LCSC product number (C713947)

ronaldmaas, 2023-09-10:
For the 10K resistor which features in several boards the incorrect product number, C713947, is added to the BOM files. It should be C714634. Although that resistor has a different tolerance. I guess the tolerance is not massively important. However the value of the resistor is. Just want to stop people ordering blindly of the BOM.

TheByteAttic, 2023-09-10:
Some boards in TalosES do use discrete resistors. Which BoM are you referring to, specifically? The BoM is generated automatically by the CAD tool, directly from the schematic.

ronaldmaas, 2023-09-10:
All the BOM files, the 4 of the different cards and the motherboard. The manufacturer part is MF1/4W-1Ω±1%T52, which refers to a 1Ohm resistor. Maybe something not quite linked correctly?

TheByteAttic, 2023-09-11:
Thanks. I will investigate this as soon as I get home on Sunday (on the road right now, slow Internet).

TheByteAttic, 2024-03-12:
Apologies for the delay, Ronald, this fell through the cracks. It's all corrected now, for all five boards; all five BoM files are updated to use LCSC part number C2903232.

Closed 2024-03-12.
