TheByteAttic/TalosES/Motherboard/Schematics TalosES™ Motherboard.pdf

A | A

## SA12CA-B

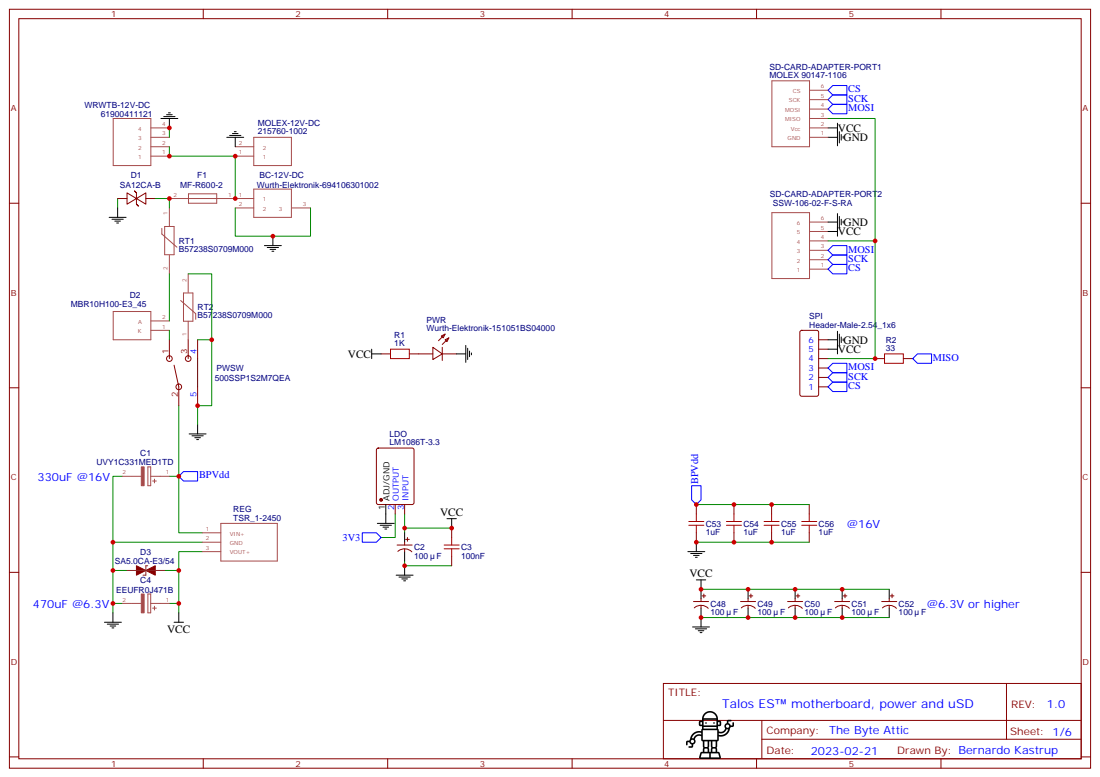
[picture p111: page 1]

Company: The Byte Attic

Drawn By: Bernardo Kastrup

A | A

## ATMEGA1284P-PU

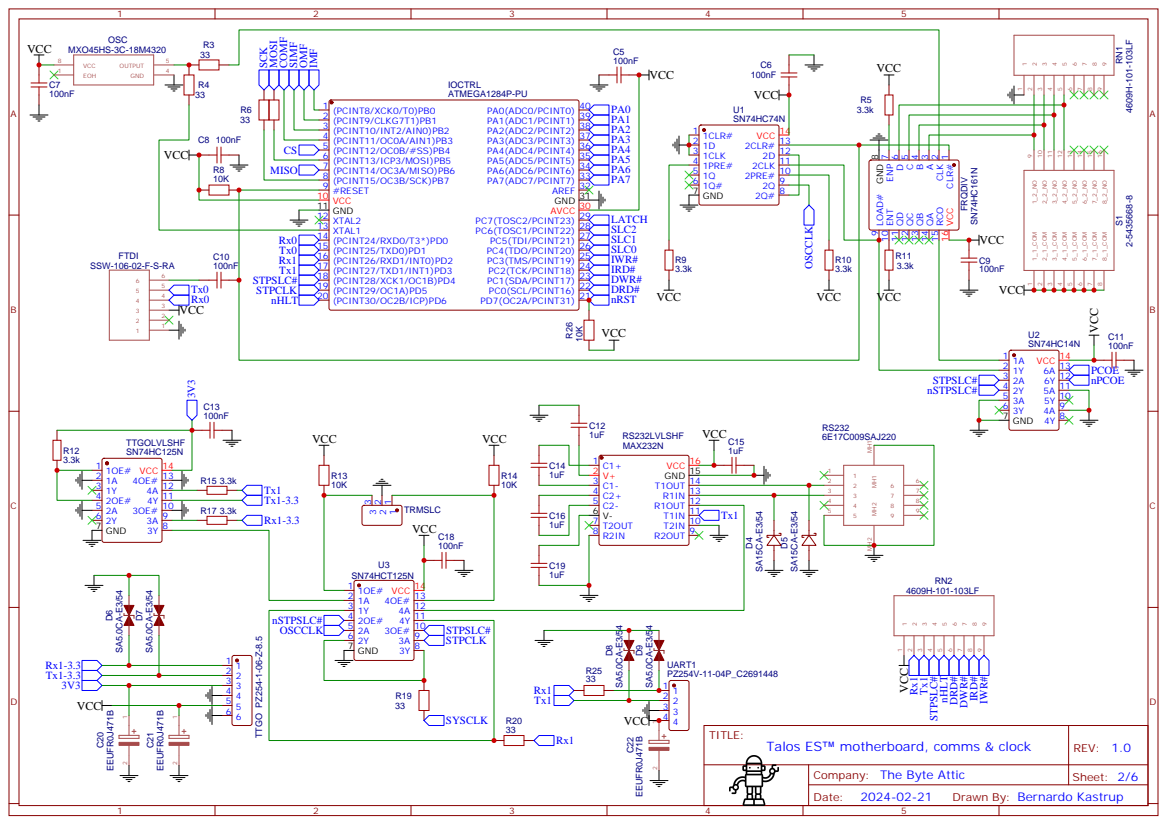
[picture p112: page 2]

VCC 16 RCO 15 QA 14 QB 13 QC 12 QD 11 ENT 10 LOAD#

A | A

## SN74HC138N

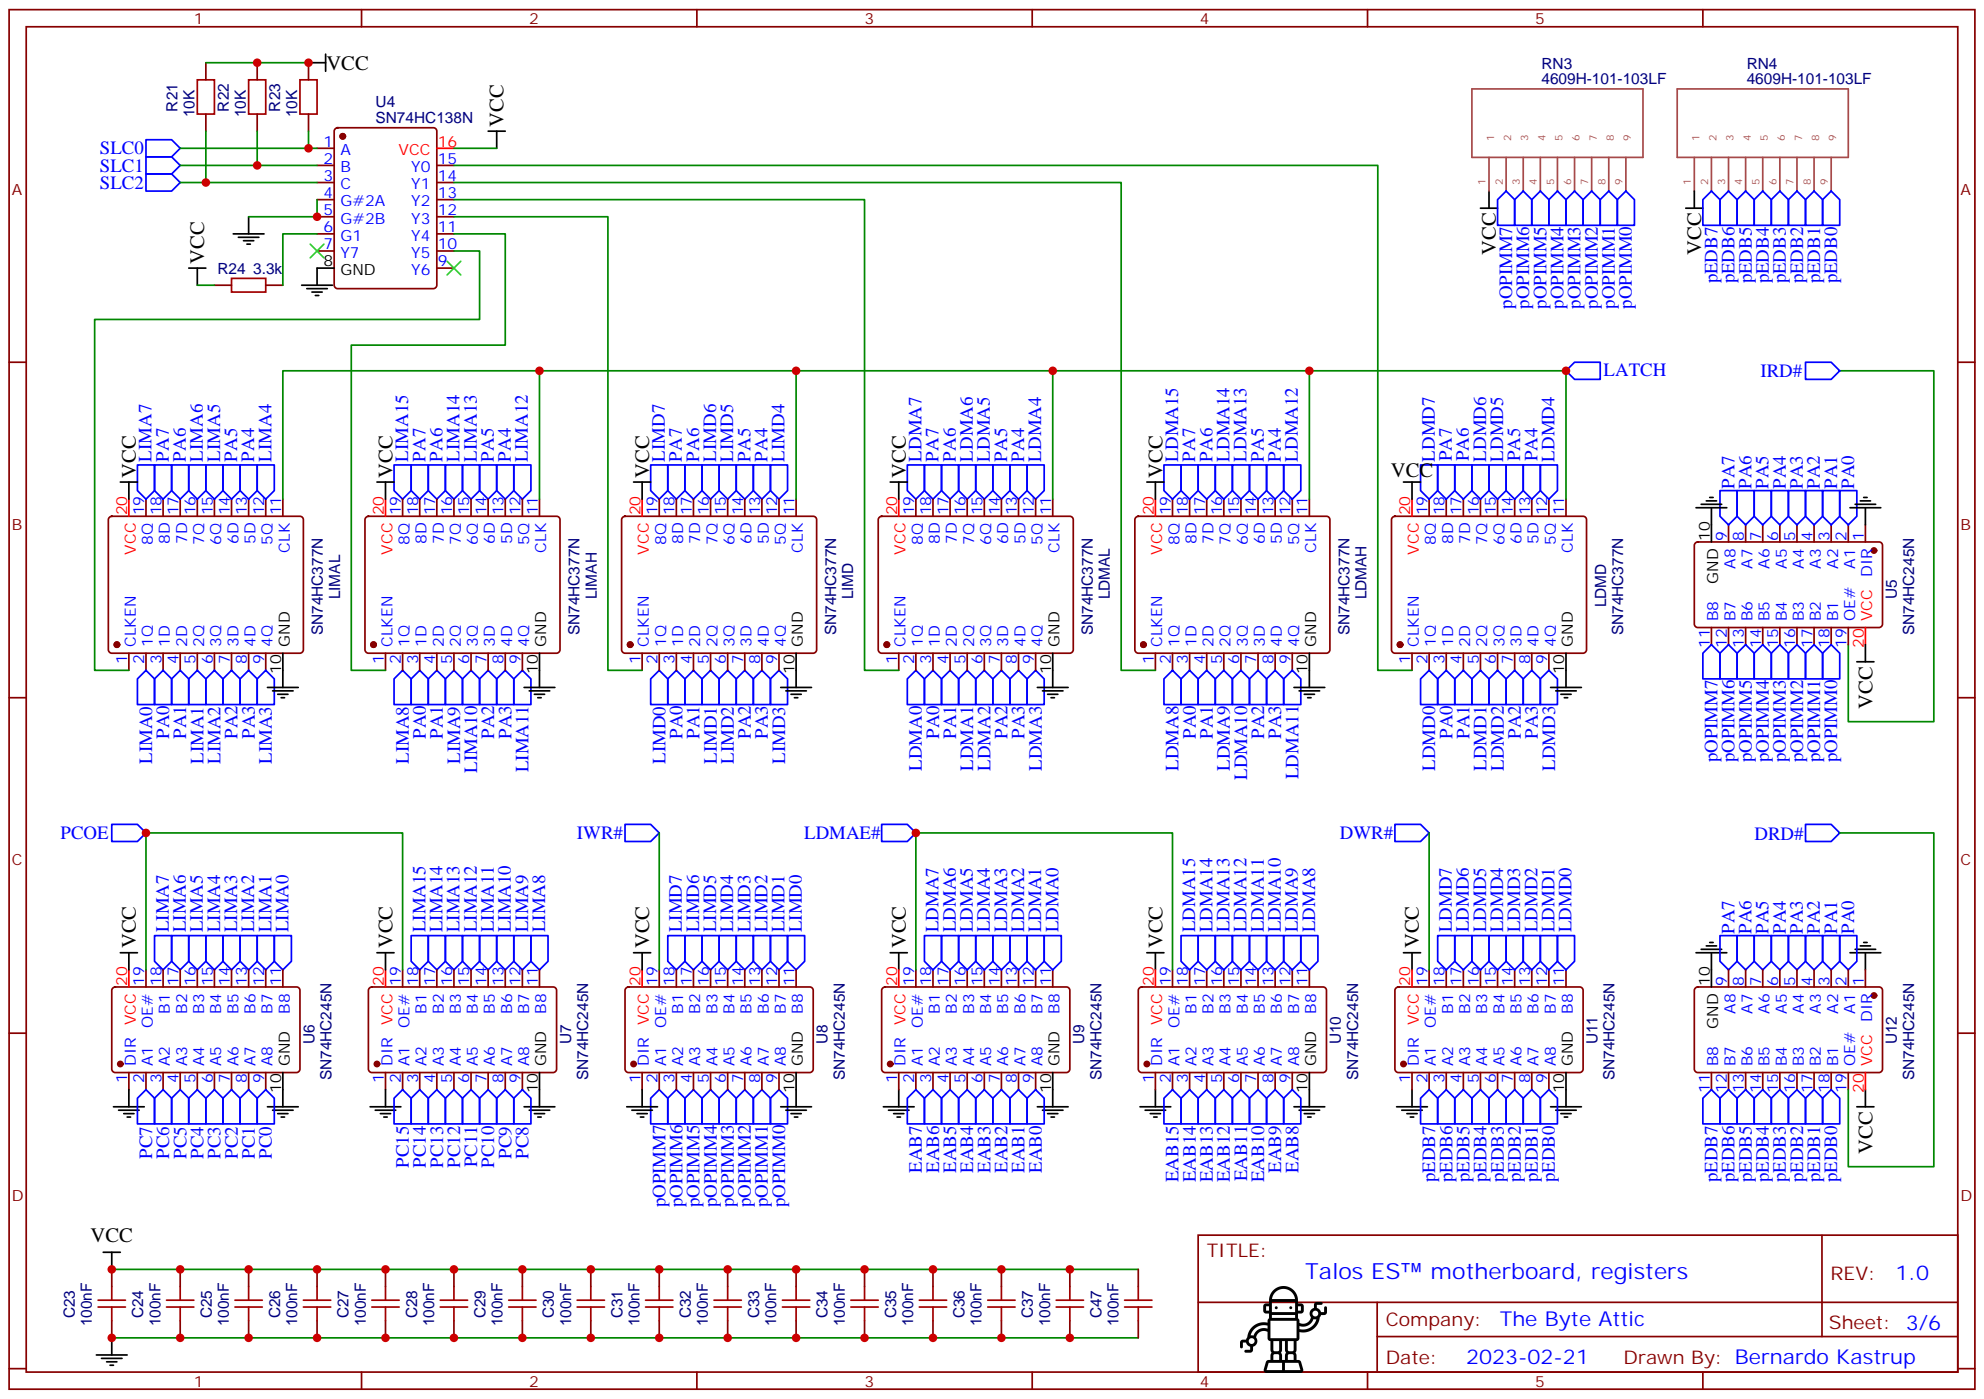
[picture p113: page 3]

GND 10 B8 11 B7 12 B6 13 B5 14 B4 15 B3 16 B2 17 B1 18 OE# 19 VCC 20 VCC PC7 PC6 PC5 PC4 PC3 PC2 PC1 PC0

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

A | A

## EAB14

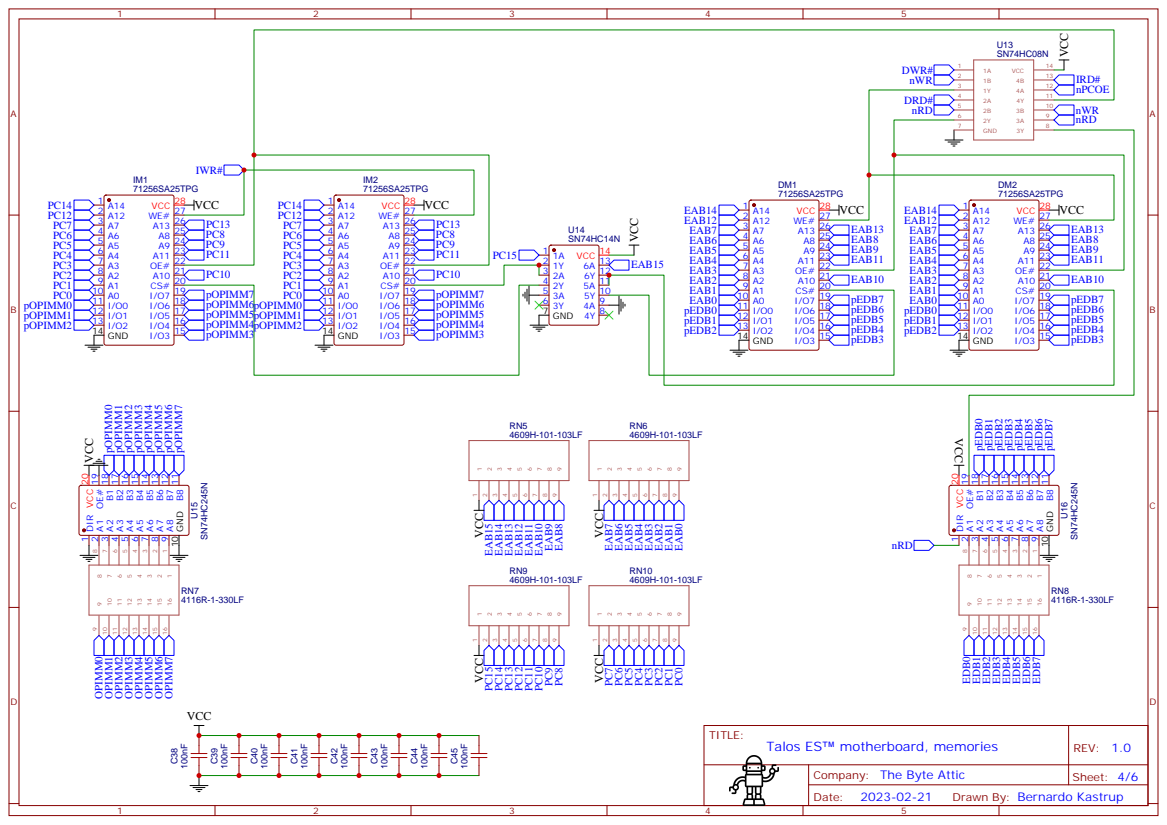
[picture p114: page 4]

A

A

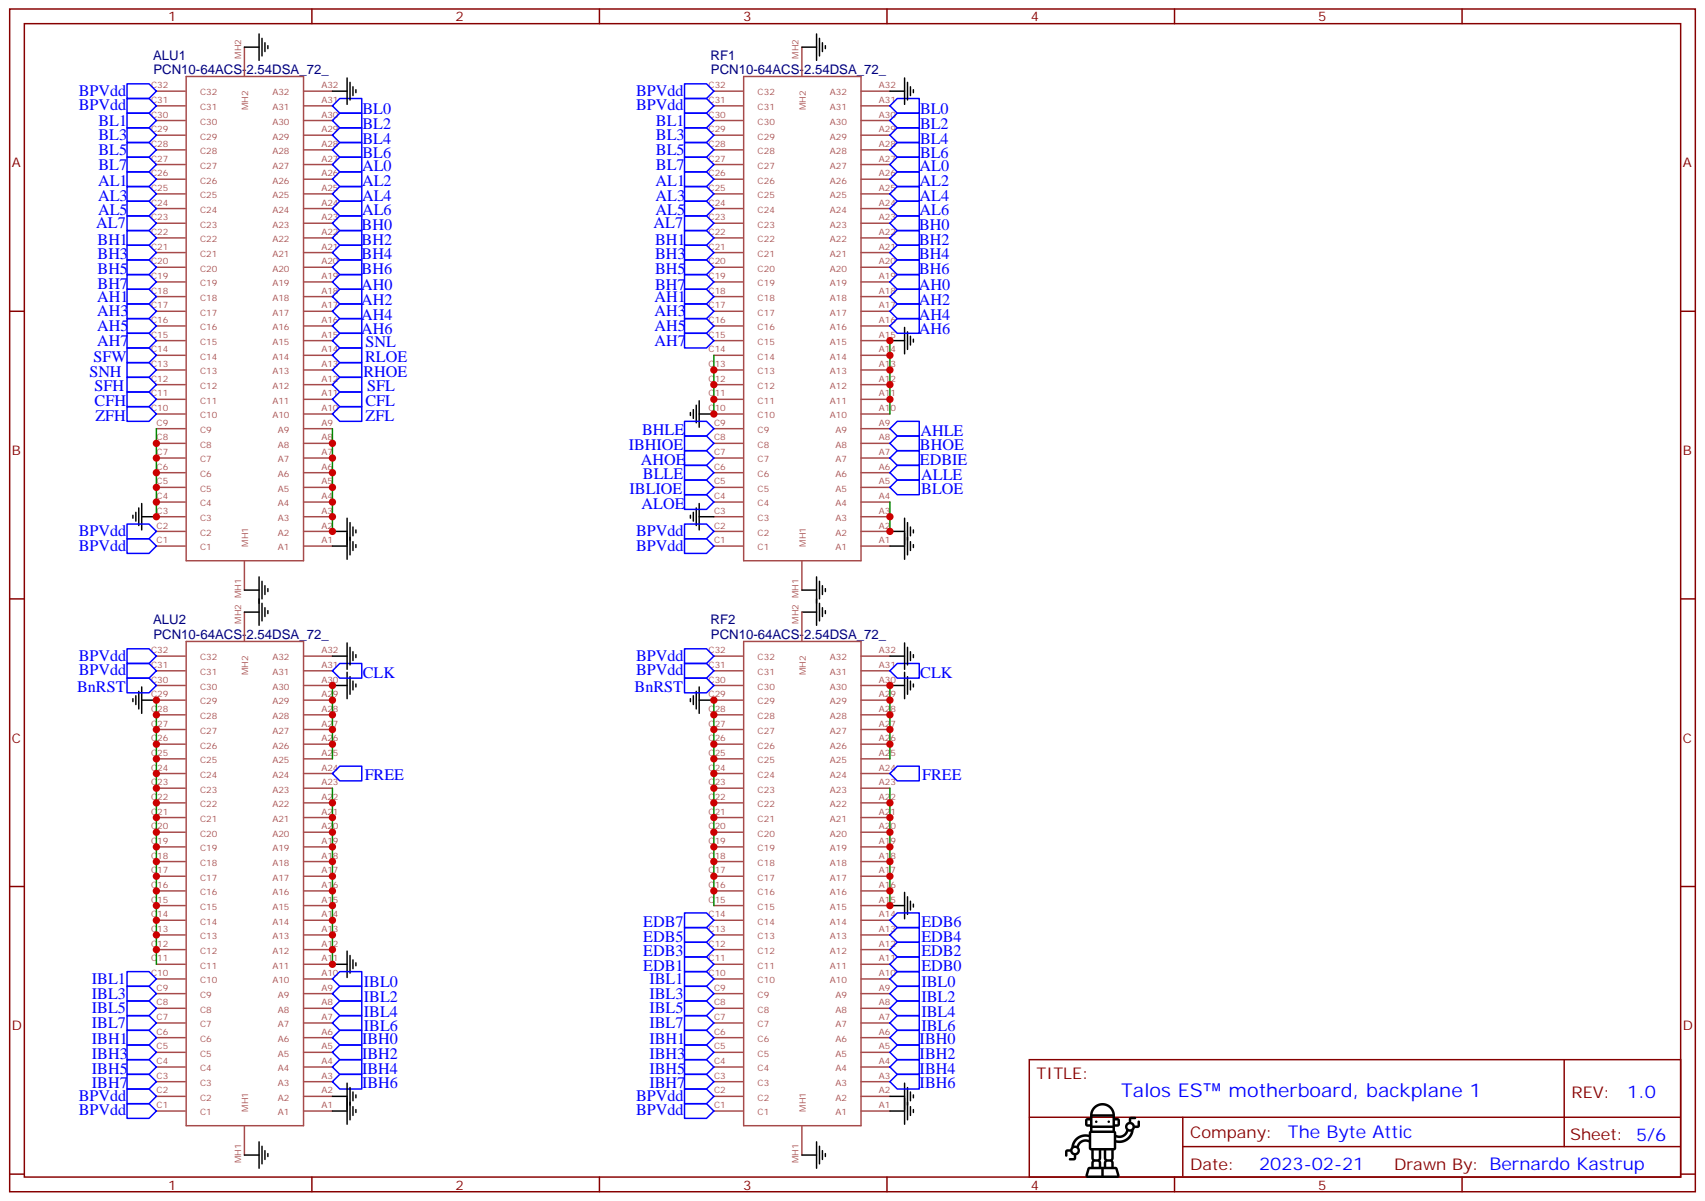
[picture p115: page 5]

A

A

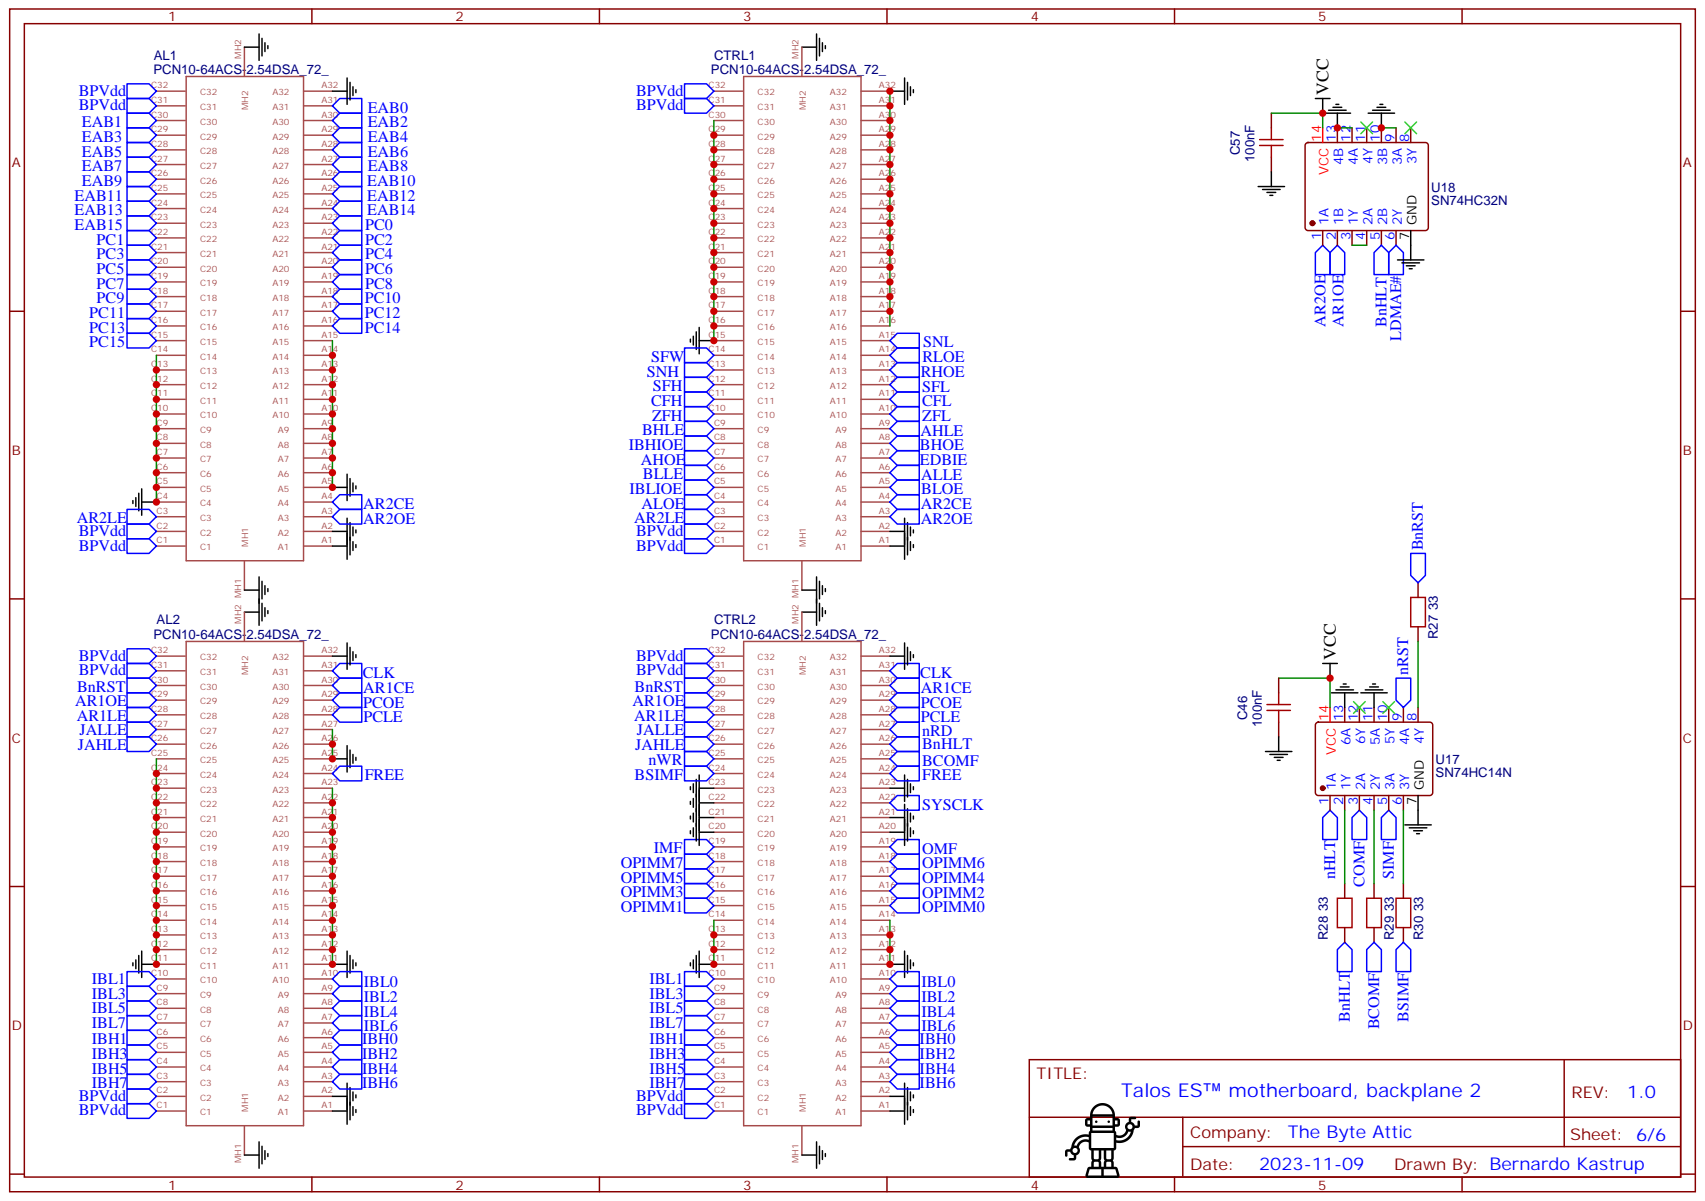
[picture p116: page 6]

C5 | A5
C4 | A4
