TheByteAttic/TalosES/CTRL card/Talos ES™ CTRL Schematics.pdf

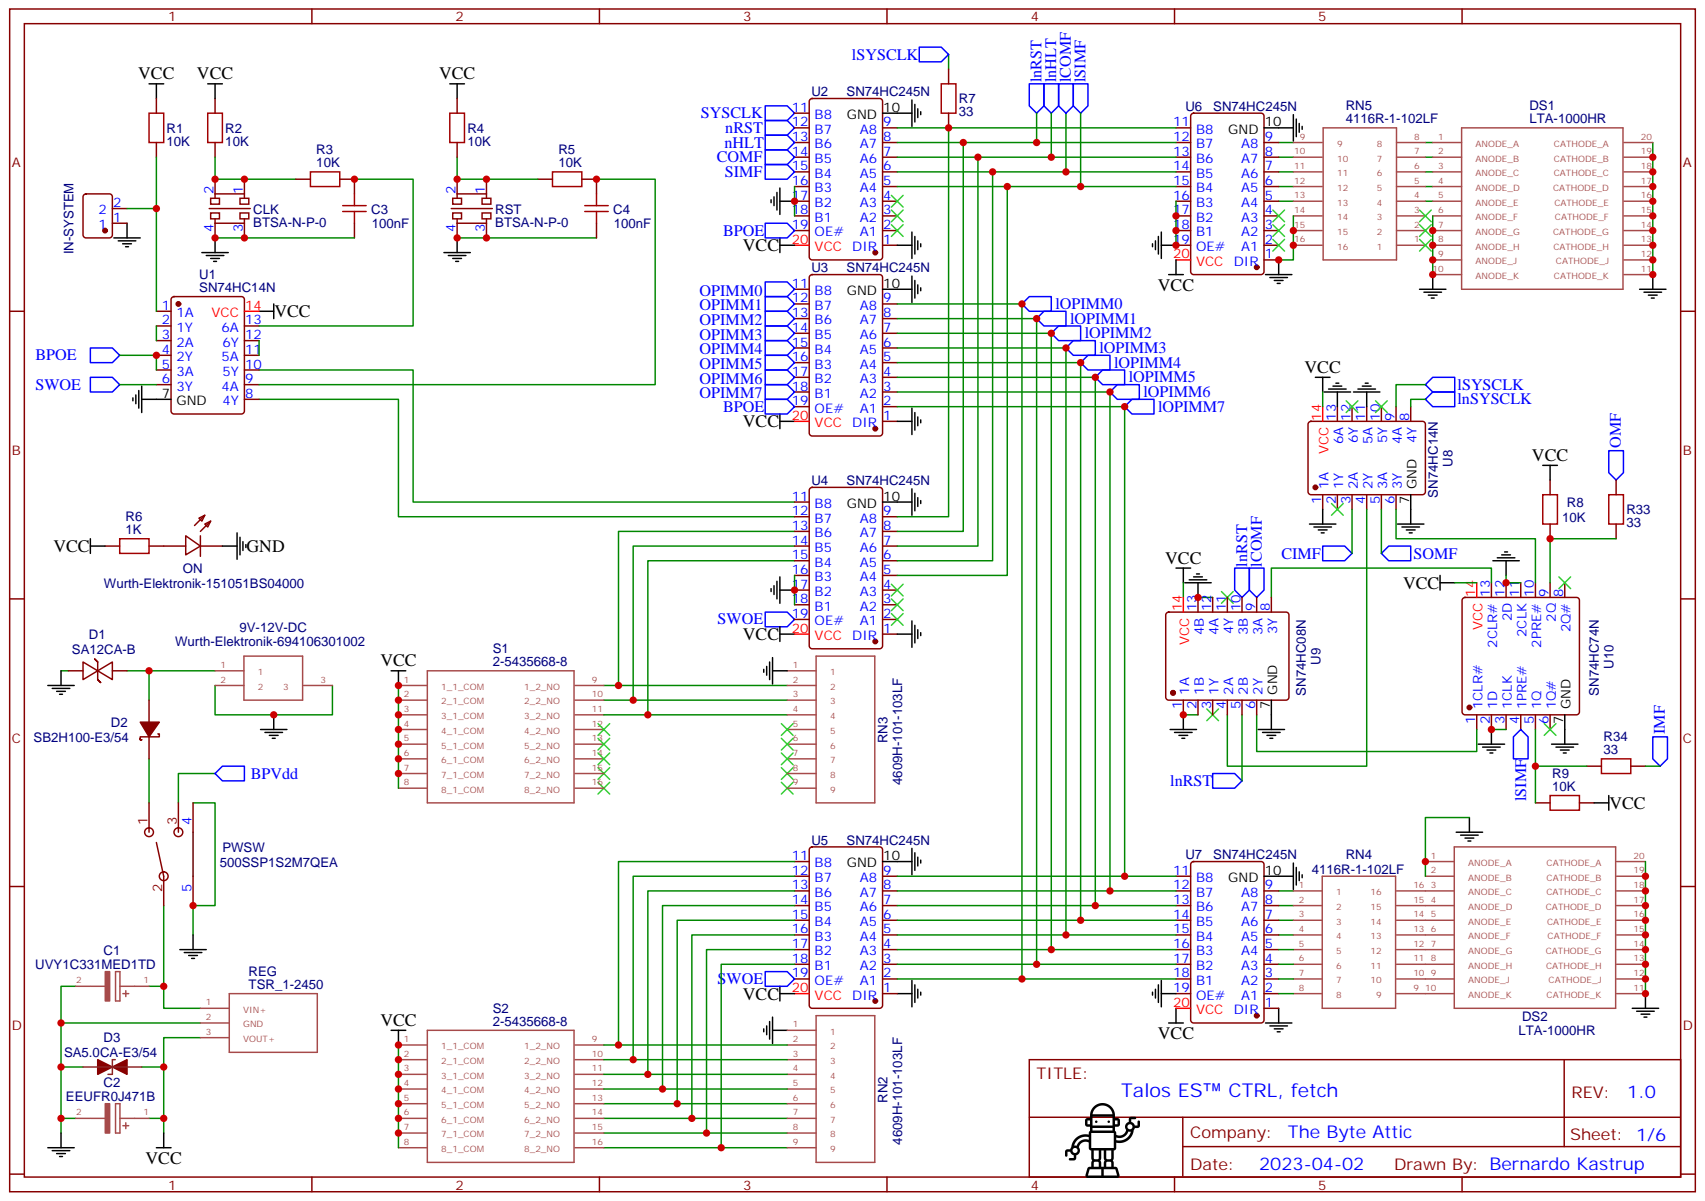
[picture p117: page 1]

7 2 | 19
6 3 | 18
5 4 | 17
4 5 | 16
6 | 15

9 | 12
10 | 11

2 | 10 3
3 | 11 4

15 4 | 17
14 5 | 16
13 6 | 15
12 7 | 14
11 8 | 13
10 9 | 12
9 10 | 11

4 | 12 5
5 | 13 6

Company: The Byte Attic

Drawn By: Bernardo Kastrup

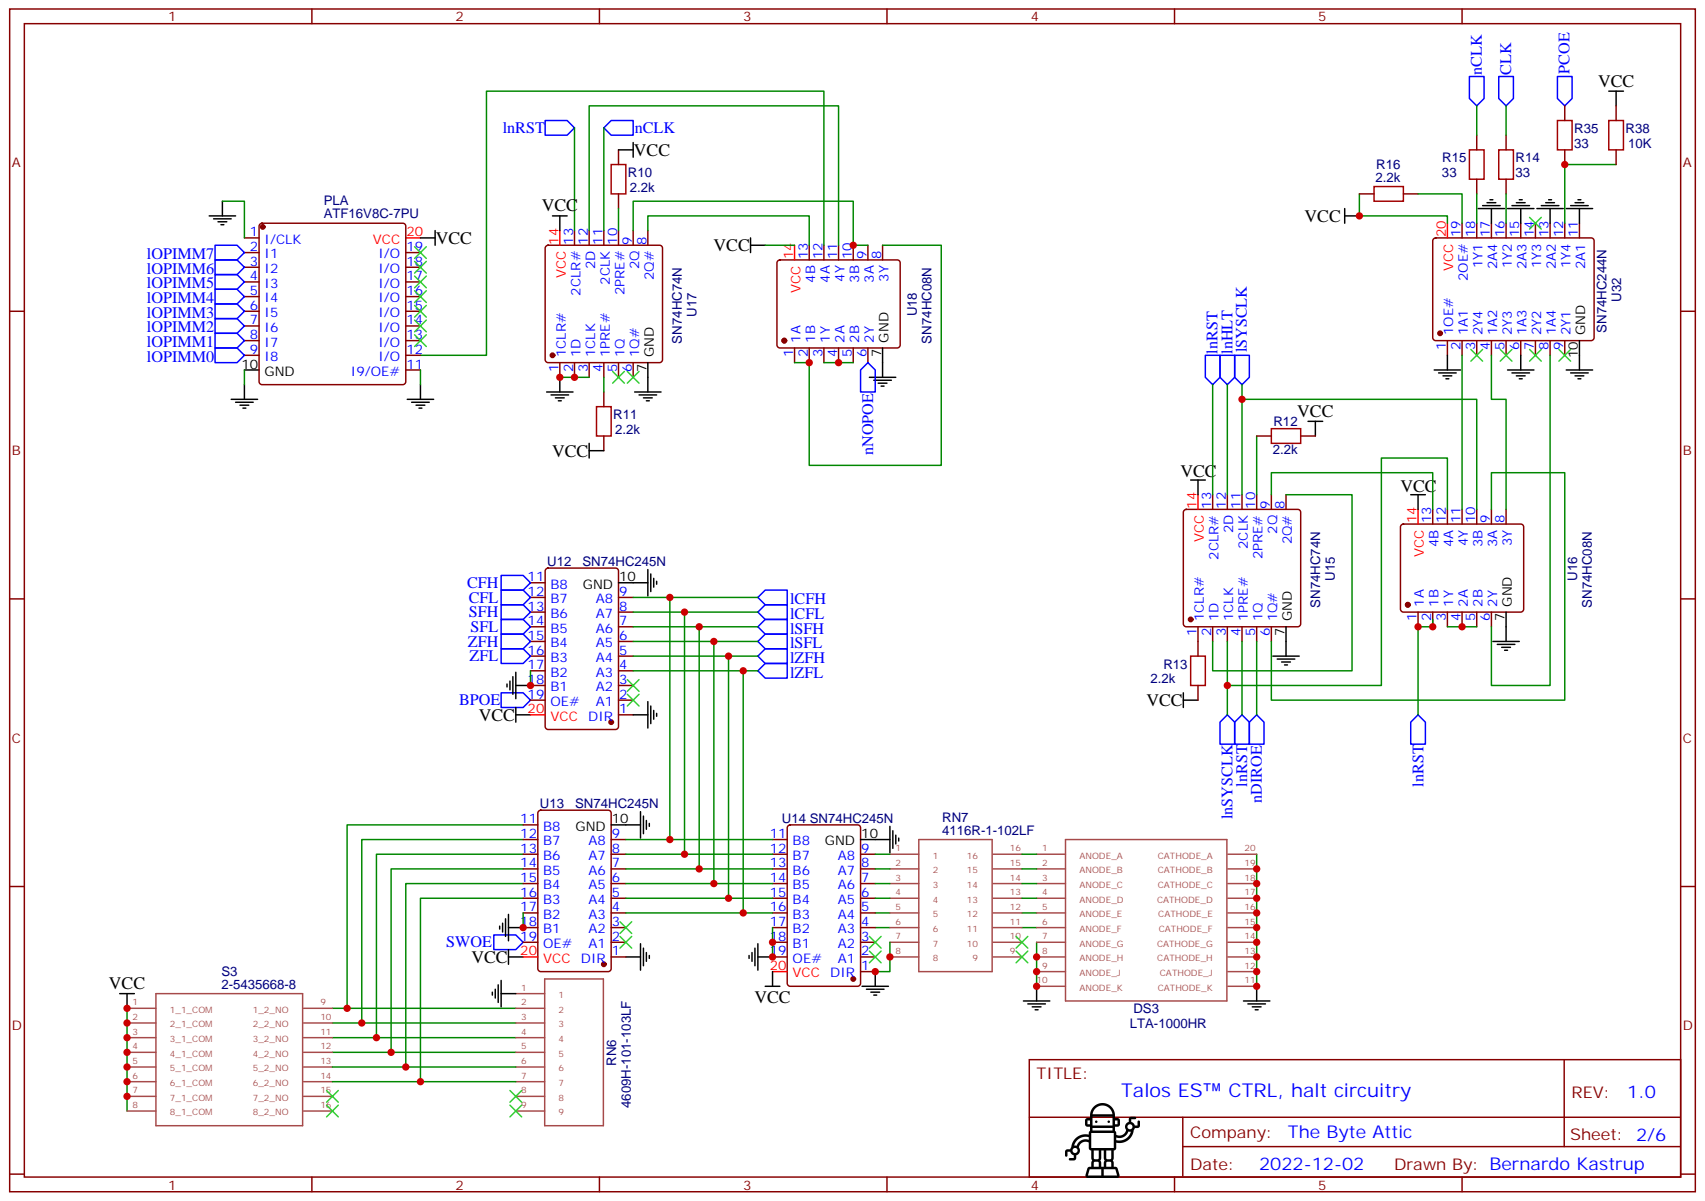
[picture p118: page 2]

15 2 | 19
14 3 | 18
13 4 | 17
12 5 | 16
11 6 | 15
7 | 14

9 | 12
10 | 11

2 | 10 3
3 | 11 4
4 | 12 5
5 | 13 6
6 | 14 7

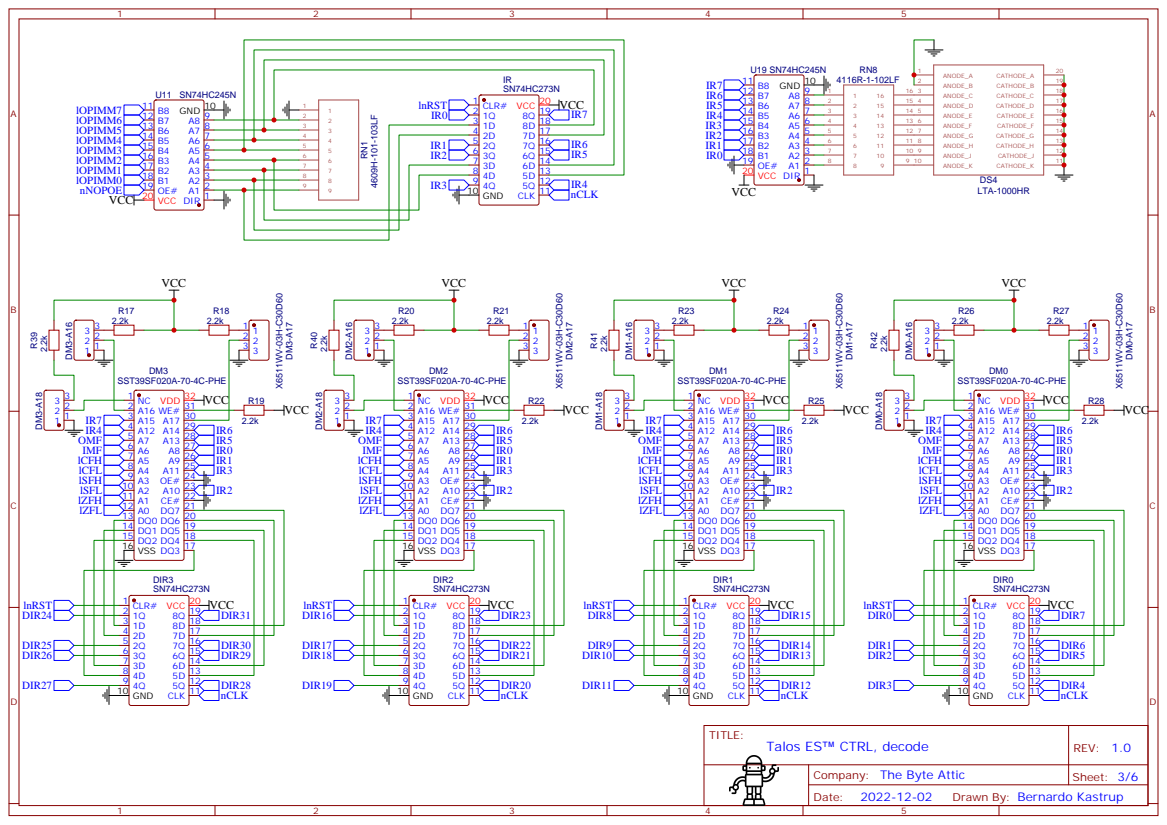
[picture p119: page 3]

15 4 | 17
14 5 | 16

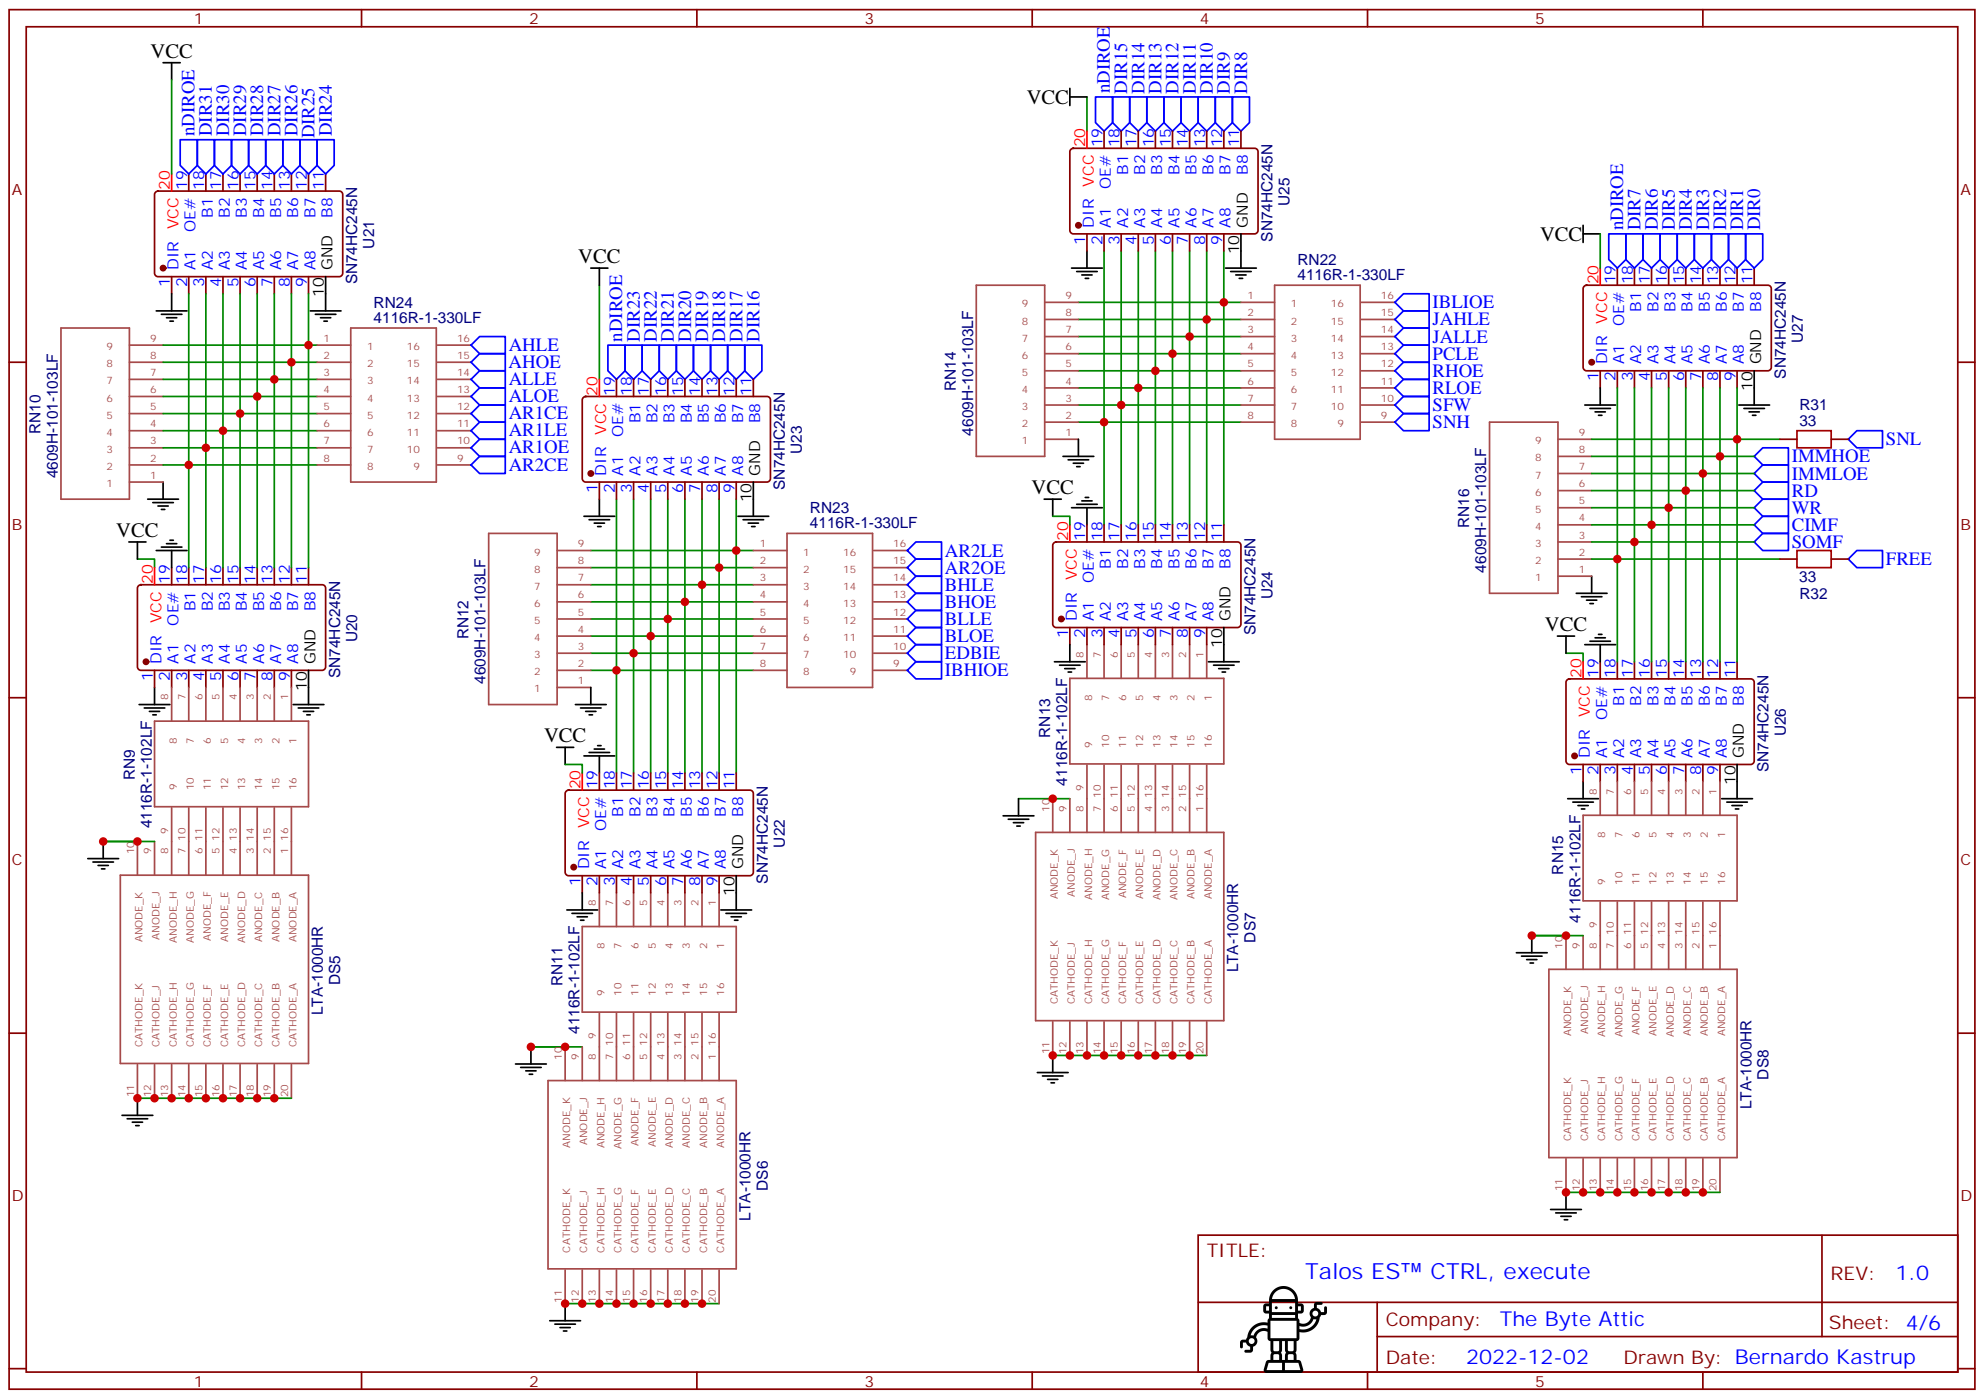
[picture p120: page 4]

GND 10 B8 11 B7 12 B6 13 B5 14 B4 15 B3 16 B2 17 B1 18 OE# 19 VCC 20 nDIROE

2 1

GND 10 B8 11 B7 12 B6 13 B5 14 B4 15 B3 16 B2 17 B1 18 OE# 19 VCC 20 LTA-1000HR

# lOPIMM0 4116R⁻¹⁻¹⁰²LF RN¹⁷

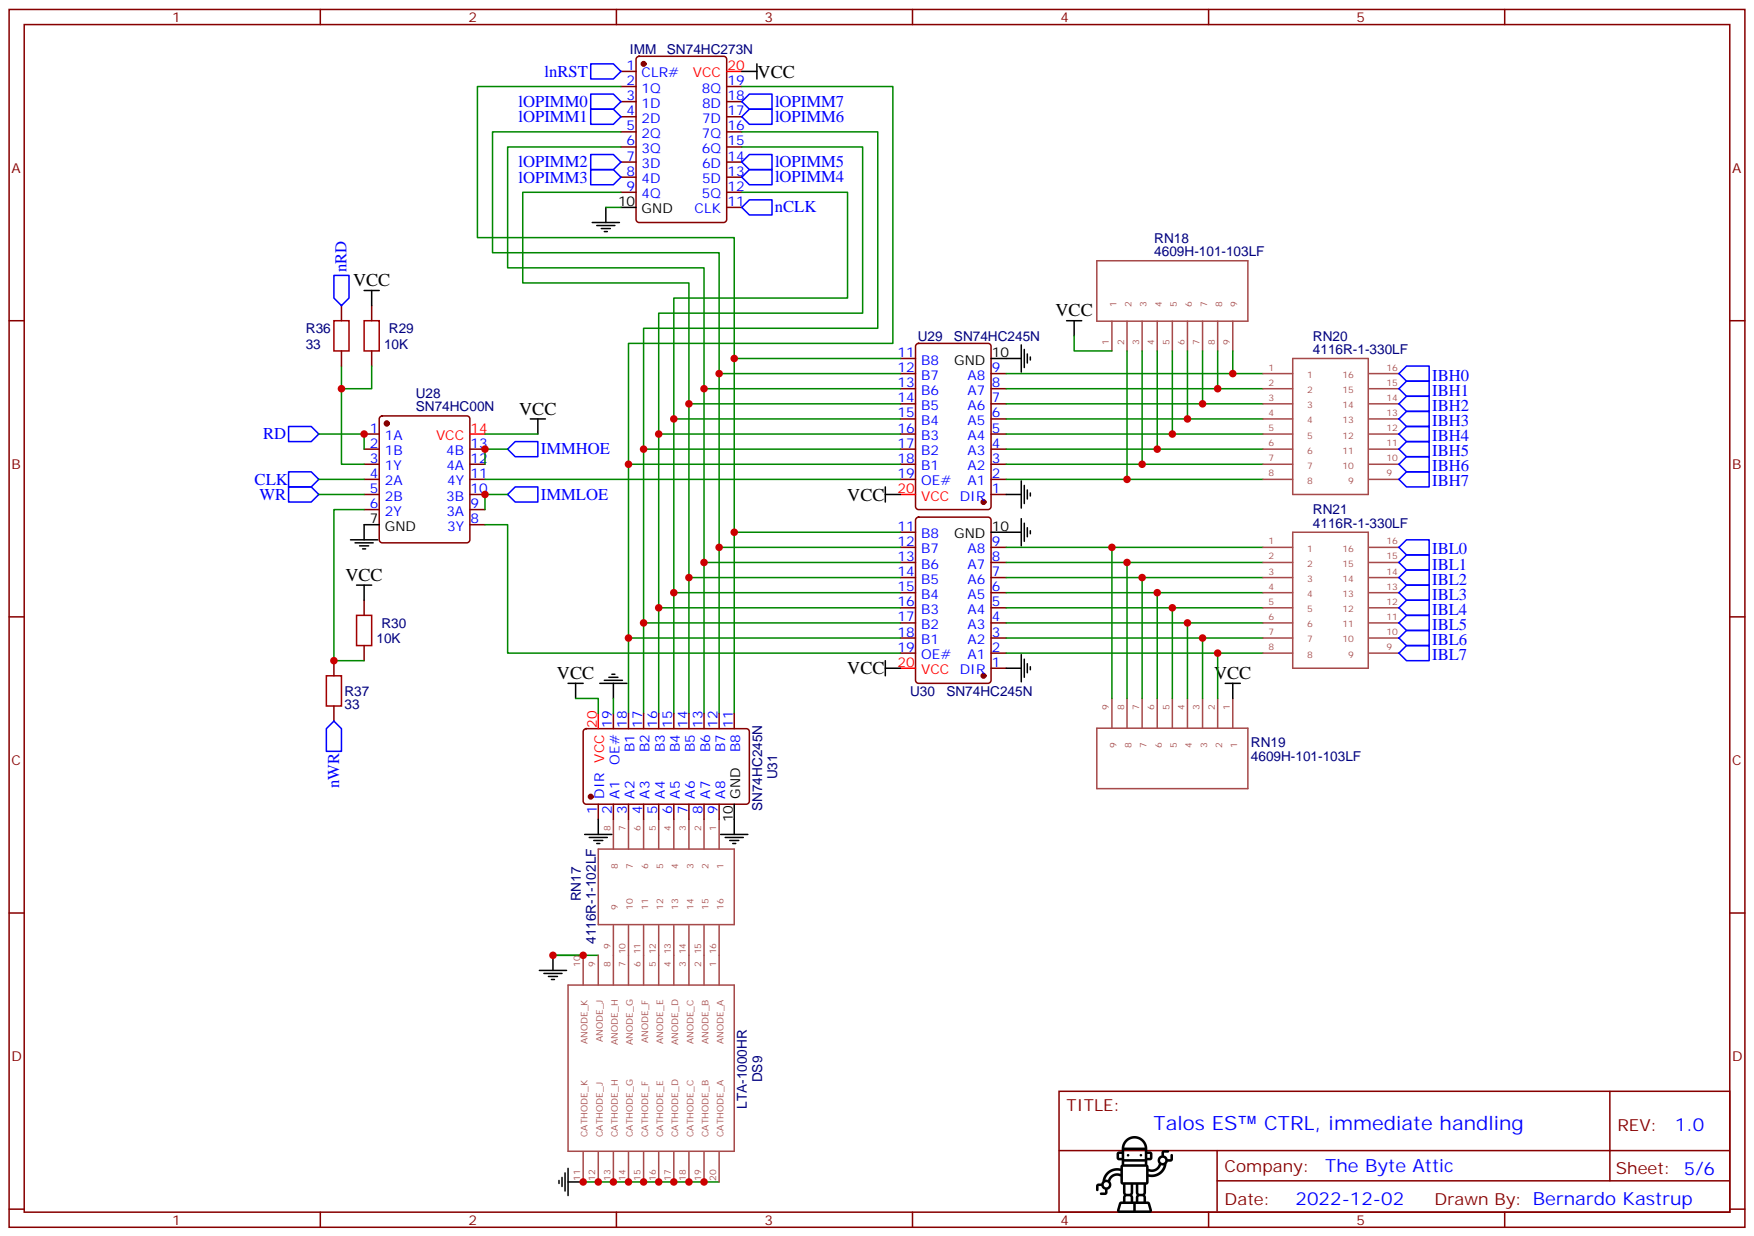
[picture p121: page 5]

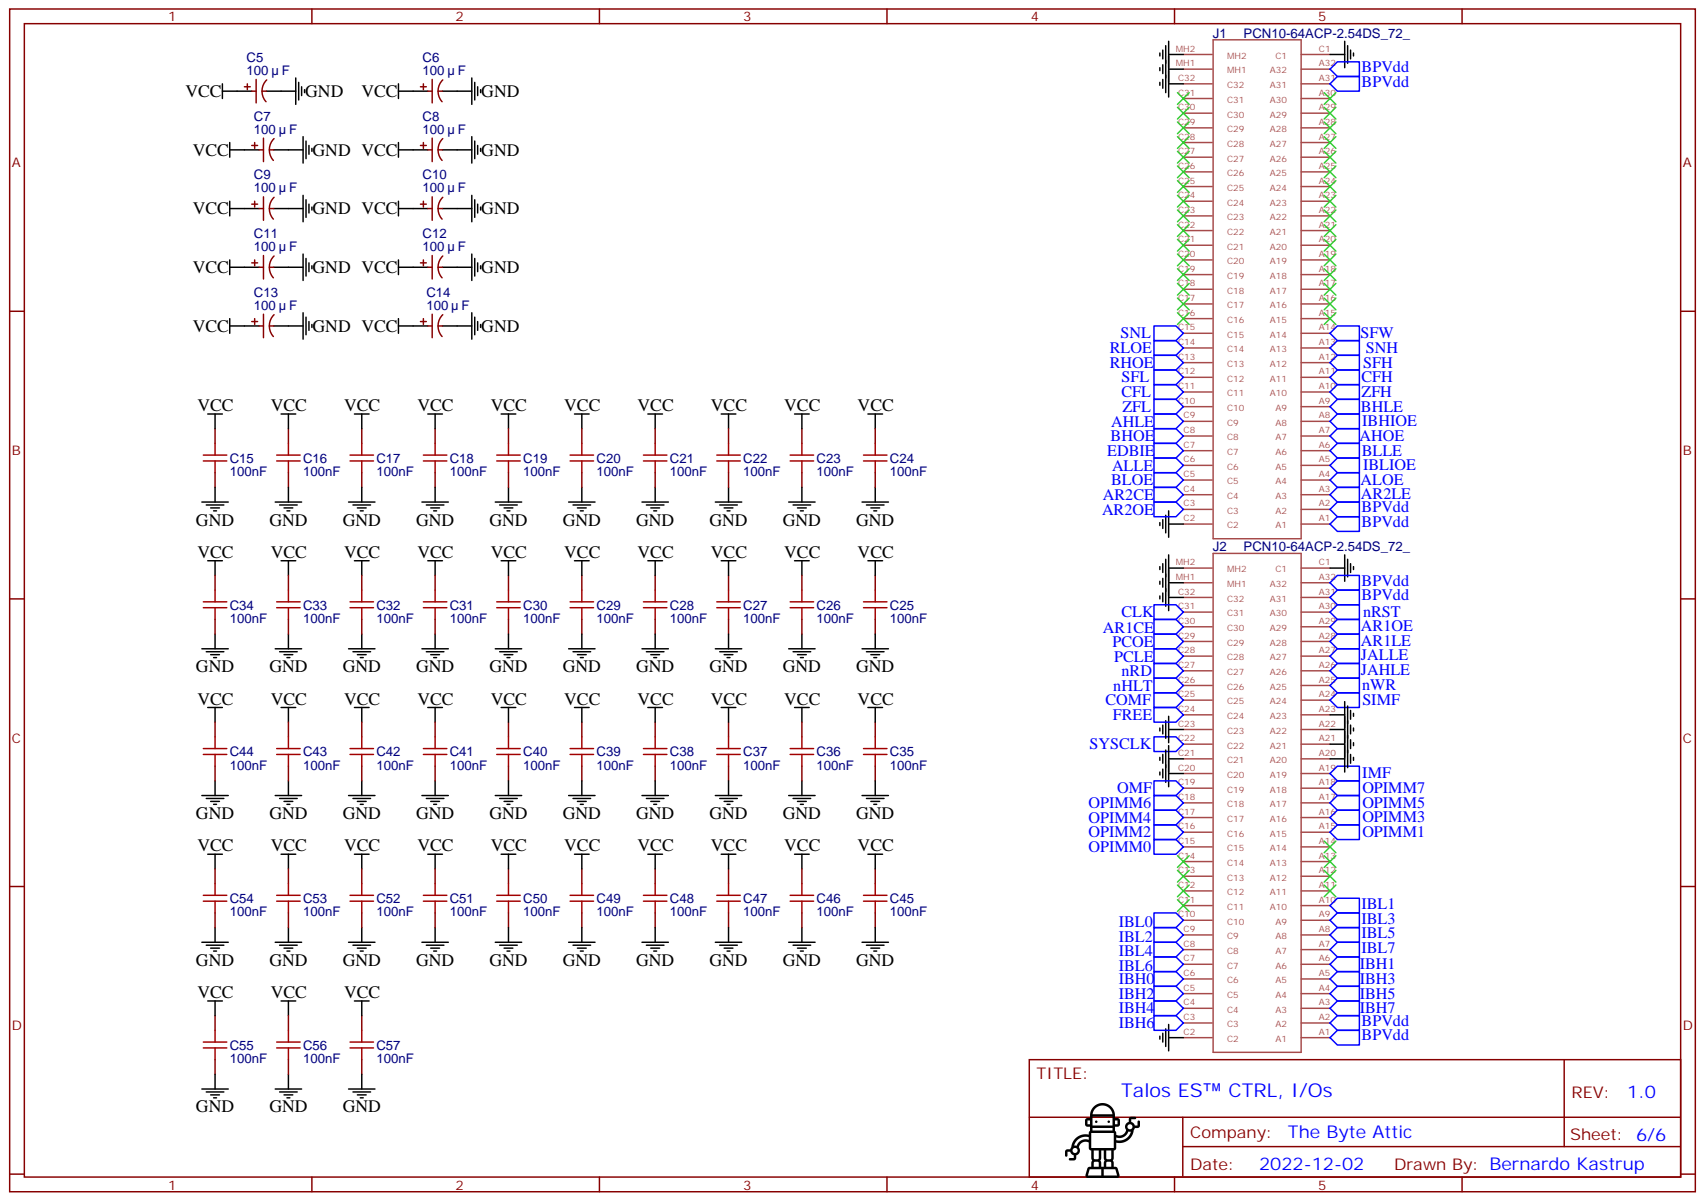
[picture p122: page 6]
