TheByteAttic/TalosES/AL card/Schematics Talos ES™ AL.pdf

A | A

# 4116R-1-102LF

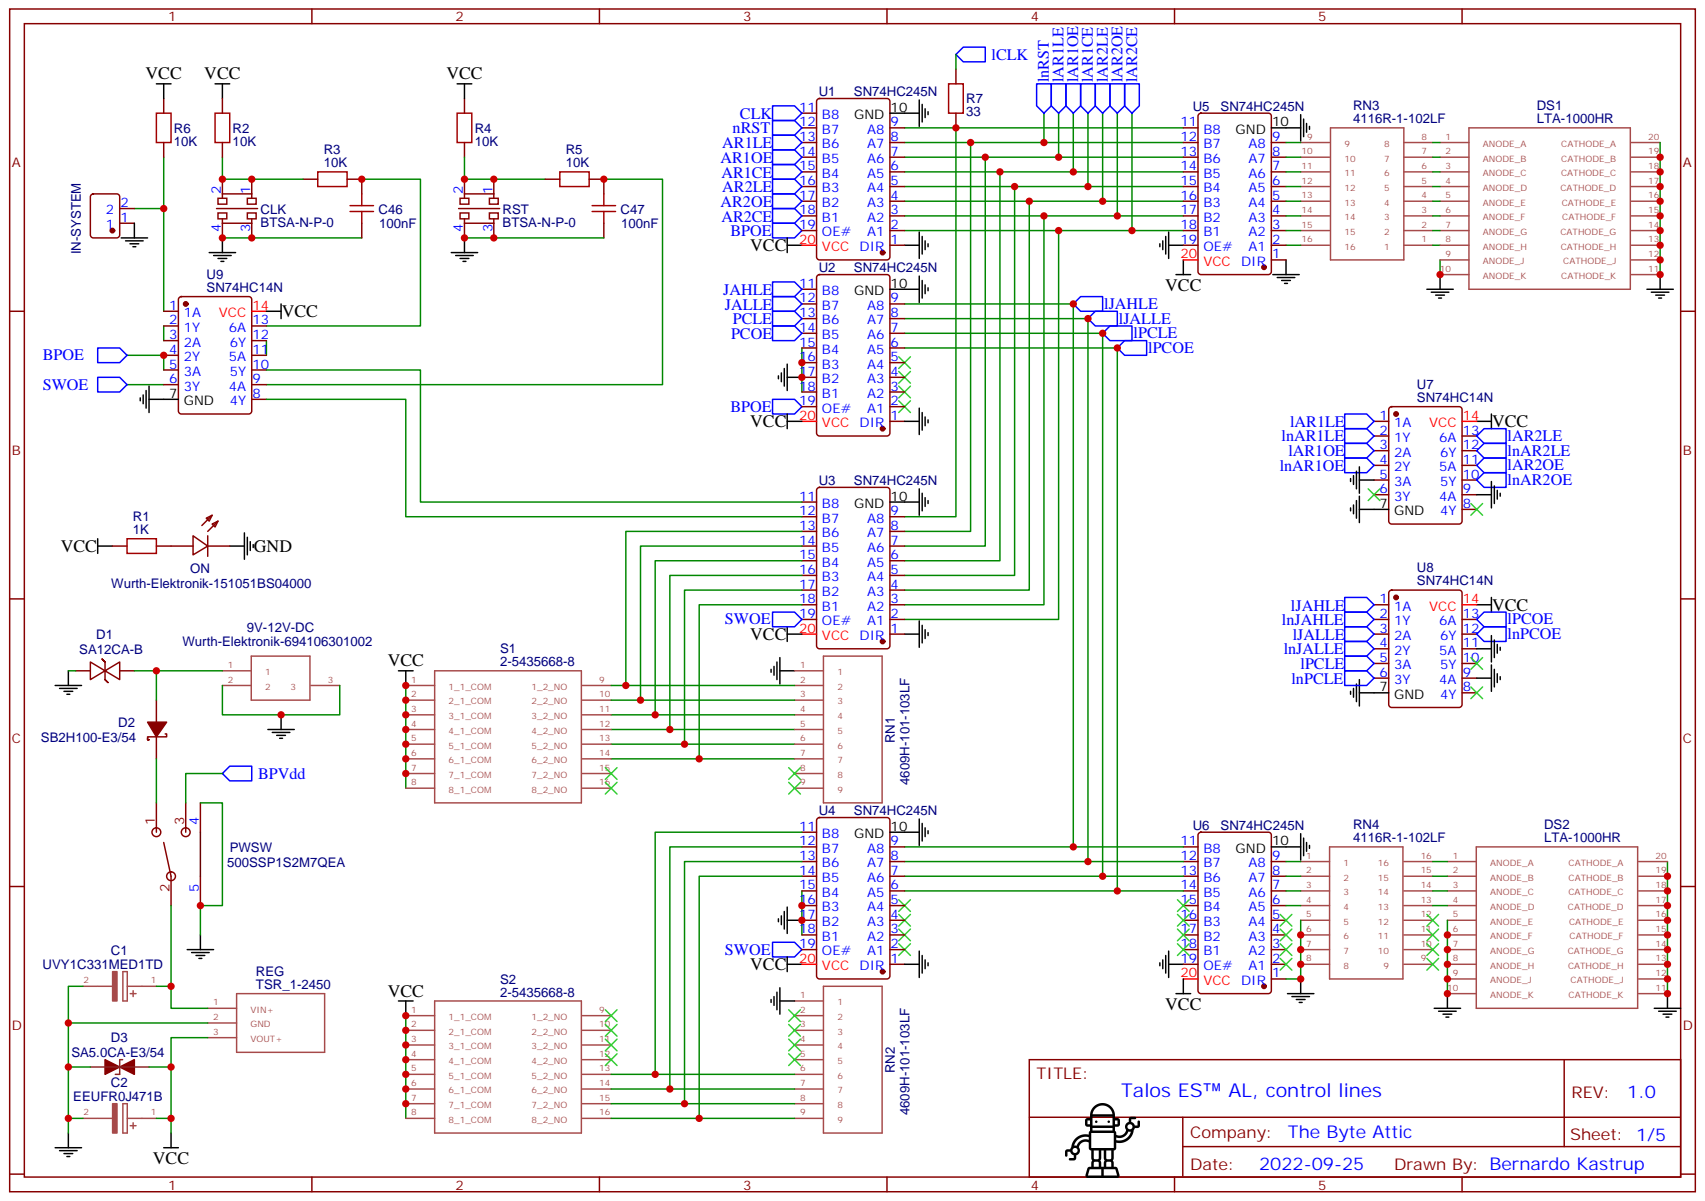
[picture p123: page 1]

7 2 | 19
6 3 | 18
5 4 | 17
4 5 | 16
3 6 | 15
2 7 | 14
1 8 | 13
9 | 12
10 | 11

2 | 10 3
3 | 11 4
4 | 12 5
5 | 13 6
6 | 14 7

15 2 | 19
14 3 | 18
13 4 | 17
5 | 16

7 | 15 8

Company: The Byte Attic

Drawn By: Bernardo Kastrup

A | A
VCC | VCC | VCC | VCC SN⁷⁴HC¹⁶¹N U¹⁶ VCC 16 RCO ¹⁵ QA 14 QB 13 QC 12 QD ¹¹ ENT 10 LOAD#

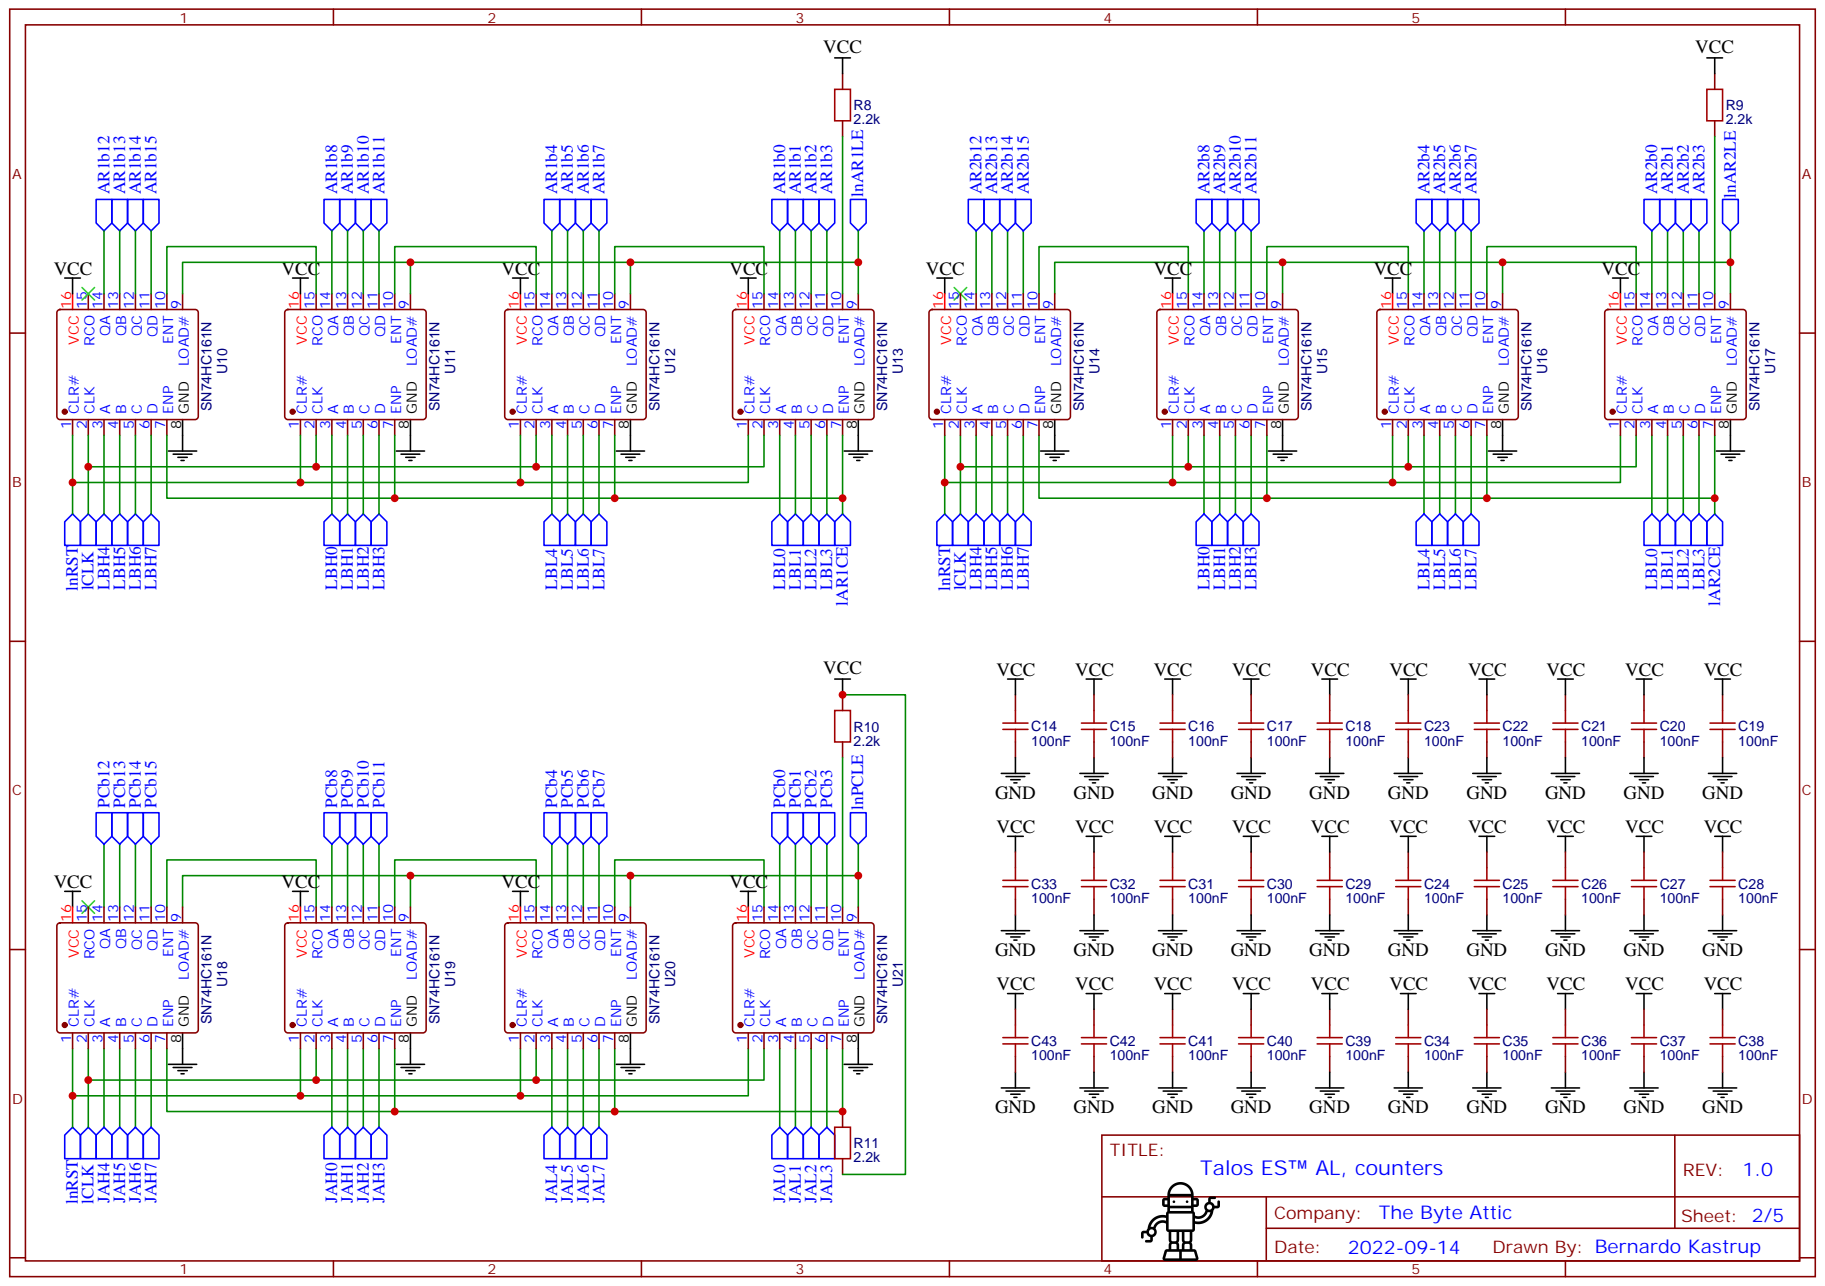
[picture p124: page 2]

A | A

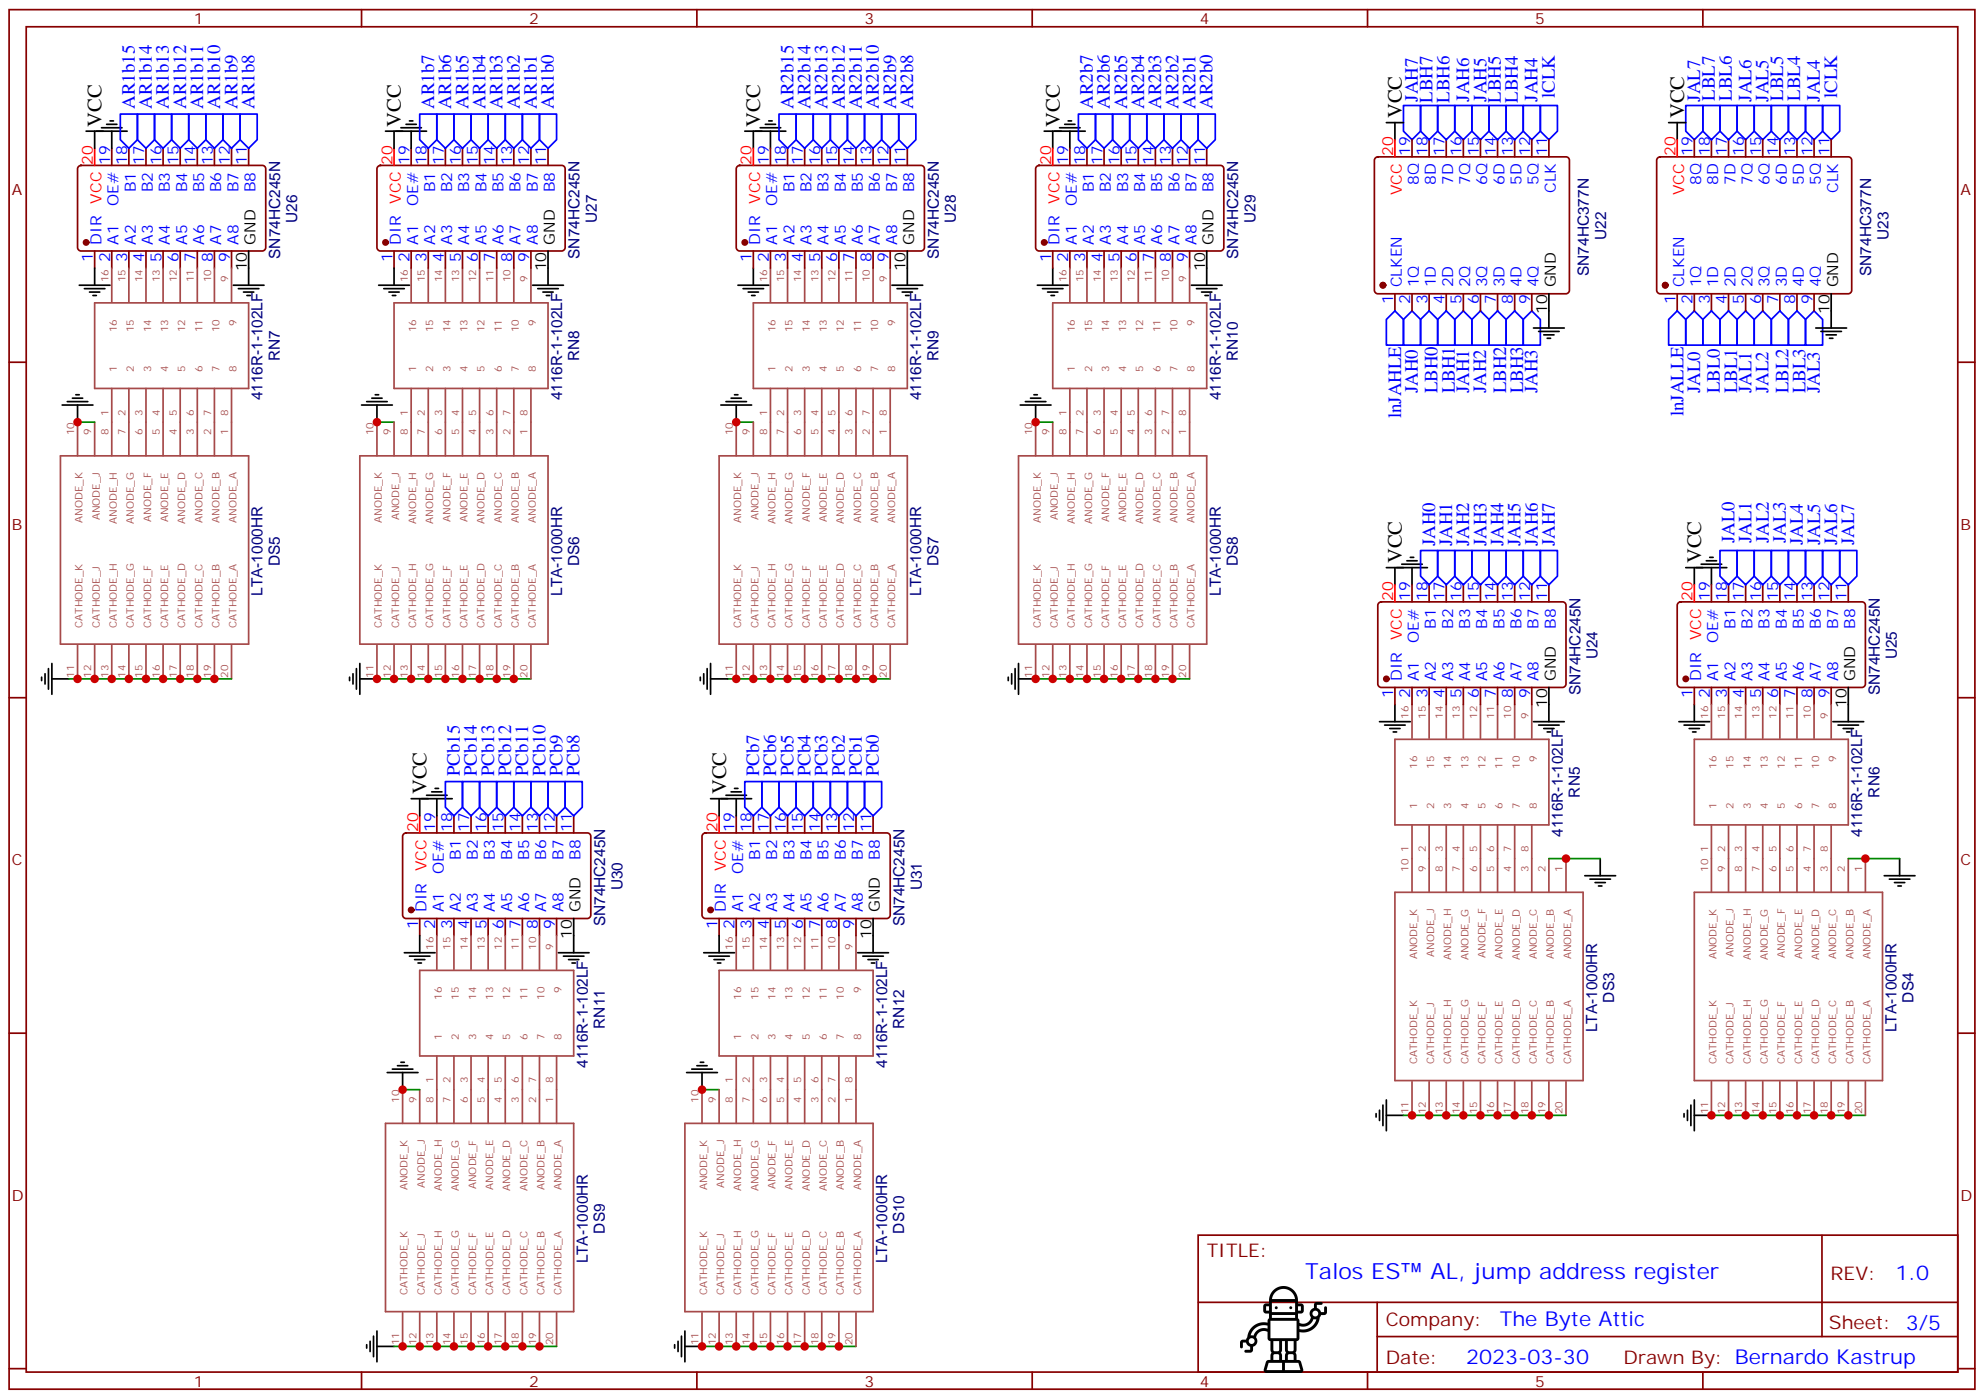
[picture p125: page 3]

GND 10 B8 11 B7 12 B6 13 B5 14 B4 15 B3 16 B2 17 B1 18 OE# 19 VCC 20 JAH7 JAH6 JAH5 JAH4 JAH0 JAH1 JAH2 JAH3 lCLK VCC

GND 10 B8 11 B7 12 B6 13 B5 14 B4 15 B3 16 B2 17 B1 18 OE# 19 VCC 20 VCC LTA-1000HR

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

GND 10 B8 11 B7 12 B6 13 B5 14 B4 15 B3 16 B2 17 B1 18 OE# 19 VCC 20 LTA-1000HR

Company: The Byte Attic ⁴¹¹⁶R⁻¹⁻¹⁰²LF RN⁵

A

A

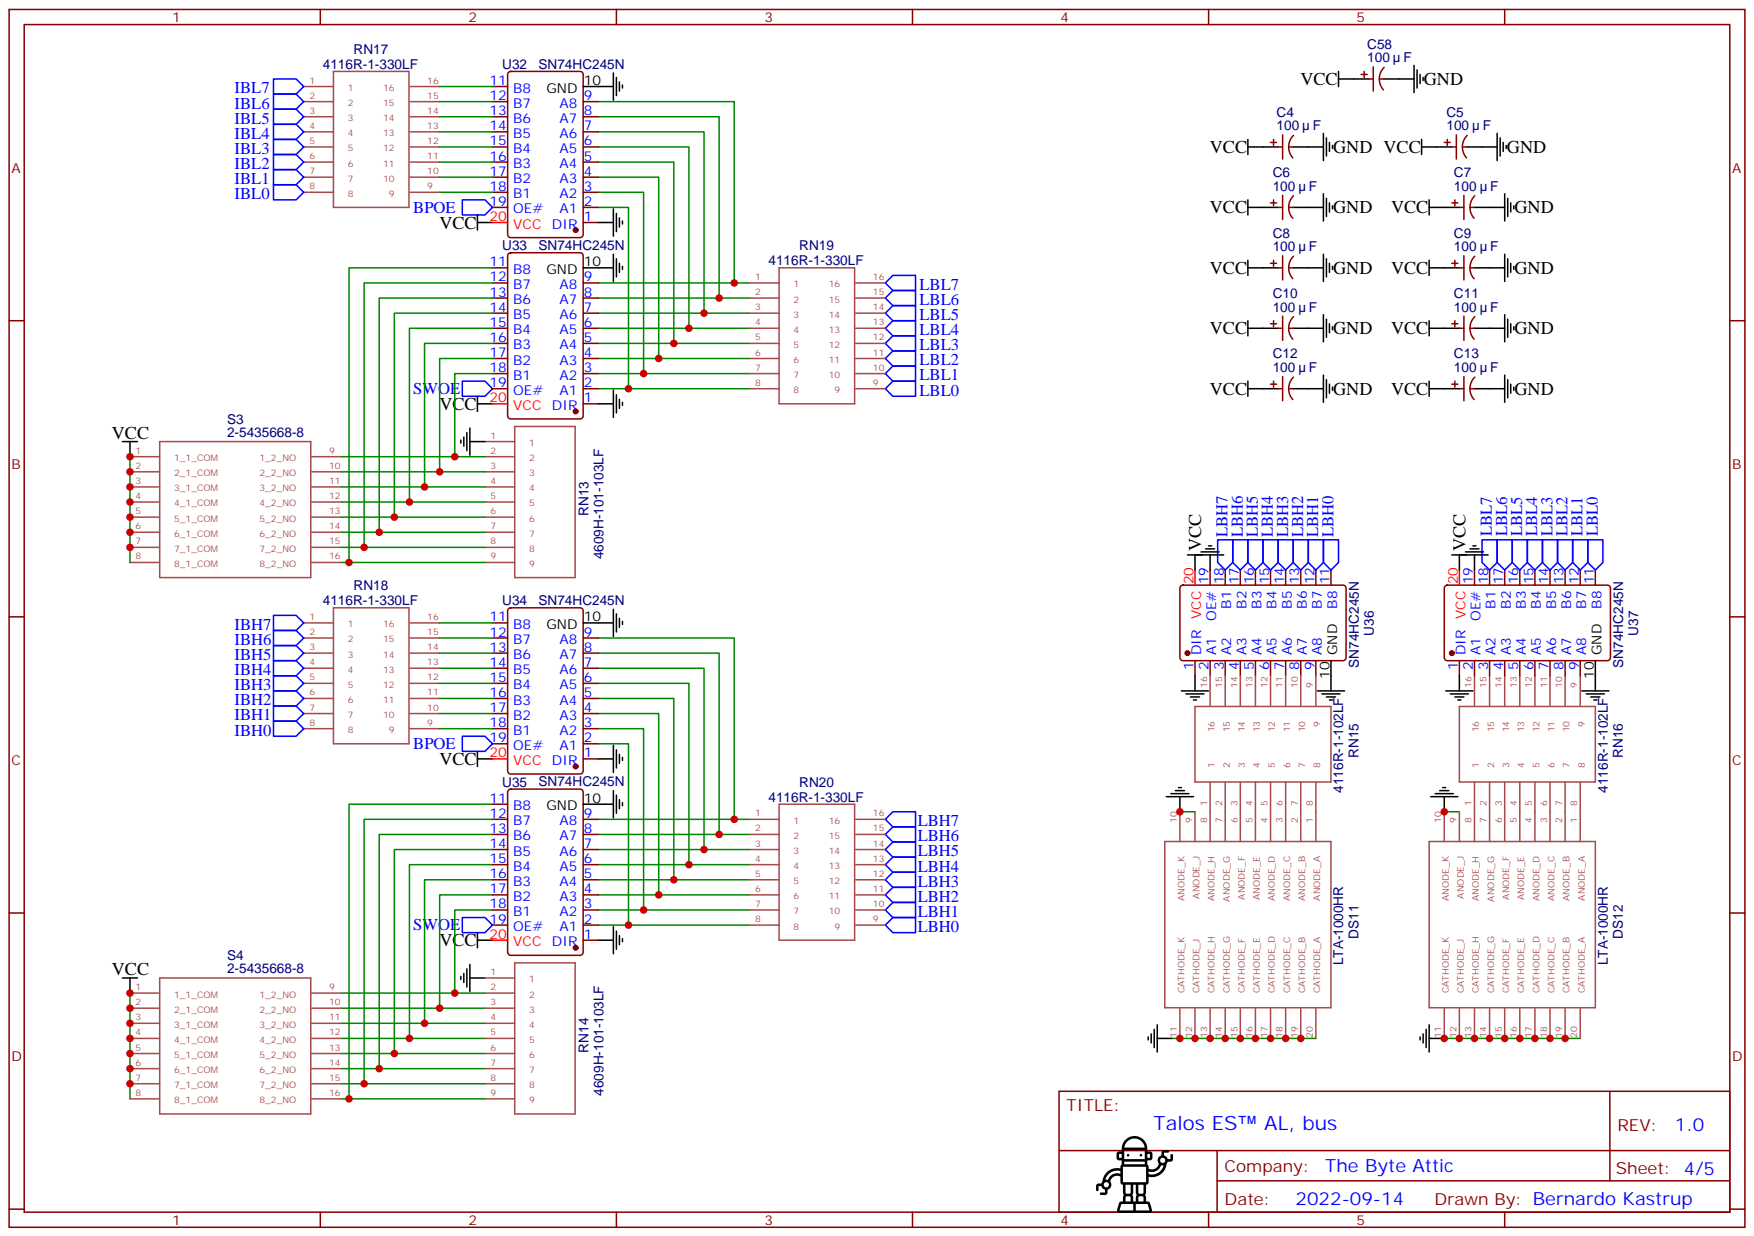
[picture p126: page 4]

2 | 10 3
3 | 11 4
4 | 12 5
5 | 13 6
6 | 14 7
7 | 15 8
8 | 16 9

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

A | A

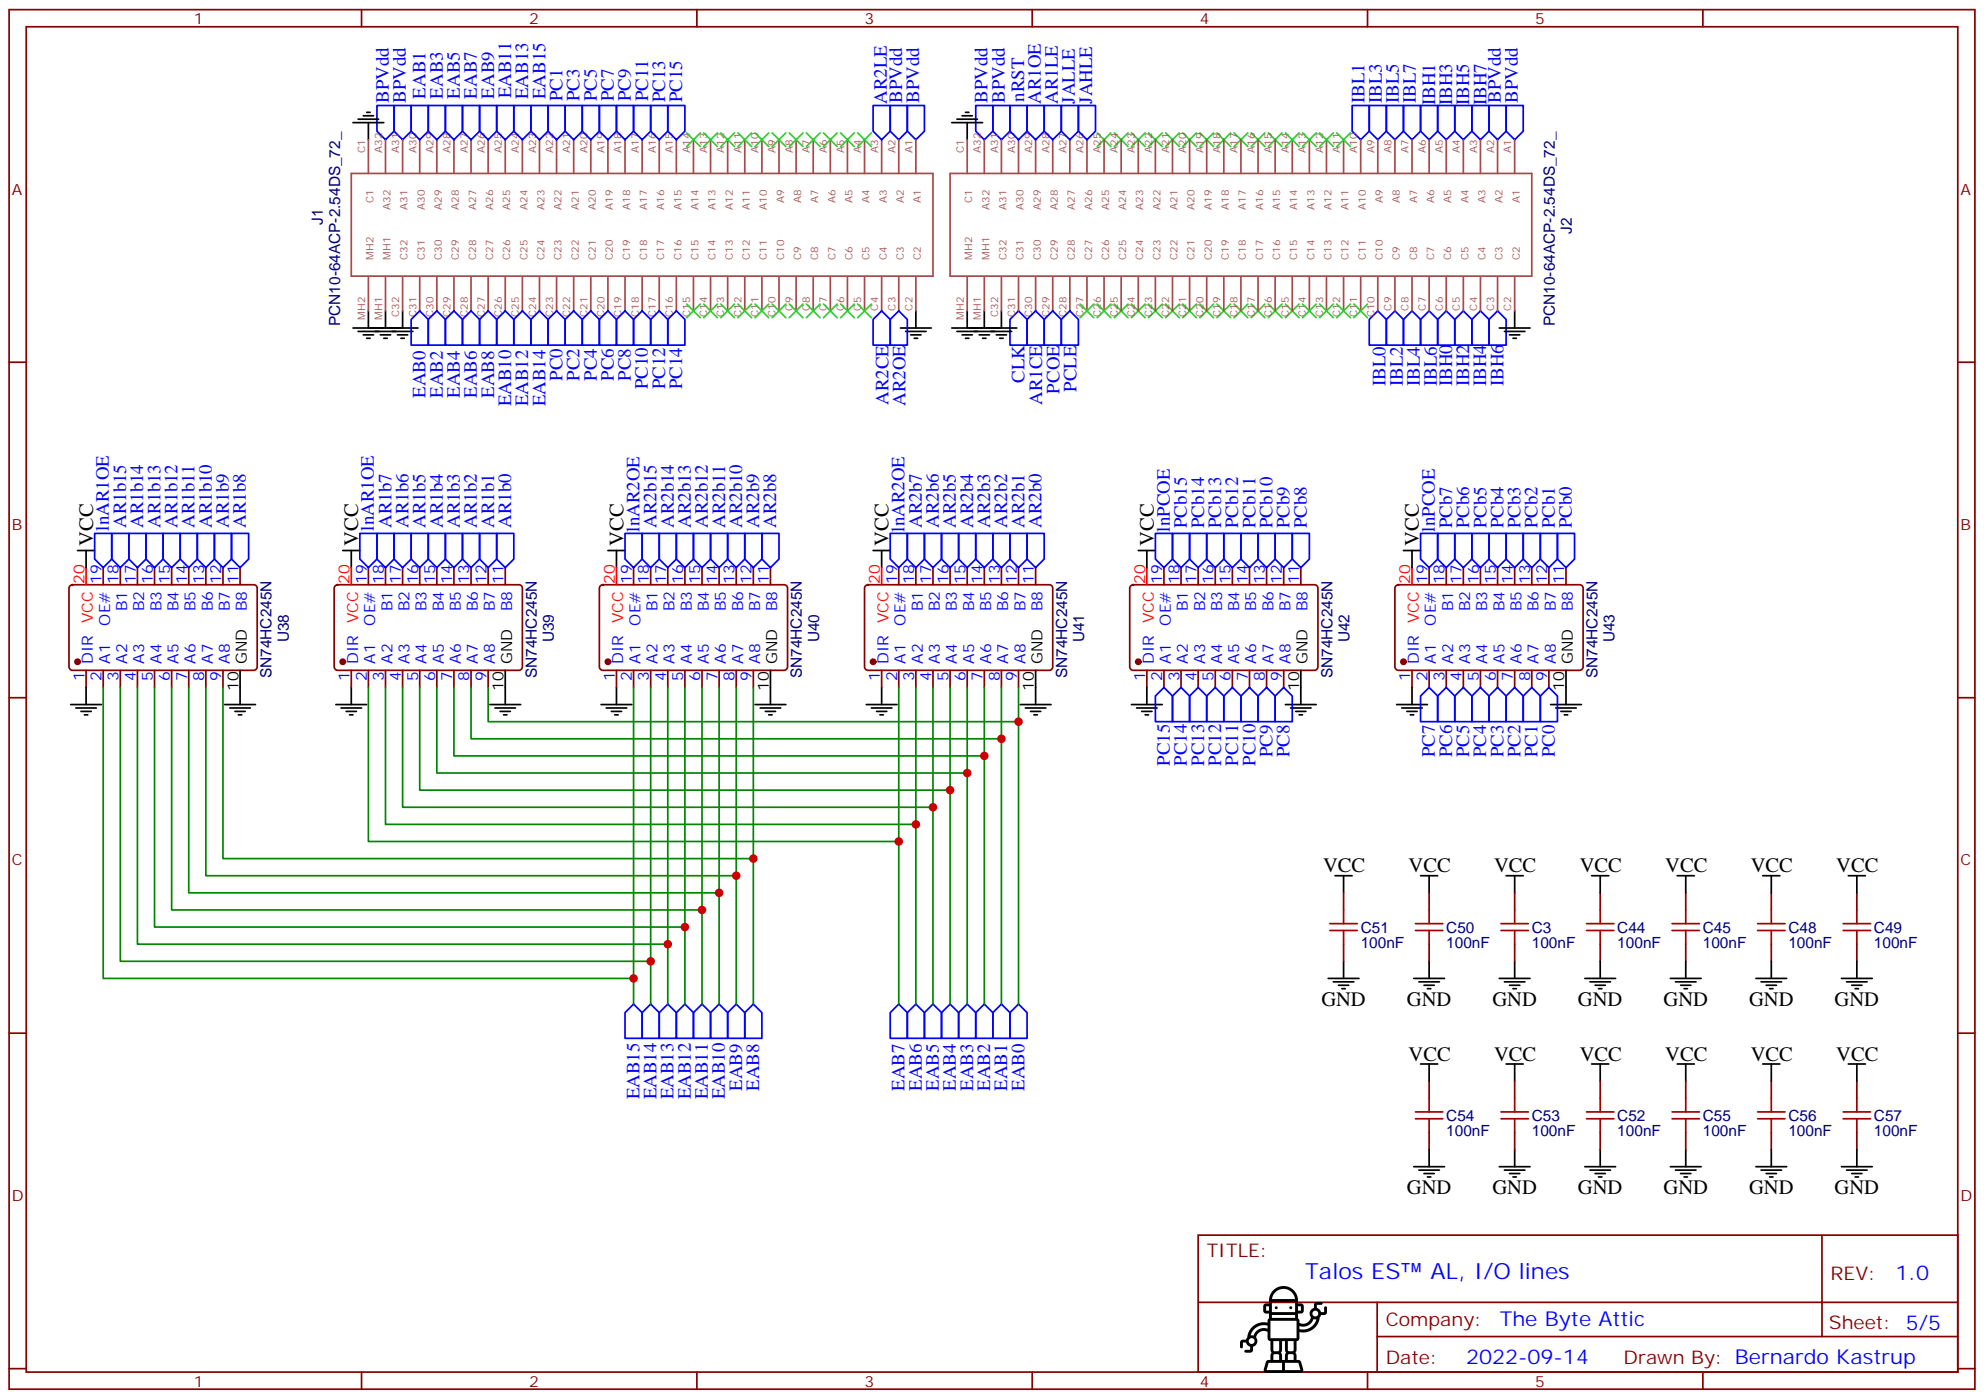
[picture p127: page 5]
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
