TheByteAttic/TalosES/RF card/Schematics Talos ES™ RF.pdf

A | A

## SN74HC14N

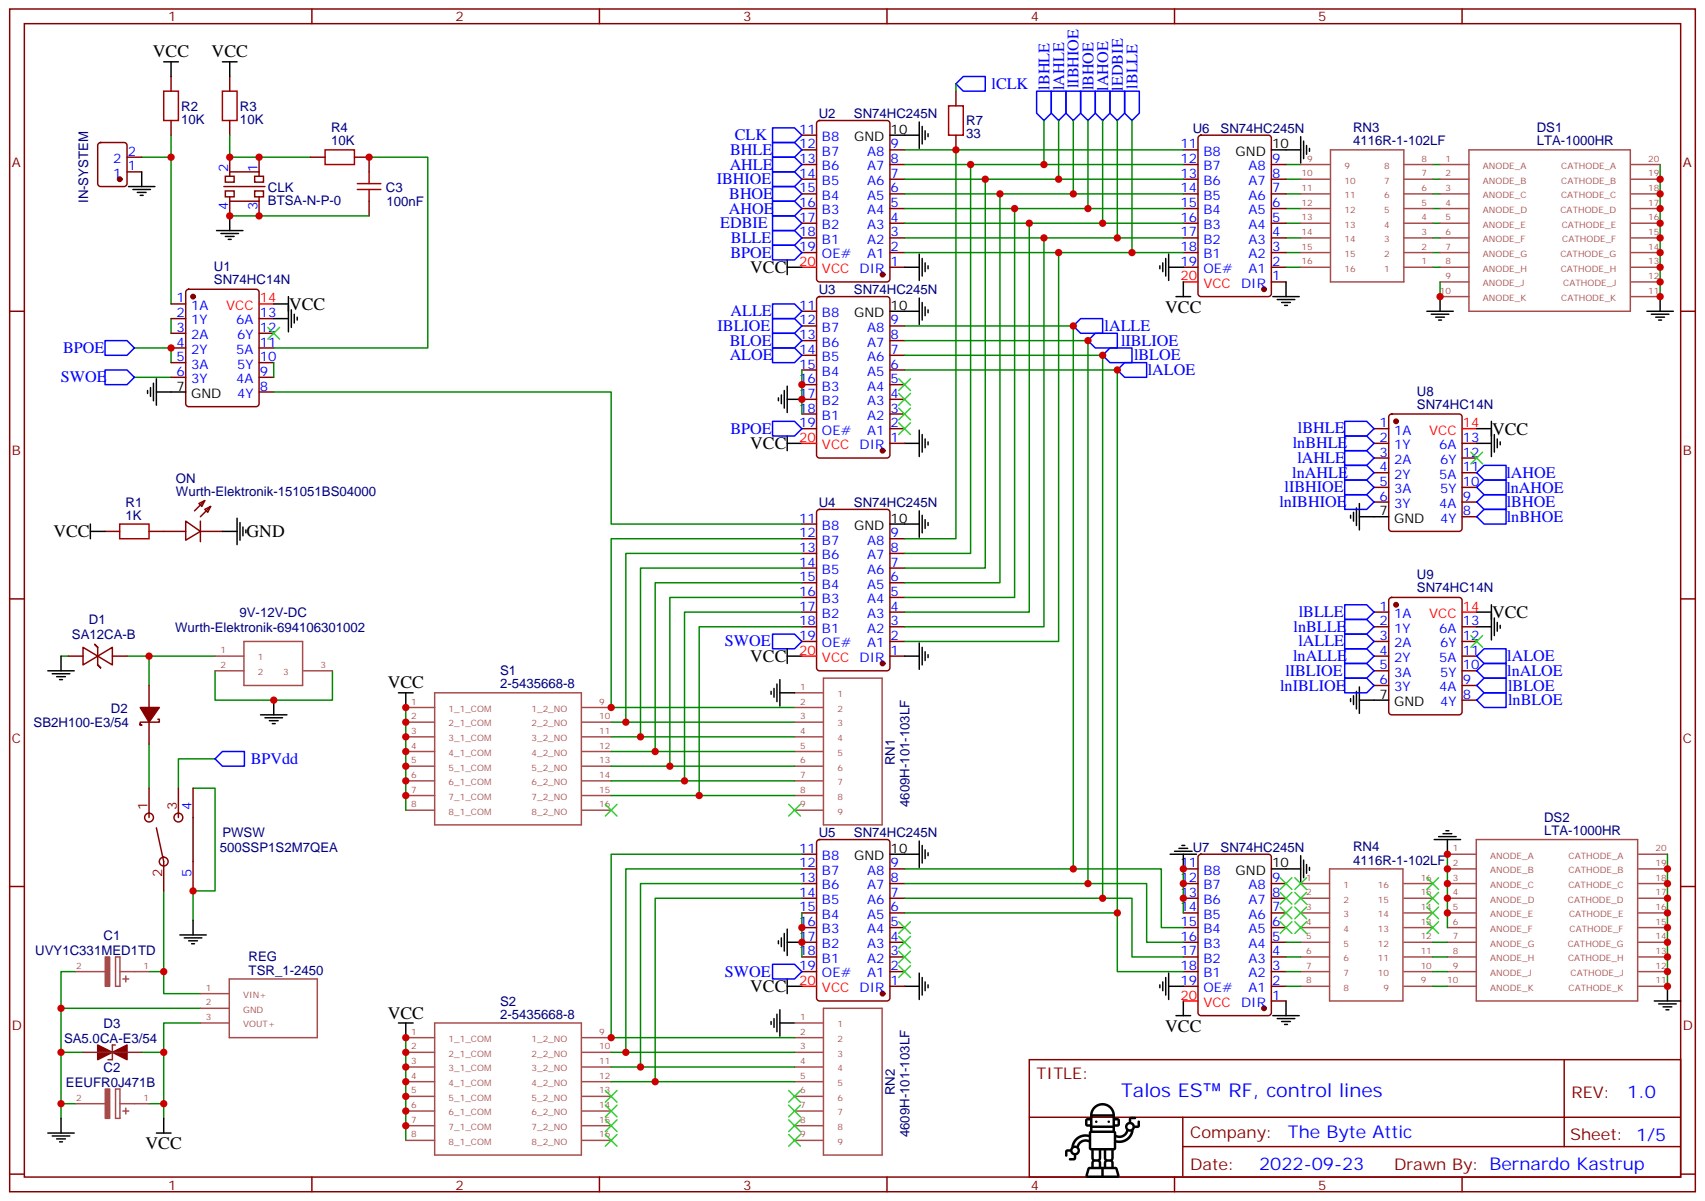
[picture p128: page 1]

7 2 | 19
6 3 | 18
5 4 | 17
4 5 | 16
3 6 | 15
2 7 | 14
1 8 | 13
9 | 12
10 | 11

3 | 11 4
4 | 12 5
5 | 13 6
6 | 14 7
7 | 15 8

11 8 | 13
10 9 | 12
9 10 | 11

Company: The Byte Attic

Drawn By: Bernardo Kastrup

A | A

# VCC

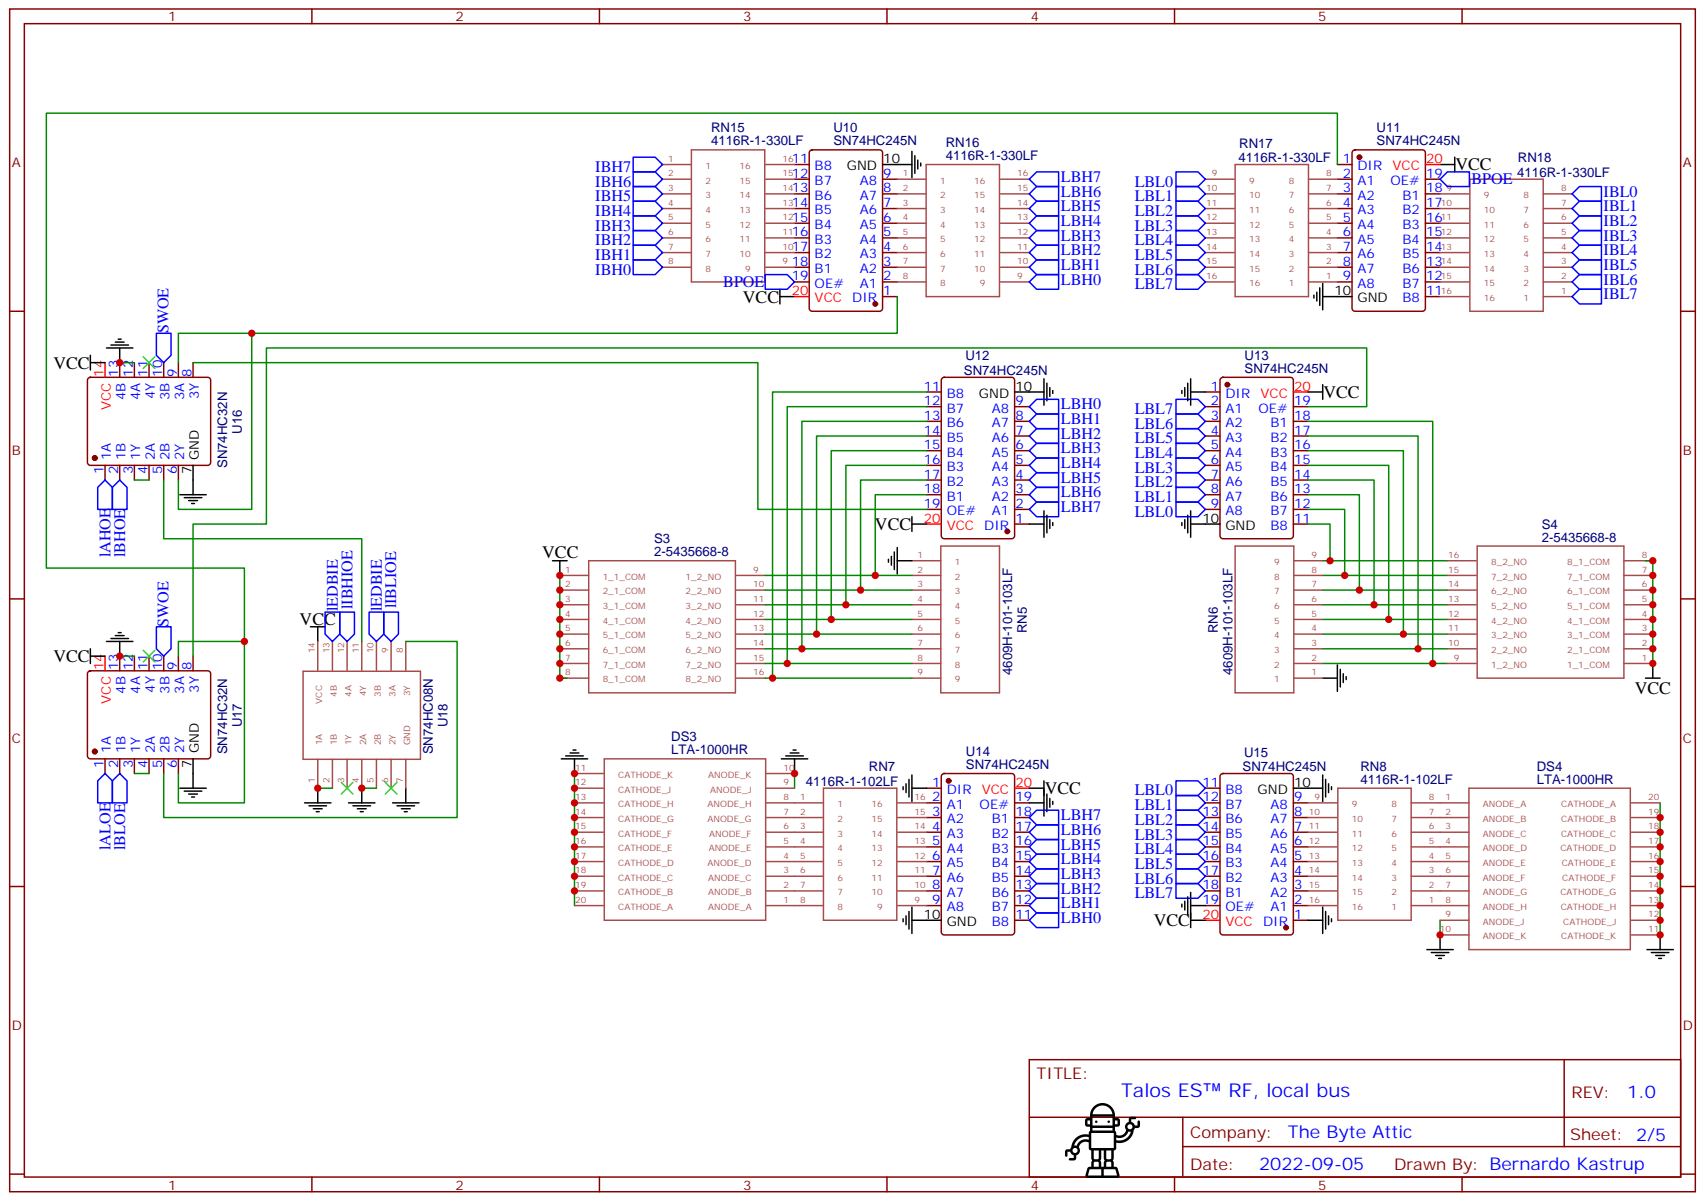
[picture p129: page 2]

9 | 12
10 | 11

A | A

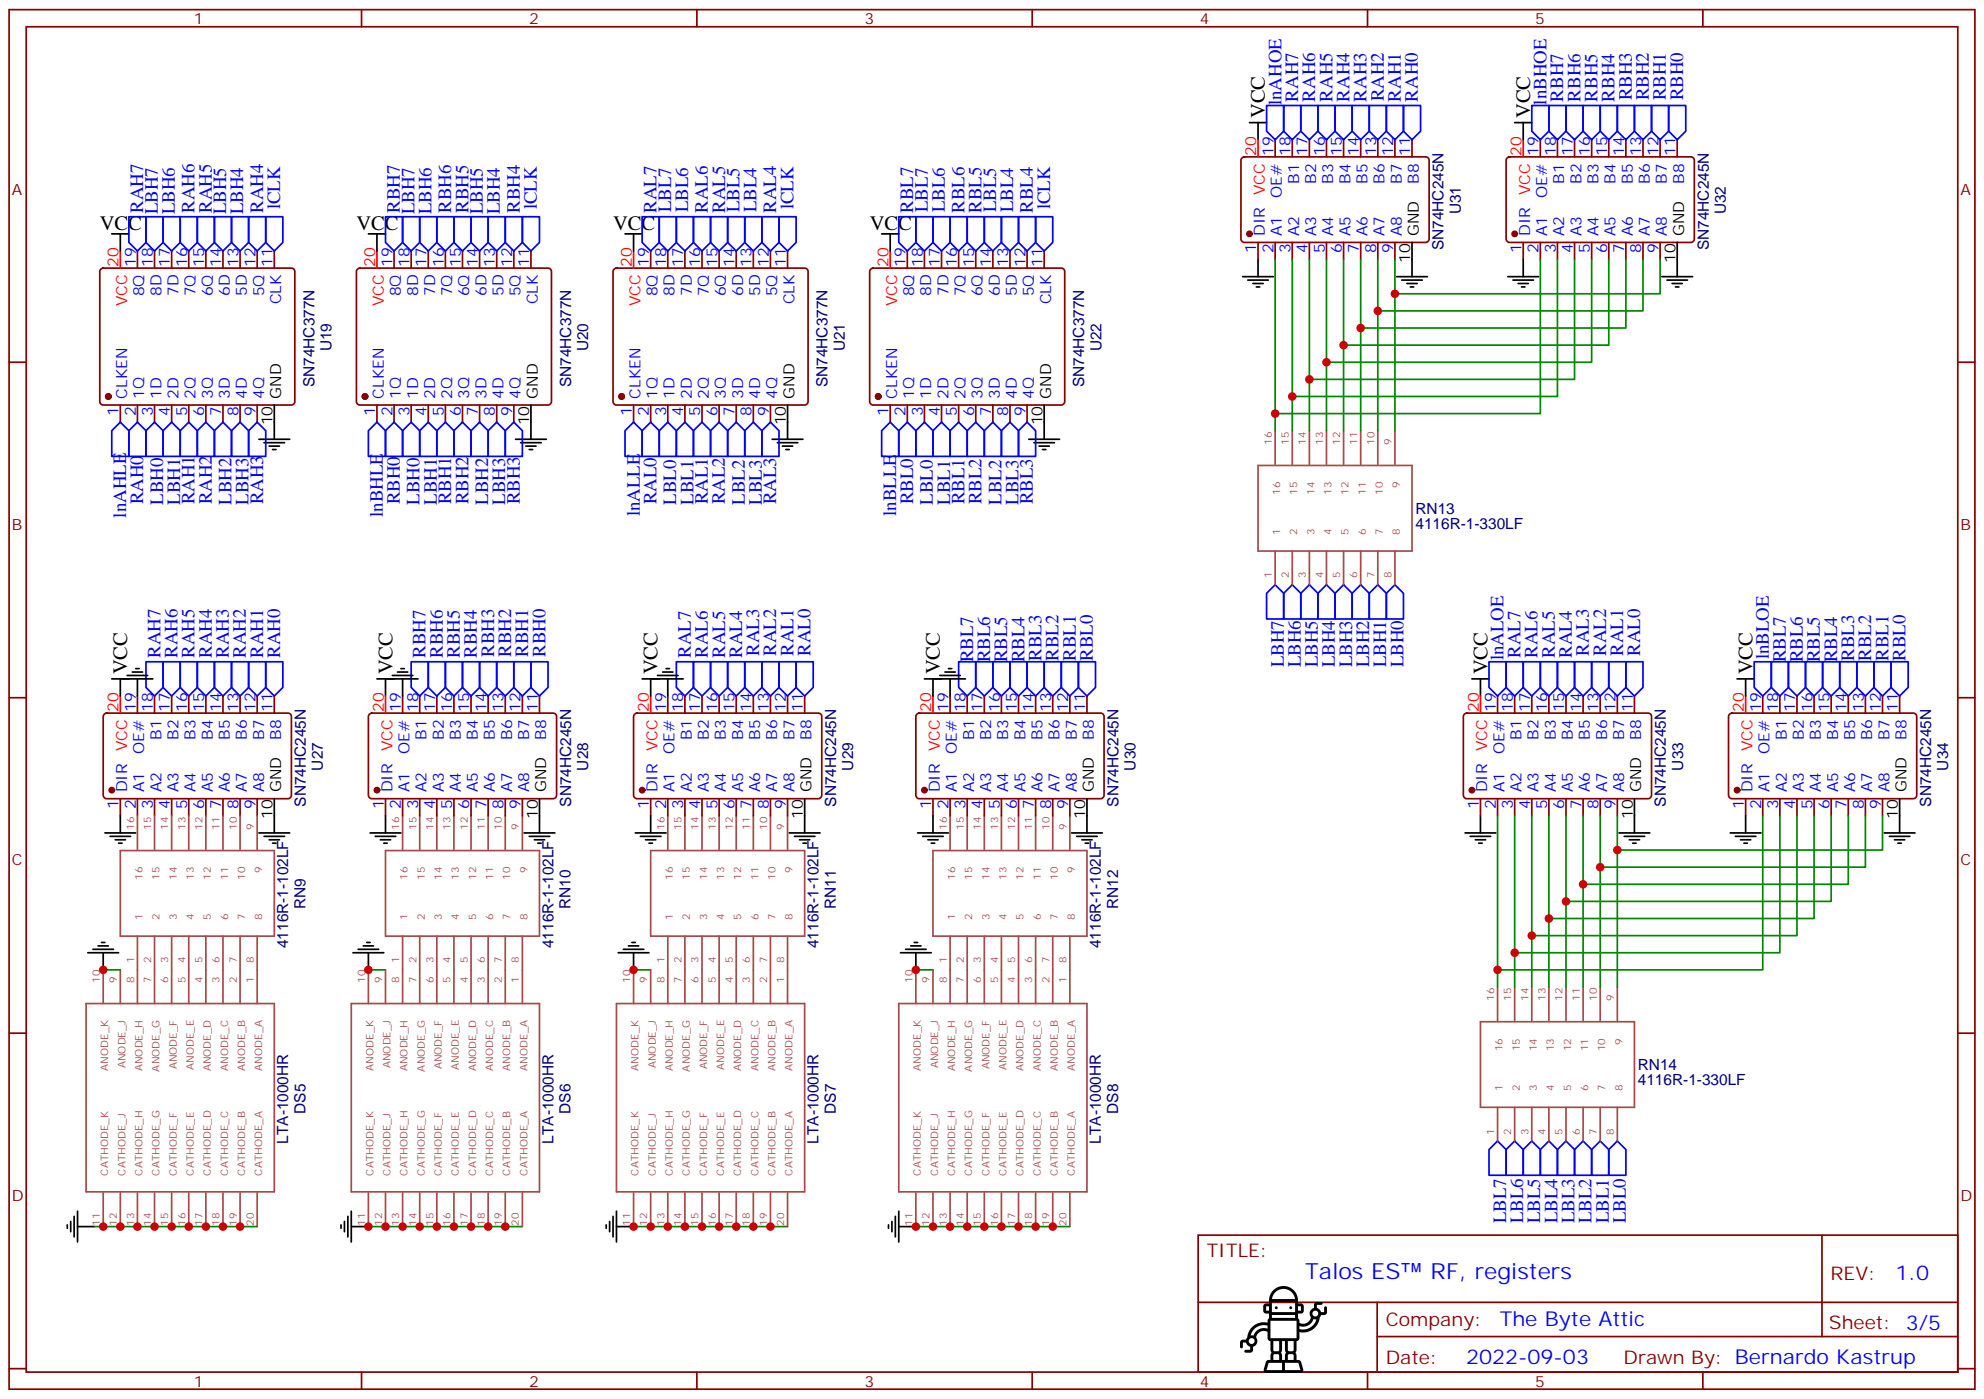
[picture p130: page 3]

GND 10 B8 11 B7 12 B6 13 B5 14 B4 15 B3 16 B2 17 B1 18 OE# 19 VCC 20 VCC

GND 10 B8 11 B7 12 B6 13 B5 14 B4 15 B3 16 B2 17 B1 18 OE# 19 VCC 20 VCC LTA-1000HR

A | A

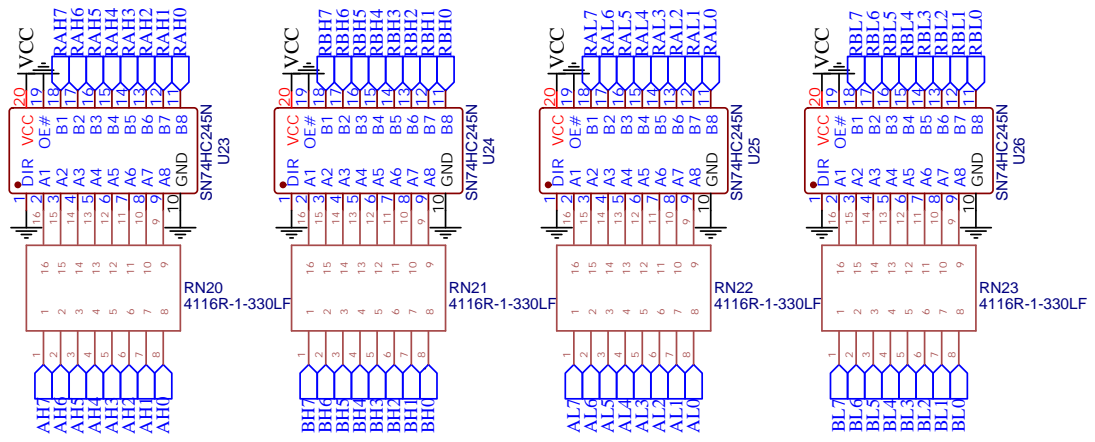
[picture p131: page 4]
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

A | A

## J1 PCN10-64ACP-2.54DS_72_

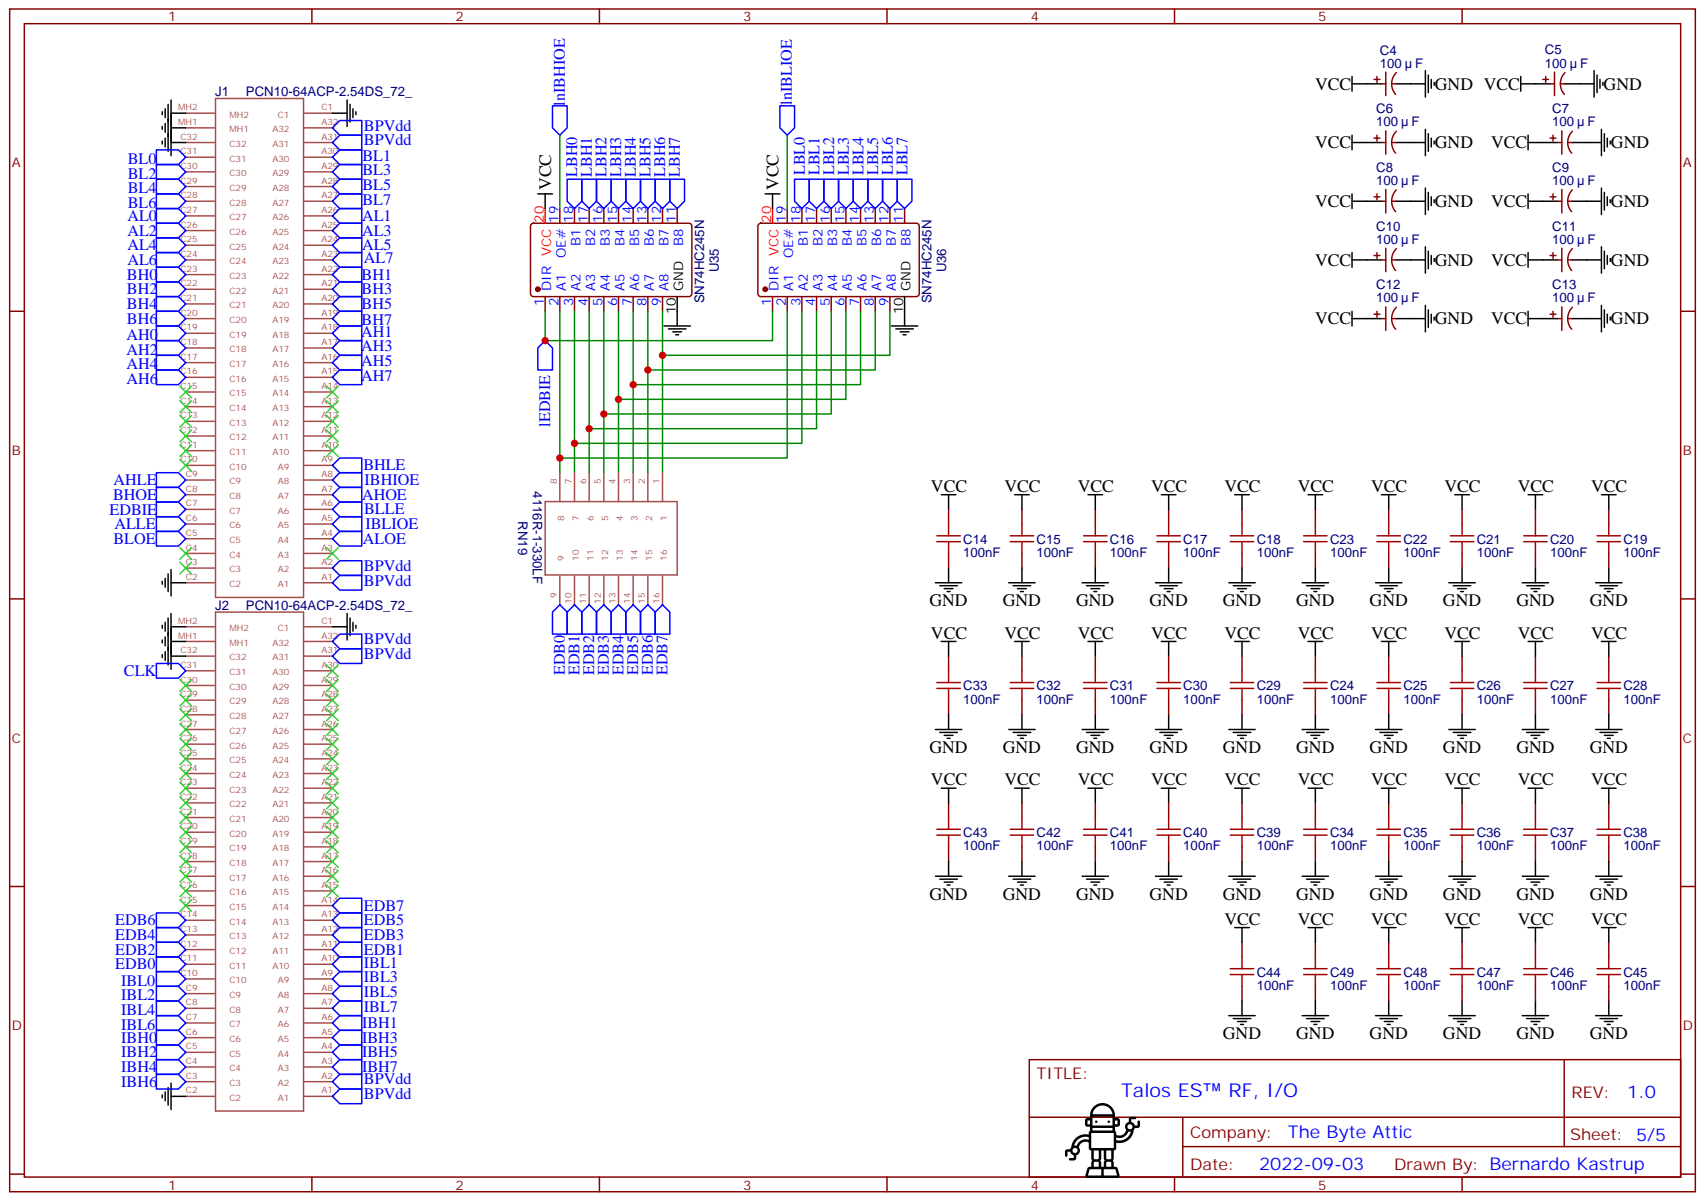
[picture p132: page 5]
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
