TheByteAttic/TalosES/ALU card/Schematics Talos ES™ ALU.pdf

A | A
BH6 | BH7

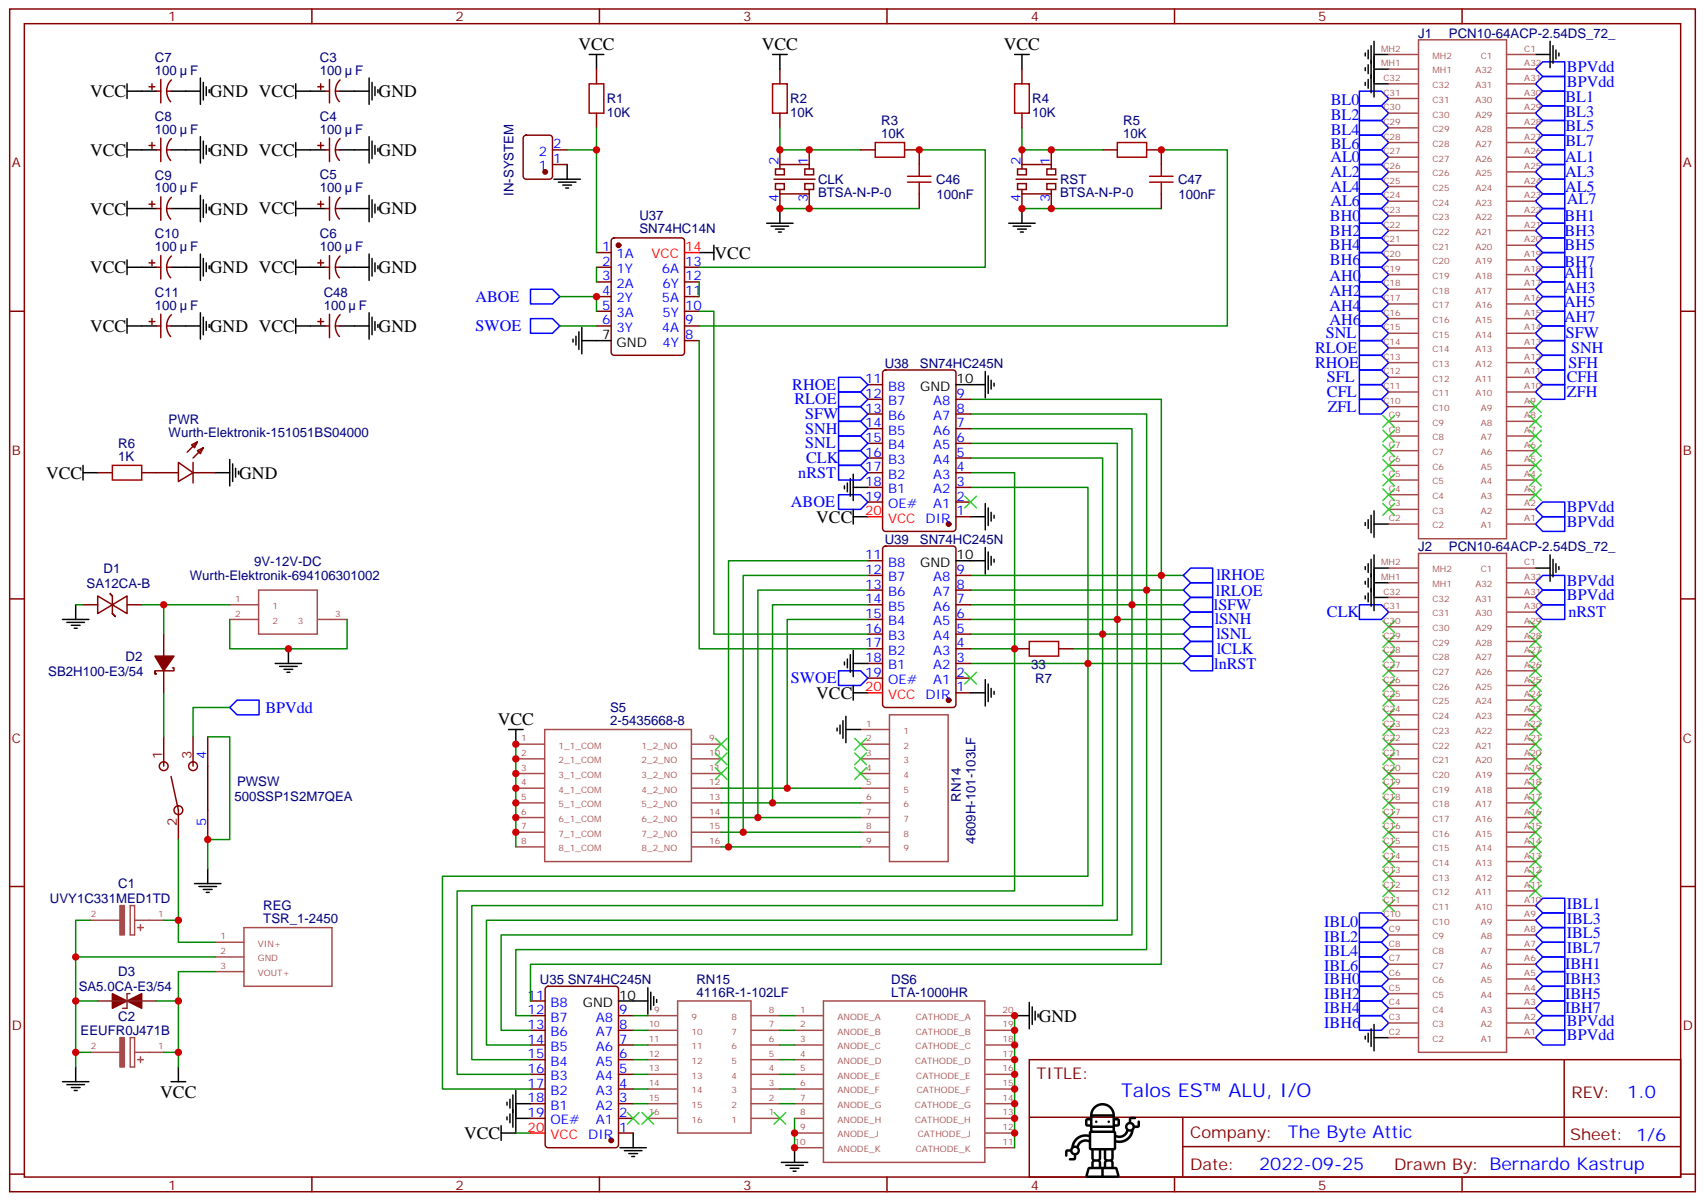
[picture p133: page 1]

5 | 13 6
6 | 14 7
7 | 15 8
8 | 16 9

7 2 | 19
6 3 | 18
5 4 | 17
4 5 | 16
3 6 | 15
2 7 | 14

Company: The Byte Attic

Drawn By: Bernardo Kastrup

A

A

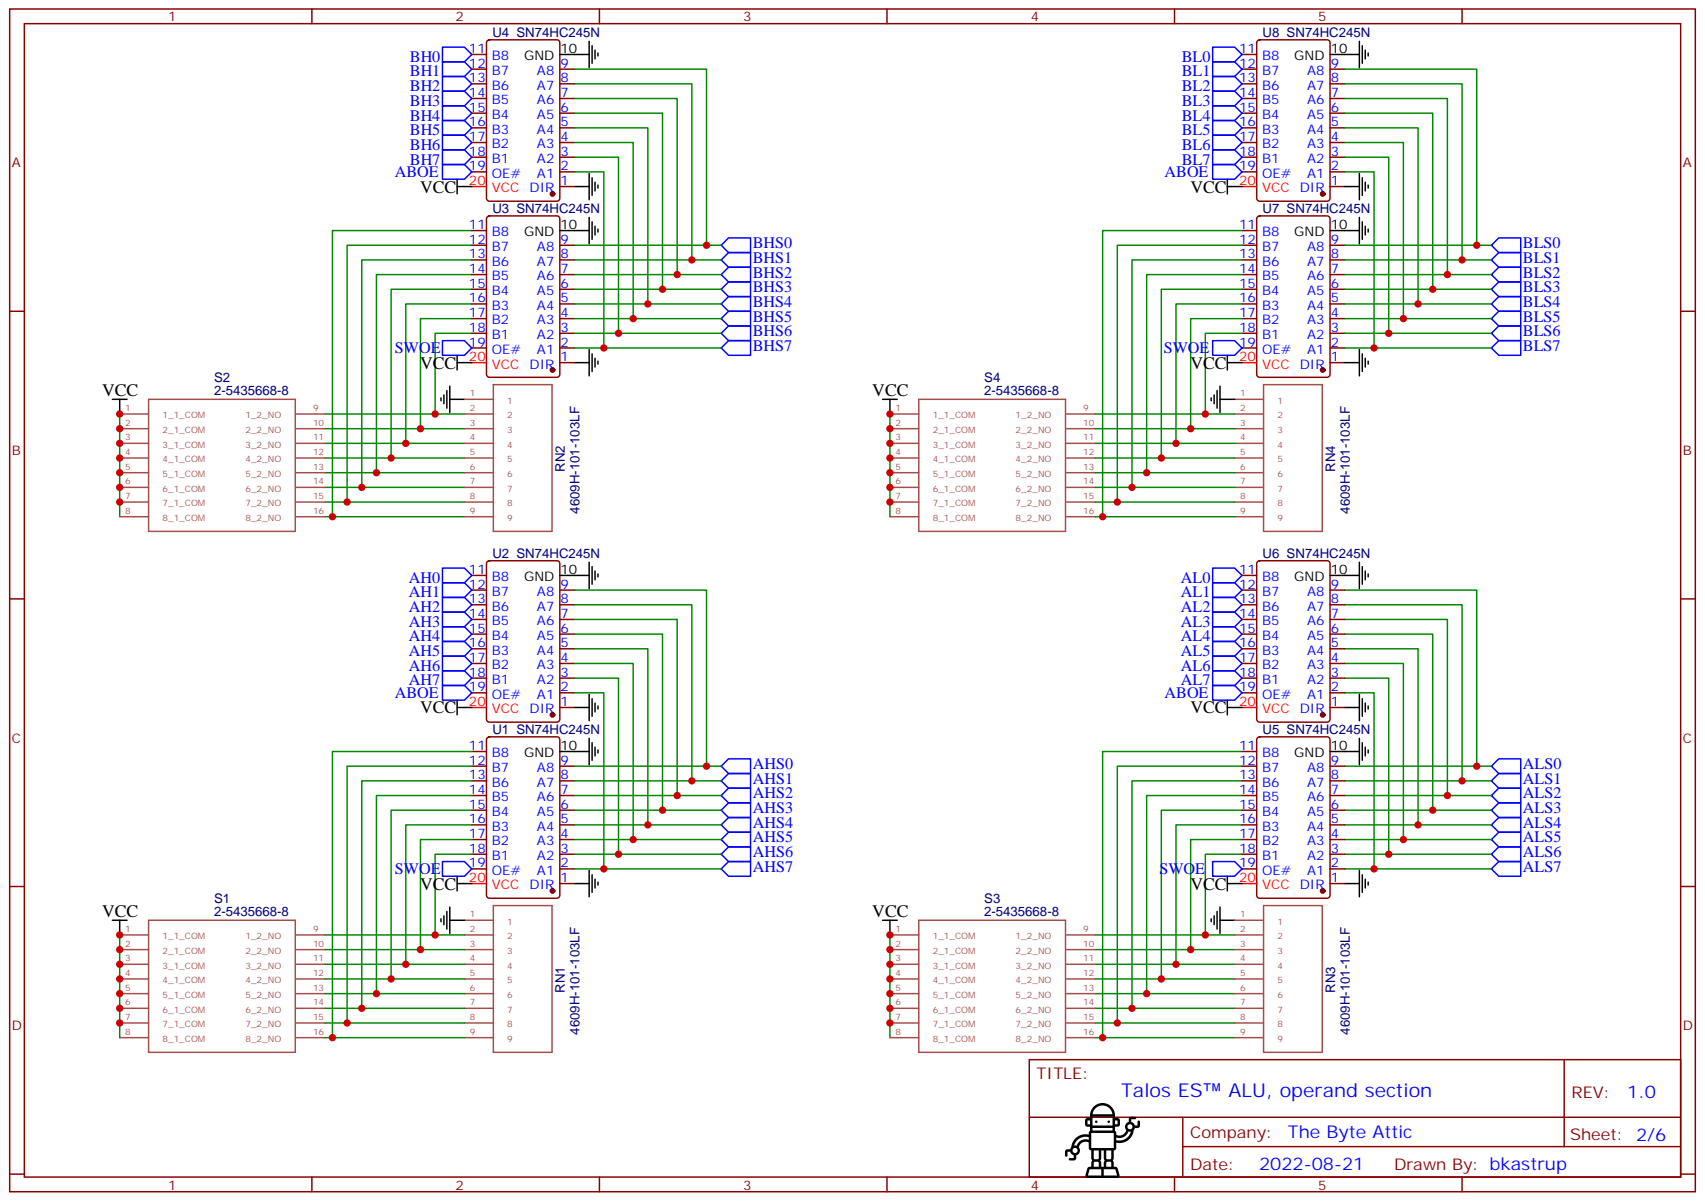
[picture p134: page 2]

A | A

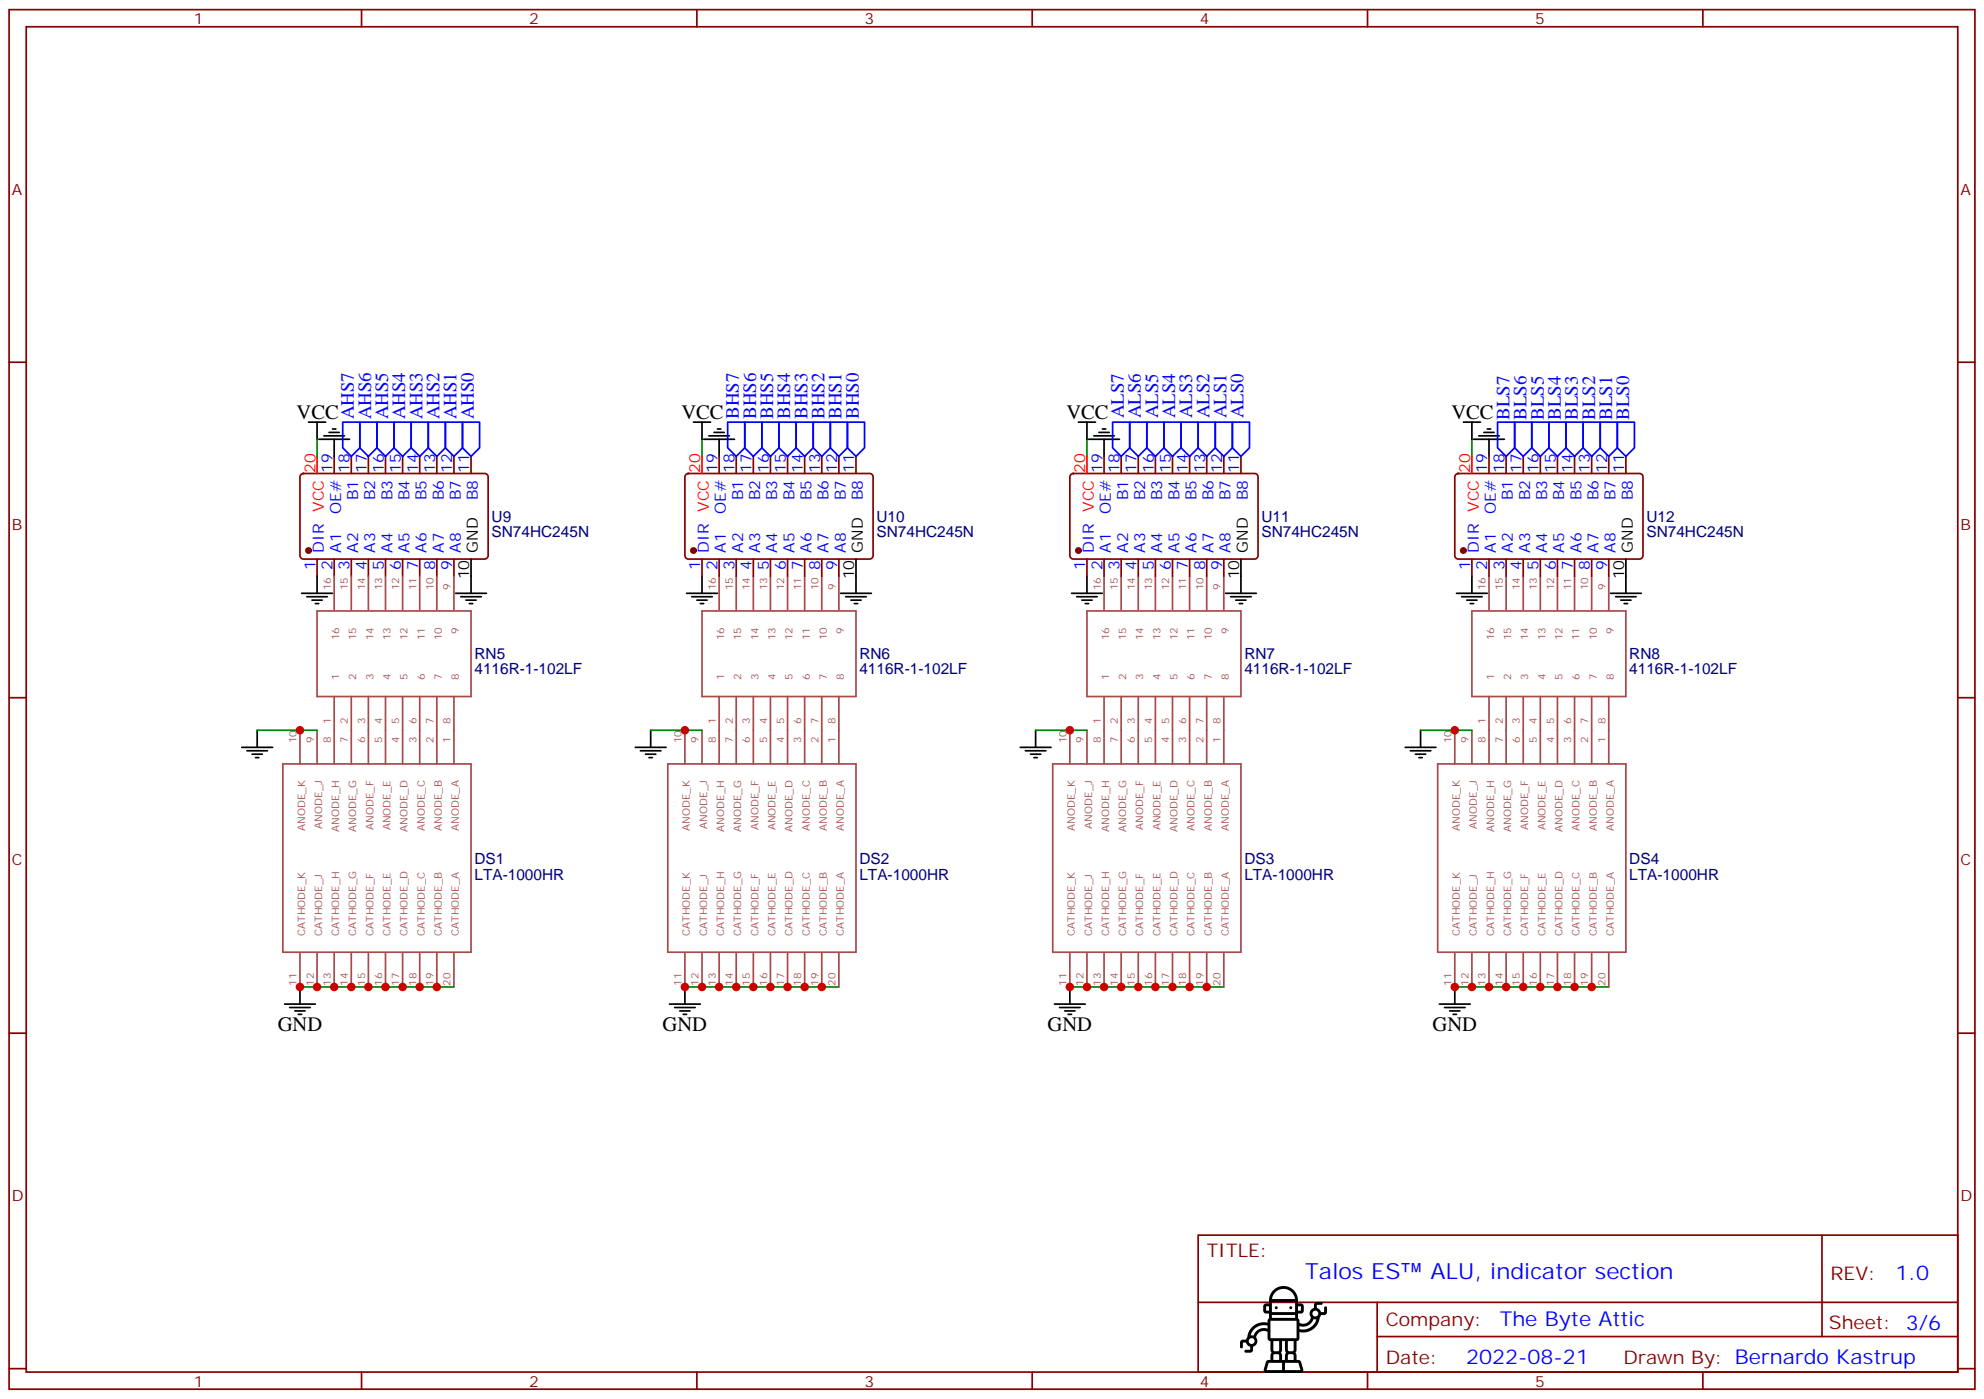
[picture p135: page 3]

A | A
VCC | VCC

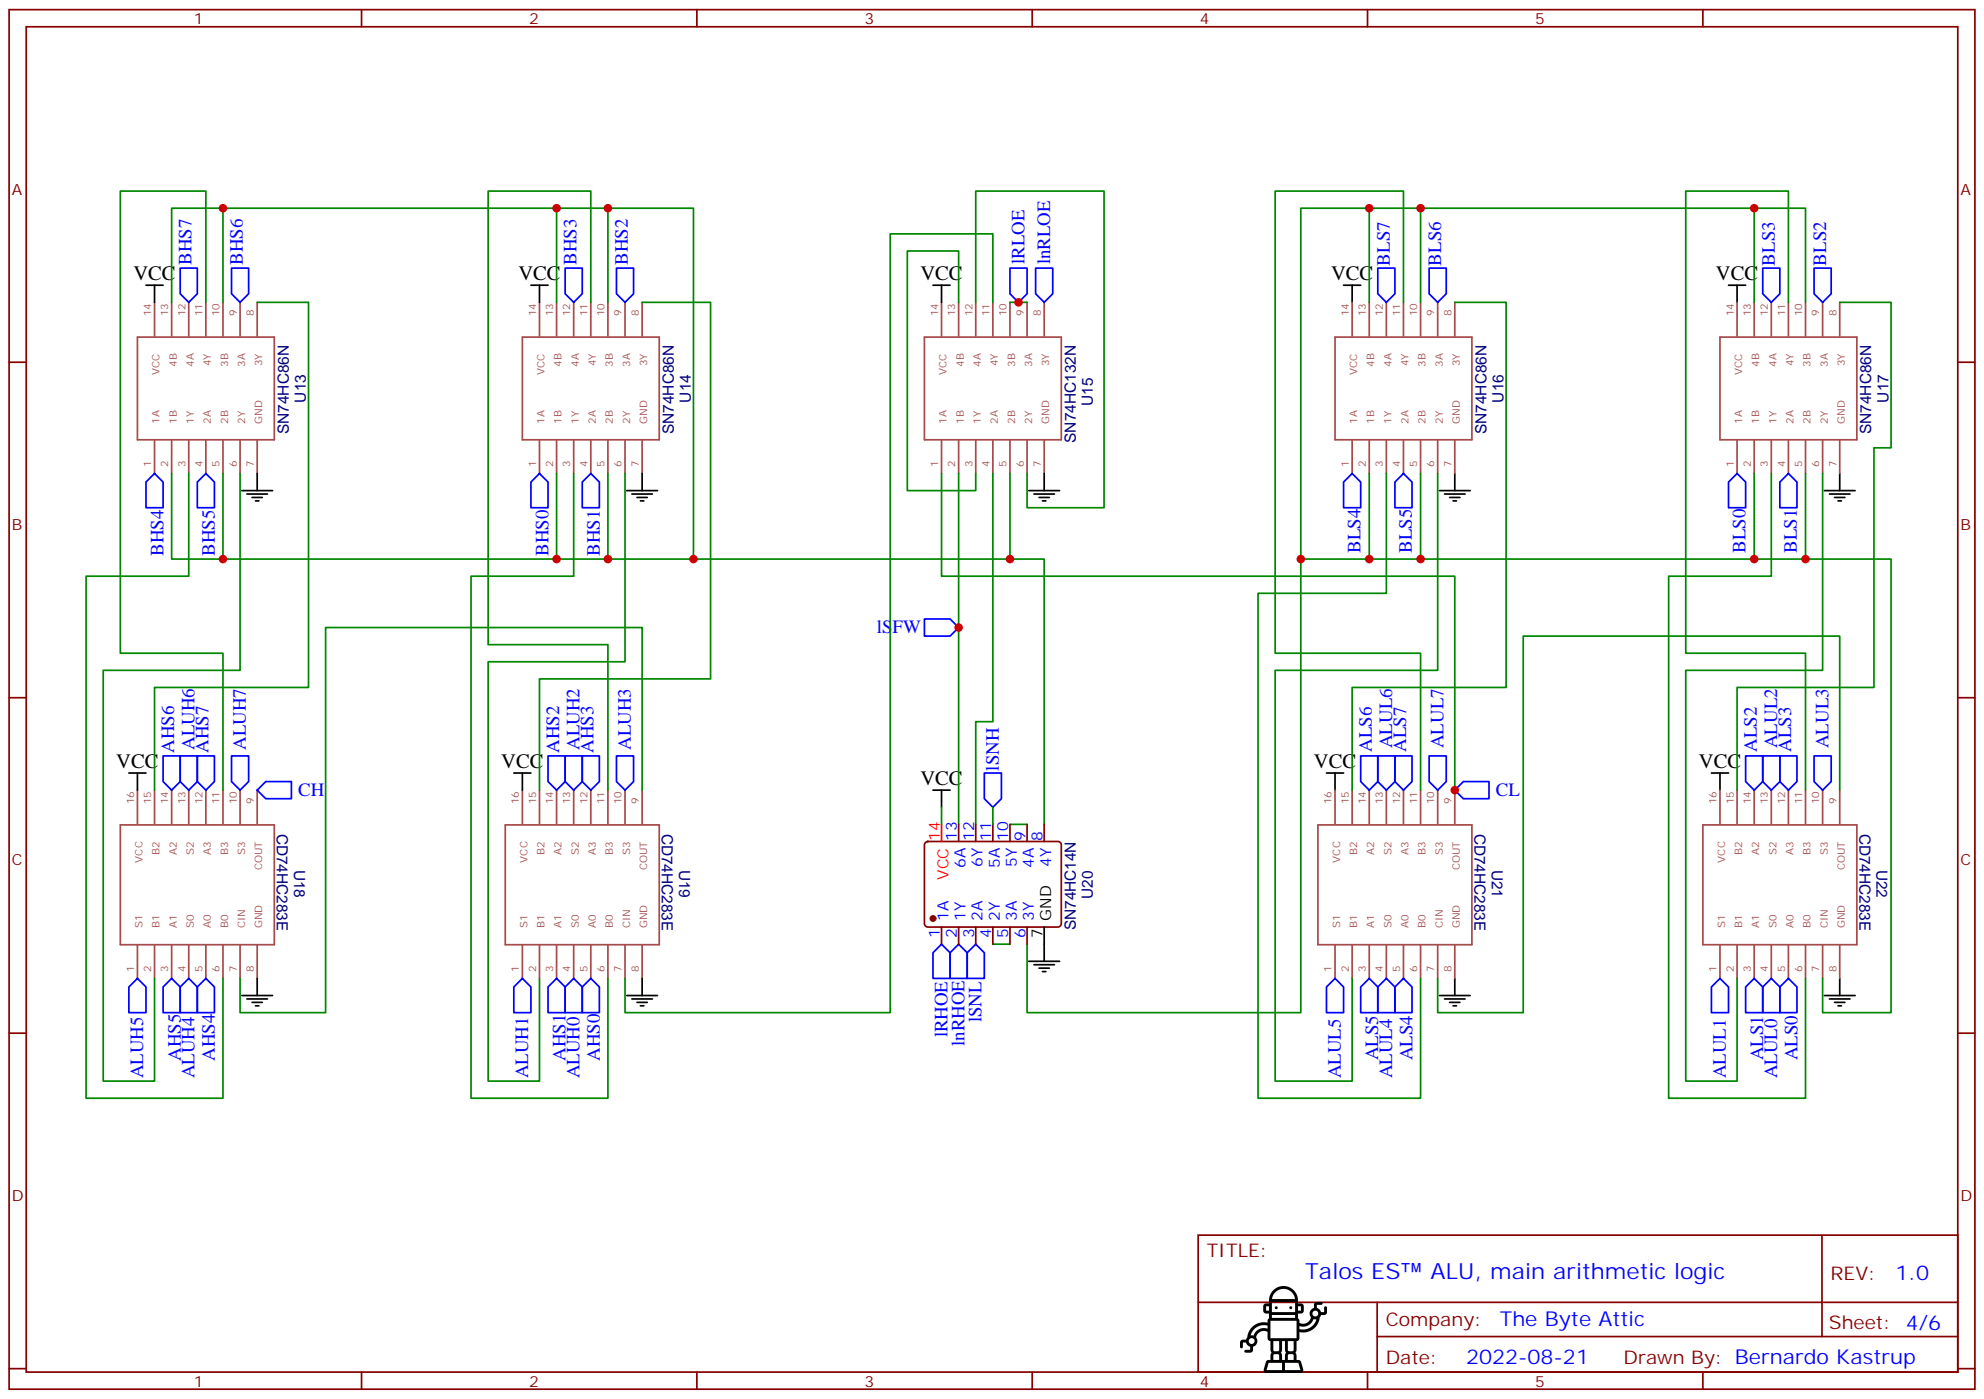
[picture p136: page 4]

A | A

## SN74HC08N

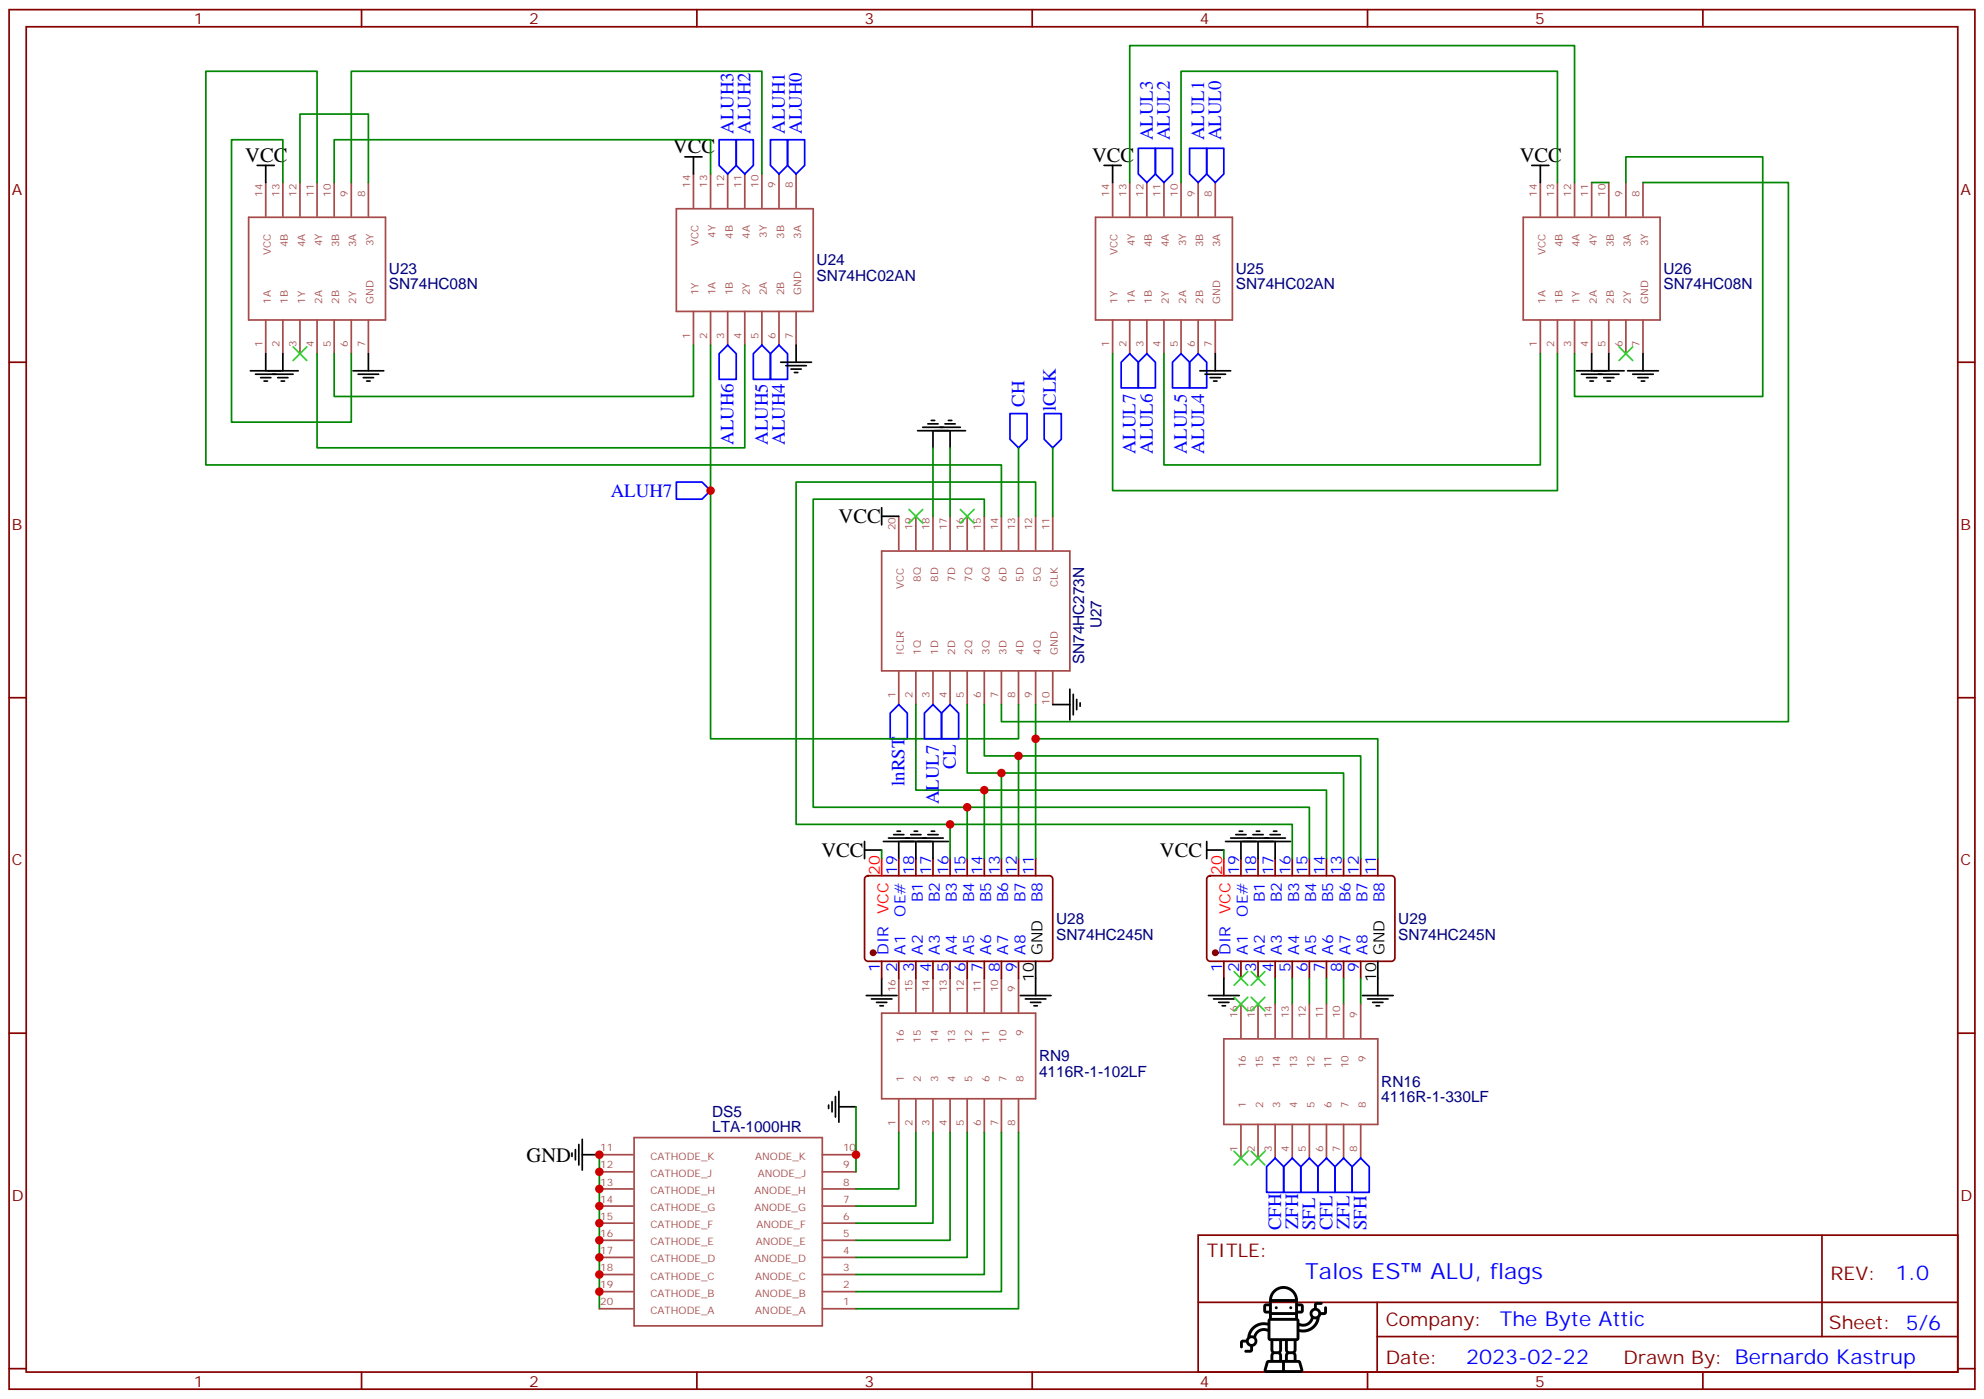
[picture p137: page 5]

17 | 4
18 | 3
19 | 2

A | A
VCC | VCC lCLK lnRST

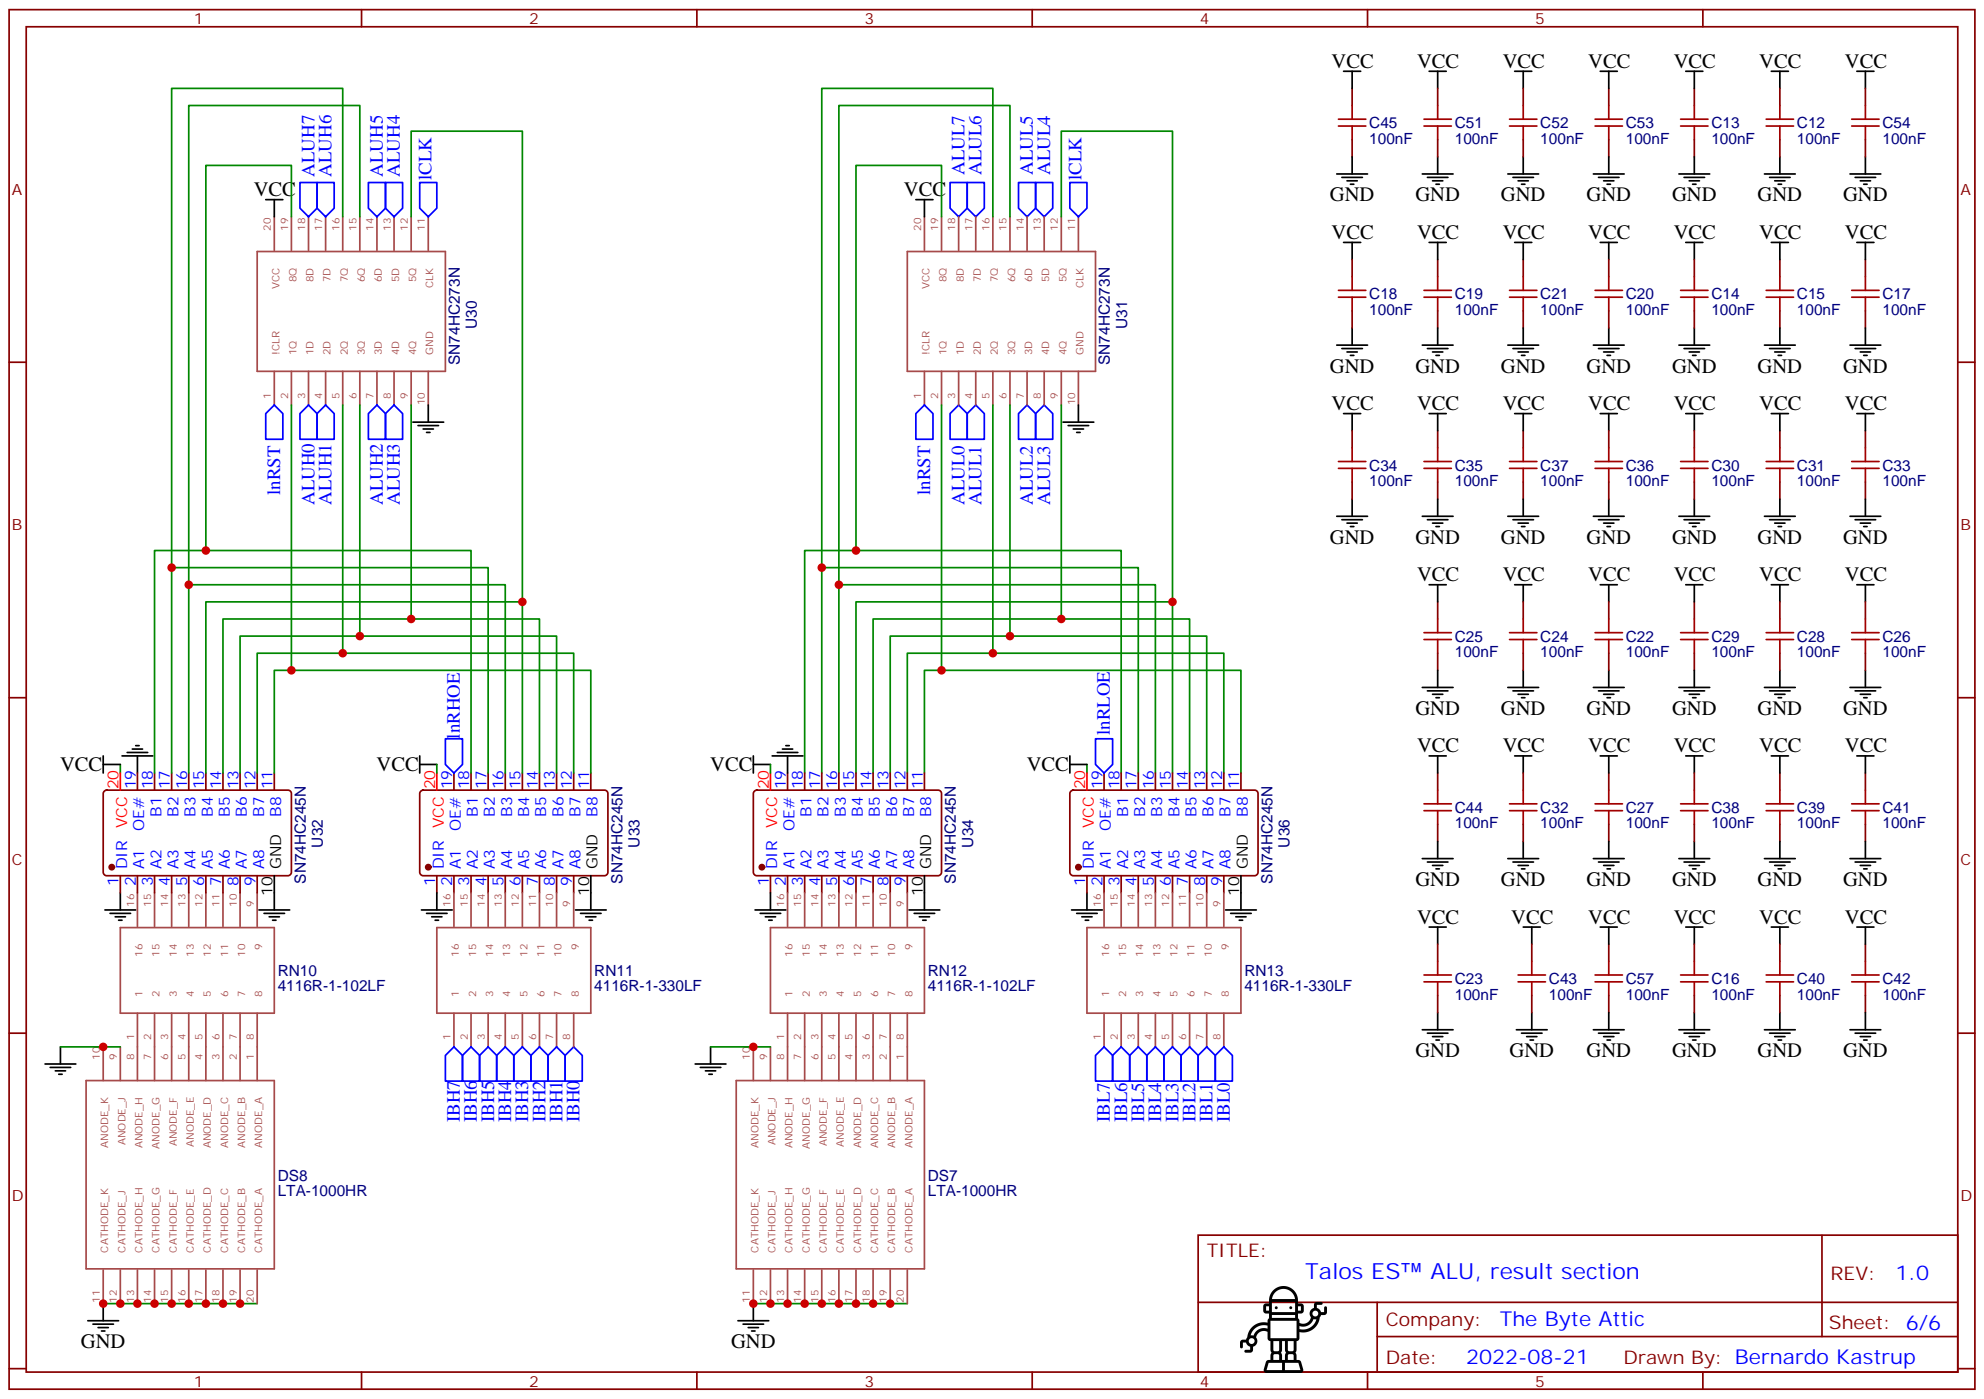
[picture p138: page 6]
