TheByteAttic/TalosES/(list of files, drawings)

Other design files:
Simulations/AL card/TalosES_AL_card.circ
Simulations/AL card/TalosES_AL_testbed.circ
Simulations/ALU card/TalosES_ALU_card.circ
Simulations/ALU card/TalosES_ALU_testbed.circ
Simulations/CTRL card/74245.circ
Simulations/CTRL card/TalosES_CTRL_card.circ
Simulations/CTRL card/TalosES_CTRL_card_testbed.circ
Simulations/CTRL card/TalosES_CTRL_gates.circ
Simulations/Motherboard/clockDivider.circ
Simulations/Motherboard/DEMUX.circ
Simulations/RF card/TalosES_RF_card.circ
Simulations/RF card/TalosES_RF_testbed.circ
